kazushinjo/Serrasoid_TRX_29M/docs/回路図論理チェック.md

# 回路図 論理チェック（第 1 回）

> **注意（2026-10-29）**: この記録の部品番号は、2026-10-29 に部品番号を回路図の位置順に振り直す前の旧番号です。現在の番号との対応は [`kicad/refdes_map_2026-10-29.csv`](../kicad/refdes_map_2026-10-29.csv) を見てください。

> **注意（2026-10-16）**: この記録の部品番号は、2026-10-16 に部品番号を回路図の位置順に振り直す前の旧番号です。現在の番号との対応は [`kicad/refdes_map_2026-10-16.csv`](../kicad/refdes_map_2026-10-16.csv) を見てください。

- 対象: `kicad/Serrasoid_TRX.kicad_sch`（回路一覧 `tools/circuit.py`）
- 実施日: 2026-10-15
- 方法: ブロックごとに、定数・ピン配置・電圧・電流・極性を計算とデータシートで確認
- 結果: 誤り・不備 9 件を修正。ERC 違反なし、回路図と回路一覧の接続照合 655 ピン一致。実機は未製作

## 修正した項目

| # | ブロック | 内容 | 修正 |
|---|---|---|---|
| 1 | 制御 | リレー駆動 2SC1815 のベース電流が約 0.5mA。G5V-2（12V、約 42mA）を飽和させるには hFE 最小値で足りない | ベース抵抗 4.7kΩ → **1kΩ**（約 2.6mA） |
| 2 | セラゾイド変調 | MAX913 の出力は TTL（High 2.4〜3.4V）。74HC123 の High 入力（5V 時 3.5V 以上）を満たさない | ワンショットを **74HCT123** に |
| 3 | セラゾイド変調 | MAX913 の LE（5 番）は「High または開放でラッチ、Low で比較動作」（データシート） | ジャンパ J7 を廃止し **LE を GND に固定** |
| 4 | 逓倍 | XOR 逓倍の遅延を「出力周期の 1/4」で計算していた。正しくは**入力周期の 1/4**（出力のデューティ 50%）。旧定数では約 25% | 遅延を 273 / 137 / 68 / 34 / 17ns に（3.9k / 1.8k / 910 / 510 / 330Ω と 100 / 100 / 100 / 82 / 47pF、74AC14 の遅れ約 6ns 込み） |
| 5 | 逓倍 | RC で遅らせたなまった波形を 74AC86 に直接入れていた。AC 品は入力の立ち上がりが遅いと発振・誤動作する | RC の後にシュミットの **74AC14** を入れて整形（反転しても XOR の出力は 2 倍のまま） |
| 6 | 送信RF | 2N3866 のベース分圧（4.7k / 1k）の電流 約 1.4mA が、ベース電流（約 2mA、hFE 25）より小さく、バイアスが下がる | **560Ω / 120Ω**（分圧電流 約 12mA、Ic 約 40mA） |
| 7 | 送信RF | 出力トランス 1:4（ドレイン負荷 12.5Ω）では 13.8V で最大 約 6W しか出ない | **2T:5T（1:6.25、約 8Ω）**で約 10W |
| 8 | 受信 | 2N3819 の Idss のばらつき（2〜20mA）で、ドレイン抵抗 1k の電圧降下が大きいとドレインとソースの電位差がなくなる | ドレインを **10µH チョーク給電**にし、1k は並列の負荷（利得を約 8dB に抑える）に |
| 9 | 受信 | MC3361 の水晶・220pF・6／7 番のコンデンサを GND に落としていた（交流的には同じ） | データシートの試験回路どおり **VCC（+5VA）** へ。ディスクリミネータのダンピングは 20kΩ（データシート値） |

## 確認して問題がなかった項目

### 電源
- L7808 の損失: 送信時 約 110mA × 5.8V ≒ 0.64W（小型放熱器で可）。L7805 は約 50mA × 3V ≒ 0.15W
- L7805 の入力 8V（ドロップアウト 2V に対して 3V の余裕）。78L05 の入力 8V（1.7V に対して 3V）
- LP2950-3.3 の出力コンデンサ 10µF（1µF 以上が必要）
- 電解コンデンサの向き（＋側）と耐圧（13.8V 系は 25V 以上、8V 系は 16V 以上）
- TO-92 / TO-220 のレギュレータのピン順（L78L05・LP2950: 1=出力 2=GND 3=入力、L78xx: 1=入力 2=GND 3=出力）

### 制御
- ESP32-C3 の起動設定ピン: D0（GPIO2）・D8（GPIO8）・D9（GPIO9）はすべて 10k で High に引いてあり、起動時に High
- D10（リレー）・D7（ミュート）は 10k で Low に引いてあり、起動中にリレーが入らない・音が出る
- ADC は D1（GPIO3）・D2（GPIO4）とも ADC1。入力は 3.1V 以下（ノイズ検出は 10k / 22k で分圧、出力検出は最大 約 1.2V）
- 秋月 AE-Si5351A のピン配置（1 VDDO、2 SCL、3 SDA、4 GND、5 CLK0、6 CLK1、7 CLK2、8 VDD）と電源（VDD 2.5〜3.3V）は秋月の資料どおり
- リレーの接点: 1 極目 COM 4・NC 6（受信）・NO 8（送信）、2 極目 COM 13・NC 11（RX8V）・NO 9（TX8V）

### セラゾイド変調
- 74HCT4017 は Si5351 の 3.3V 出力を受けられる（High 入力 2.0V 以上）。9.16MHz は最高動作周波数の範囲内
- 定電流源: ベース 3.7V、エミッタ 4.35V、電流 260〜430µA。のこぎり波の振幅 約 2.45V（100pF ＋ 浮遊容量 約 20pF）で、2SA1015 が飽和しない（コレクタ上限 約 4.0V）
- MAX913: 単電源 5V（V- = GND）、入力範囲 -0.2〜+3.5V にのこぎり波（0〜2.45V）としきい値（約 1.2V）が入る。DIP-8 のピン配置は 1 V+、2 IN+、3 IN-、4 V-、5 LE、6 GND、7 Q、8 Q̄
- 74HCT123: B 入力（2 番）の立ち上がりでトリガ（A = GND、Clr = High）。時定数 4.7k ＋ 10k 半固定 × 100pF で約 300〜760ns（目標 546ns）。2 回路目は入力を固定

### 送信音声
- MCP6004 のピン（A: 1/2/3、B: 7/6/5、C: 8/9/10、D: 14/13/12、電源 4/11）と、＋入力の直流がすべて VREF（2.5V）
- 3kHz LPF（サレンキー）: fc 約 3.3kHz、Q 約 0.73
- 偏移: しきい値 ±27mV でエッジが ±10.8ns 動き、変調部で ±0.062rad、×32 で ±2rad。3kHz で約 ±6kHz（VR で ±5kHz に合わせる。最大は ±55mV）

### 送信RF
- BPF: T-30-6（AL 3.6nH/T²）17 回で約 1.04µH、29.3MHz の同調に約 28pF（22pF ＋ トリマ）
- RD06HHF1・RD16HHF1 のピン（1 ゲート、2 ソース、3 ドレイン、フィン = ソース）。ゲートバイアスは 0〜4.8V で調整可
- ドレインチョーク: FT37-43 10 回 約 35µH、FT50-43 8 回 約 33µH（29MHz で数 kΩ）
- 入力スワンプ 100Ω 1W × 2 の損失は 1 本 約 0.5W
- LPF: 7 次チェビシェフ（0.1dB リプル、fc 32MHz）の計算値 120p / 0.354µH / 208p / 0.391µH（使う値 120p・220p・T50-6 9 回／10 回）
- 出力検出: 10W（31.6Vp）で容量分割後 約 1.4Vp、検波後 約 1.2V

### 受信
- SA612: 電源 5V（4.5〜8V）、局発入力 約 0.3Vp-p（1k / 100Ω の分圧）。局発 18.6MHz（下側）、イメージ 7.9MHz は BPF で落ちる
- MC3361 のピン配置と周辺はデータシート（Motorola MC3361B、Figure 1 試験回路）と照合。第 2 局発 10.245MHz で 455kHz
- LM386: 2 番 GND、3 番入力、電源 RX8V（4〜12V）、出力 220µF、ゾーベル 10Ω ＋ 0.047µF
- スケルチ: ノイズを 7kHz 以上の HPF・利得 47 で増幅し、倍電圧検波（最大 約 4.4V → 分圧で 3.0V）

## 実物で確認が必要な項目

| 部品 | 内容 |
|---|---|
| 10M15A（FL1） | 足の数と順番（基板は HC-49/U 3 本足、1 入力・2 GND・3 出力） |
| CFWLA455KFFA（FL2） | 足の順番（基板は 2.54mm ピッチ 3 本、1 入力・2 GND・3 出力） |
| CDBM455C24（X2） | 2 端子品であること、足のピッチ（基板は 5mm） |
| 2N3819（Q7） | メーカーで足の順番が違う（Fairchild: 1 D 2 G 3 S、onsemi: 1 S 2 G 3 D）。JFET はドレインとソースが対称なので、どちらでも動作はする |
| G5V-2 | コイル定格（標準品 12V 約 42mA）。高感度品でも 1k のベース抵抗で動く |

## ファームウェア側で守ること
- 送信開始: TX_EN（リレー）→ 約 10ms 待つ → CLK1 停止・CLK0 出力。送信終了: CLK0 停止 → 約 10ms 待つ → リレー戻し → CLK1 出力（リレー接点に RF を流したまま切り替えない）
- PTT（D8）・エンコーダ SW（D9）を押したまま電源を入れない（起動設定ピン）

---

# 回路図 論理チェック（第 2 回）

- 実施日: 2026-10-16
- 対象: KiCad で手修正した回路図（4cc1232）。ブロックごとに見直し、データシート（ESP32-C3 の起動設定ピン、SA612 の局発入力、LM386、MAX913）と照合
- 結果: 2 件を修正。ERC 違反なし、接続照合 655 ピン一致、基板（配置・配線を作り直し）DRC エラー 0・未接続 0・回路図との食い違い 0

## 修正した項目

| # | ブロック | 内容 | 修正 |
|---|---|---|---|
| 1 | 制御 | XIAO の D0（GPIO2）は起動設定ピンで、電源投入時に High が必要（GPIO2・GPIO9 が High でフラッシュ起動）。D0 にエンコーダ B 相をつないでいたので、つまみの止まった位置で B 相が GND に落ちていると起動しない | ピンの割り当てを入れ替え: **D0 = PTT 入力**（ふだん開放で High）、**D8 = エンコーダ B 相**（GPIO8 はフラッシュ起動に関係しない） |
| 2 | 受信 | SA612 の局発入力（6 番）はデータシートで 200〜300mVp-p。R54 1kΩ・R55 100Ω の分圧で約 0.30Vp-p と上限ちょうど | **R54 を 1.2kΩ** に（約 0.25Vp-p） |

## 注意点として記録した項目（回路は変更なし）

- C58（RD16HHF1 の出力の DC カット）には約 1.6Arms 流れる。円板ではなく積層セラミック（X7R、100V）を使う（部品表の備考に記載）
- MAX913 にはヒステリシスがない。のこぎり波は速くしきい値を通り過ぎるので通常は問題ないが、出力がばたつく場合は小さな正帰還を足す
- PTT・エンコーダ SW を押したまま電源を入れると起動しない
- 起動時に D6（UART TX）から ESP32 の起動ログが出る（TJC 表示器は無視する）
- 逓倍の遅延は 74AC14 のしきい値（電源の約 0.6 倍 / 約 0.4 倍）と 0.69RC ＝ 入力周期の 1/4 の組み合わせで、安定したあとちょうど 1/4 になる。しきい値の個体差でデューティは少しずれることがある（BPF で落ちる成分）
  - **訂正（2026-10-29）**: 「BPF で落ちる」は誤り。デューティのずれは基準周波数おきの側帯波になり、29.3MHz の隣（±0.92・±1.83MHz）にも出る。2 段の BPF（2pF 結合で過結合）ではほとんど落ちない。下の追補（スプリアス対策）を参照

---

# 回路図 論理チェック（追補: 第 1 混合を NJM2594V に変更）

- 実施日: 2026-10-16
- 内容: SA612AN が製造中止で入手が難しいため、第 1 混合を秋月で買える **NJM2594V**（日清紡マイクロデバイス、ダブルバランスドミキサ、SSOP8）に替え、変換利得の差（SA612 約 +14dB → NJM2594 0dB）を **10.7MHz 増幅 1 段**（2SC1815）で補った。NJM2594V はこの機械で唯一の表面実装部品（ユーザーが了承）
- 照合したデータシート: NJM2594（秋月 njm2594_j.pdf、応用回路「エミッタ・フォロア出力タイプ」）
- 結果: 回路図と circuit.py の照合 678 ピン一致、ERC 0。部品番号は回路図の位置順に振り直し（対応は `kicad/refdes_map_2026-10-16.csv`。追加 11 点、U13 は SA612AN → NJM2594V）

## 接続（データシートとの照合）

| ピン | 名前 | つなぎ先 | データシート |
|---|---|---|---|
| 1 | V+ | +5VA（C53 0.1µF） | 4.5〜9V、11mA |
| 2 | OUTPUT1 | 開放 | エミッタフォロワ出力型では開放 |
| 3 | OUTPUT2 | R48 1kΩ（GND）、C68 → 10.7MHz 増幅 | 負荷抵抗を外付け。RL ≒（V+ − 1.7）÷ Ii → Ii 約 3.3mA（最大 10mA） |
| 4 | GND | GND | |
| 5 | SIGNAL | C63 0.01µF ← 2N3819 のドレイン | 入力 600Ω。0.01µF は 29.3MHz で 0.5Ω |
| 6 | BYPASS | C67 0.1µF（GND） | 信号・キャリアの両方で十分低いインピーダンスに |
| 7 | CARRIER | C64 0.01µF ← R41 1.2kΩ / R45 100Ω ← CLK1 | 入力 1200Ω。規格は 100mVrms（−7dBm）、約 100mV 以上で出力一定 |
| 8 | NC | GND | 接地または開放 |

## 計算

- 局発: CLK1 は 3.3Vp-p の方形波で基本波 約 1.49Vrms。R45 100Ω と入力 1200Ω の並列 92Ω に対し R41 1.2kΩ で約 1/14 → **約 106mVrms**（規格 100mVrms とほぼ同じ）。3 倍の高調波 55.8MHz との混合（45.1MHz・66.5MHz）は受信 BPF の外
- RF 増幅: 2N3819 のドレイン負荷は R42 1kΩ と NJM2594 の入力 600Ω の並列で約 375Ω（SA612 のとき約 600Ω）。利得は約 4dB 下がる
- 10.7MHz 増幅（Q6 2SC1815、エミッタ接地）: ベース R51 22k / R52 4.7k で約 1.41V、エミッタ R54 82Ω ＋ R55 180Ω（C70 でバイパス）で Ie 約 2.9mA、コレクタ R53 1.5kΩ で Vc 約 3.65V（Vce 約 2.9V）。利得 ≒ 1.5k ÷（82 ＋ 9）≒ 16（24dB）、水晶フィルタの入力を負荷にして約 18〜21dB
  - 10.7MHz での 2SC1815 の hfe は fT 80MHz ÷ 10.7 ≒ 7.5 なので入力は約 0.6kΩ。NJM2594 のエミッタフォロワで十分に駆動できる
- 利得の合計（RF 増幅 ＋ 混合 ＋ 10.7MHz 増幅）: 変更前 約 8 ＋ 14 ＝ 22dB、変更後 約 4 ＋ 0 ＋ 20 ＝ 24dB でほぼ同じ
- 電源: +5VA（78L05、100mA）は NJM2594 11mA を足しても余裕。RX8V は 10.7MHz 増幅の約 3mA が増える

## 注意点（実機で確認）

- NJM2594 の雑音指数はデータシートに記載がない。感度が足りなければ R42（RF 増幅の負荷）を外して RF 増幅の利得を上げる
- 10.7MHz 増幅の負荷 R53 1.5kΩ は水晶フィルタ 10M15A の入力側の終端を兼ねる。実物の規格（終端インピーダンス）に合わせて調整する
- 10.7MHz 増幅の発振: 水晶フィルタの入出力を近づけない（基板で確認）
- NJM2594V は SSOP8（0.65mm ピッチ）。部品面に、周りの部品より先に手はんだで付ける

# 回路図 論理チェック（追補: スプリアス対策、Ver 1.2）

- 実施日: 2026-10-29
- 対象: セラゾイド変調・逓倍・PLL（新設）・送信 BPF。部品番号は 2026-10-29 の振り直し後の番号（[`kicad/refdes_map_2026-10-29.csv`](../kicad/refdes_map_2026-10-29.csv)）
- 方法: 逓倍の各段（RC 遅延 → 74AC14 → XOR）を時間領域で計算し、部品のばらつき（R・C ±5%、配線容量 4〜8pF、74AC14 のしきい値、ゲートの遅延 ±1ns）を乱数で 200 通り与えてスペクトルを求めた。BPF・LPF・PLL は伝達関数で掛けた
- 結果: ERC 違反なし、接続照合 835 ピン一致。実機は未製作

## Ver 1.1 の見積り（対策前）

| 周波数 | アンテナ端（設計値） | 備考 |
|---|---|---|
| 27.47MHz（−1.83MHz） | −13.5dBc | 10W なら約 0.45W |
| 31.13MHz（+1.83MHz） | −22.7dBc | |
| 高調波（58.6MHz 以上） | −80dBc 以下 | 7 次 LPF（PA の非線形は含まない） |

- ばらつき込みでは側帯波が搬送波と同じくらいになる。逓倍の途中でエッジが欠け、×32 の出力の周波数そのものが狂う組み合わせも多い
- 規格（30MHz 以下: 50mW 以下かつ −50dBc）を満たすには、最終段のエッジのずれを約 34ps 以下にする必要があり、部品のばらつきでは無理

## 対策（3 つとも入れた）

| 対策 | 内容 | 主な部品 |
|---|---|---|
| 逓倍数を減らす | CLK0 を 18.3125MHz にして ÷10 で 1.83125MHz、×16（4 段）。側帯波の間隔が 1.83MHz に広がる | C71 100p → 68p、R67 4.7k → 2.2k、VR5 10k → 5k（ワンショット 273ns）、段 1（3.9k・100p）と 2 個目の 74AC86 を外した |
| 段間同調 | 段 1〜3 の XOR 出力を LC 並列共振（Q 約 5、調整なし）で正弦波にし、自己バイアスの 74HCU04 で平均値を境に矩形へ戻す（後ろに 74AC14） | 10µH・180p / 4.7µH・100p / 1µH・120p、駆動 1k・1k・470Ω、U22 74HCU04、U23 74AC14 |
| PLL 追従フィルタ | ×16 の出力に 29.3MHz の VCO を位相同期させ、VCO を送信する。ループ帯域 約 37kHz | U1 74AC74・U3 74AC00（位相周波数比較）、U7 MCP6002（差動積分）、U11 74HCU04（VCO 専用）、L5 T50-6 15T、D4 1N4007（可変容量）、TC3 |

あわせて送信 BPF の段間結合を 2pF → 1pF（C80）。29.0〜29.7MHz の偏差 0.6dB 以内、±1.83MHz で −14〜−17dB。

## 計算

- ×16 の出力（PLL の前）: 同調なしでは 200 通り中 160 通りでエッジが欠ける。同調ありでは 0 通り、側帯波は中央 −11.5dBc
- PLL: Kd ＝ 5V/2π ≒ 0.8V/rad、Kv ≒ 0.2MHz/V（1N4007、0.5〜4.5V で約 20〜9pF、47p で結合）、τ1 ＝ 11.2k × 0.01µ、τ2 ＝ 1.5k × 0.01µ、極 258kHz（入力 RC）・339kHz（出力 RC）・MCP6002 の GBW。閉ループ −3dB 約 37kHz（Kv が半分〜2 倍で 21〜75kHz）、3kHz での利得 ＋0.3dB
- PLL の減衰: ±0.5MHz −40dB、±1.83MHz −77dB、±3.66MHz −100dB
- アンテナ端（PLL・BPF・LPF 後、±1〜8 × 1.83MHz の側帯波）: 中央 −110dBc、悪い 5% −103dBc、最悪 −99dBc
- 偏移: ×16 なので変調部の位相は ±0.104rad（3kHz で ±5kHz）。のこぎり波（68p ＋ 浮遊 約 20p、約 300µA）は約 3.4V/µs、エッジ ±9ns はしきい値 ±31mV。音声の最大 ±55mV に収まる
- VCO: L5 約 0.9µH、C 側 27p ＋ TC3 ＋ 可変容量、出力側 56p ＋ 浮遊 で直列 約 31pF → 約 29.3MHz（TC3 で合わせる）。可変容量の範囲は約 0.8MHz（29.0〜29.7MHz をほぼ覆う）

## 注意点（実機で確認）

- 74HCT4017 を 18.3MHz で動かす（最高クロックは 5V・最悪条件で約 20MHz）。分周がおかしいときは CLK0 の波形（リンギング）と電源電圧を見る
- 1N4007 の接合容量は品物で違う。29.0MHz と 29.7MHz で VT（TP1）が 0.5〜4.5V に入るか確かめる。足りなければ C35（47p）を大きくするか、可変容量ダイオードに替える
- 受信中は Q3 で VCO を止める。受信で 29.3MHz 付近に自局の VCO が聞こえないことを確かめる
- 受信中、74HCU04（U22）の同調側の 3 回路はしきい値付近に止まり、少し電流が流れる（数 mA）。後ろはシュミットの 74AC14 なのでばたつかない
- PLL が外れると VCO が勝手な周波数で出る。送信前に VT が張り付いていないことを見る（ファームウェアで VT を読む線は今はない）
- 受信 BPF も 2pF 結合（過結合）のまま。受信は帯域が広くても実害が小さいので変えていない

# 回路図 論理チェック（追補: S メーターの追加、Ver 1.2）

- 実施日: 2026-10-29
- 理由: MC3361 には受信電界強度（RSSI）の出力がなく、スケルチ用ノイズの減り方からの S 表示は S5 前後で頭打ちになる。S9 より上まで振れる S メーターにするため、対数増幅 IC を足した（ユーザーが案 B を選択）
- 結果: ERC 違反なし、接続照合 888 ピン一致。実機は未製作

## 回路

| 部分 | 部品 | 内容 |
|---|---|---|
| 取り出し | R1 2.2k、C8 0.01µ | 10.7MHz 水晶フィルタの出力（IF1、MC3361 の 16 番）から取る。増幅の入力（約 2.5kΩ）と直列で、フィルタの終端に重い負荷をかけない（約 −5dB） |
| 同調増幅 | Q1 2SC1815、R4 22k・R5 4.7k（ベース 約 1.4V）、R6 27Ω（帰還）・R7 220Ω＋C18、L3 4.7µH・C23 47p | Ic 約 3mA。負荷は同調回路と AD8307 の入力 1.1kΩ で約 0.75kΩ、利得 約 21 倍（26dB）。同調（約 10.7MHz、Q 約 2）は AD8307 に広帯域の雑音を入れないため |
| 対数増幅 | U9 AD8307ANZ（DIP-8）、C26・C27 0.01µ（入力の結合）、C30 0.01µ（OFS）、R17 10Ω・C38 0.1µ（電源） | 25mV/dB、測れる範囲 −75〜＋17dBm（データシート）。+5VA（受信中だけ）。INT は開放、ENB は VPS へ |
| 出力 | C40 0.1µ、U13 ADS1115 モジュール（A0） | 出力抵抗 12.5kΩ と 0.1µ で約 1.3ms。ADS1115 は +3V3X、±4.096V レンジ（1LSB = 0.125mV = 0.005dB）。I2C アドレス 0x48（Si5351 は 0x60） |

## 計算

- 受信の利得（アンテナ → IF1）: 受信 BPF −2dB、2N3819 約 ＋4dB、NJM2594 0dB、10.7MHz 増幅 約 ＋19dB、水晶フィルタ −3dB → 約 ＋18〜19dB
- AD8307 の入力: S9（−73dBm）で約 −73 ＋ 19 − 5 ＋ 26 ＝ **約 −33dBm** → 出力 25mV ×（−33 ＋ 84）≒ **1.27V**（スケッチの `RSSI_MV_S9` の初期値 1275mV）
- 下限 −75dBm は S9 より 42dB 下 ≒ **S2**、上限 ＋17dBm は S9 ＋ 50dB。受信の前段（NJM2594・10.7MHz 増幅）が飽和する手前の **S9＋40 程度**までが目安
- ADS1115 の入力は 0.2〜2.5V で、+3V3X（3.3V）を超えない

## 注意点（実機で確認）

- S9 の電圧（`RSSI_MV_S9`）は、信号発生器で −73dBm を入れてシリアルモニタの `rssi` の値で合わせる
- R1 2.2kΩ を付けたことで、水晶フィルタ（10M15A）の終端が少し変わる。受信音のひずみ・帯域が変わらないか確かめる。気になるときは R1 を 4.7kΩ に（S メーターの下限が 6dB 上がる）
- Q1 の同調増幅が発振しないか（入出力の線を近づけない）
- ADS1115 モジュールは Adafruit 1085 と同じピン並び（VDD GND SCL SDA ADDR ALRT A0 A1 A2 A3）のものを使う。並びの違う品は差し替えない
- スケッチは ADS1115 が見つからないとき、ノイズの減り方からの S 表示に切り替わる

# 回路図 論理チェック（追補: 入手しにくい部品の置き換え、Ver 1.2）

- 実施日: 2026-10-29
- 理由: 74HCT4017（製造中止）、MAX913（製造中止扱いの販売店が多い）、2N3866（製造中止）が手に入りにくいため（ユーザーの依頼）
- 結果: ERC 違反なし、接続照合 875 ピン一致。実機は未製作

| 取り外した部品 | 代わり | 内容 |
|---|---|---|
| 74HCT4017（18.3125MHz を ÷10） | Si5351 の CLK0 を 1.83125MHz に、U19 74HCT123 の 2 回路目でリセットパルス | CLK0 の立ち上がり（2B）でトリガ、C84 22p・R75 1.5k で約 50〜100ns。HCT 品なので 3.3V 入力を受けられる。IC が 1 個減る |
| MAX913（高速コンパレータ） | Q9・Q10 2SA1015 の差動対、R74 1.5k（電流源）、R73 1k（負荷） | 電流 約 2.3mA。RAMP > THRESH で COMP_N が約 2.3V → 0V。U19 の 1A（立ち下がり）で PM_OUT を作る（1B・Clr は High） |
| 2N3866（TO-39） | Q11 2N2222A（TO-92） | エミッタ帰還 4.7Ω ＋ 18Ω（旧 10Ω）で約 33mA、コレクタ損失 約 0.24W。fT 250MHz 以上で 29MHz の利得は十分 |

## 計算

- 差動対: エミッタ 約 0.85 ＋ 0.65 ＝ 1.5V、電流 (5 − 1.5) ÷ 1.5k ≒ 2.3mA。切り替わりの幅は入力差 ±4Vt ≒ ±100mV、のこぎり波 3.4V/µs で約 30ns。遅れは一定（位相のずれにならない）
- COMP_N は 0〜2.3V。74HCT123 の入力（Low 0.8V 以下・High 2.0V 以上）に入る
- Q9 のベース電流（約 11µA）がのこぎり波に加わるのは交点の手前だけで、交点付近では毎回同じなので直線性には影響しない（定電流 約 300µA の 4% 程度）
- リセットパルス: 幅が 50〜100ns の間で変わっても、のこぎり波の山（約 1.5〜1.7V）が少し変わるだけ。VR2 で合わせる

## 注意点（実機で確認）

- Q9・Q10 は同じランク（GR）のものを使う。Vbe の差は VR4（しきい値の中心）で吸収
- TP5（COMP）の波形がばたつくときは、R73 に 10pF 程度を並列に
- リセットパルスの幅を TP（2N7000 のゲート）で確かめる。短すぎてのこぎり波が 0V まで戻らないときは C84 を 33p に
- スケッチの CLK0 は送信周波数 ÷ 16（2026-10-29 に変更済み）

# 回路図 論理チェック（追補: 終段を IRF510 プッシュプルに、Ver 1.2）

- 実施日: 2026-10-29
- 理由: RD06HHF1・RD16HHF1 が製造終了（RF Parts の表記で RD16HHF1-501 は 2022 年 12 月 EOL）で、在庫品は偽物の心配もあるため（ユーザーが IRF510 プッシュプルを選択）
- 結果: ERC 違反なし、接続照合 882 ピン一致。実機は未製作

## 回路

| 段 | 部品 | 内容 |
|---|---|---|
| ドライバ | Q12 IRF510（RD06HHF1 から変更）、VR6 | 回路はそのまま（ゲートストッパー 10Ω・スワンプ 47Ω・バイアス TX8V → 3.3k ＋ VR 5k → 1k、ドレインチョーク FT37-43）。アイドル 約 150mA。IRF510 はピンが G-D-S（RD06HHF1 は G-S-D）で、記号・接続を直した |
| 入力トランス | T1 BN43-202、1 次 2 回・2 次 2 回（センタータップ） | ドライバの出力を 2 個のゲートへ逆相に。センタータップに R92 1k でバイアス、C 0.1µ で交流的に GND |
| ゲート | R 10Ω × 2（ストッパー）、R 22Ω 1/2W × 2（各半分のスワンプ） | ドライバから見た負荷 約 44Ω（1:1）。IRF510 の入力容量（約 180pF）を抑えて安定にする |
| ファイナル | Q14・Q13 IRF510、VR7 | AB 級プッシュプル。アイドル 合計 約 100mA。ゲート約 3.5〜4V |
| 出力トランス | T2 BN43-202、1 次 2 回（センタータップから 13.8V）・2 次 3 回 | 1:2.25 でドレイン間 約 22Ω → 50Ω。ドレインの直流は 1 次の両半分を逆向きに流れるので、コアは飽和しない。旧ドレインチョーク（FT50-43）と結合コンデンサは不要になった |

## 計算

- 出力: 13.8V で各ドレインの振幅 約 12V（飽和電圧を引く）、ドレイン間 22Ω → 理論 約 13W。29MHz では IRF510 の利得と効率が下がる（製作例: 28MHz・14V で 2〜6W、QRP Labs のキットは 28MHz で利得が下がると説明）ので、**5W 前後の見込み**
- 駆動: ファイナルの入力に 0.3〜0.5W 程度。ドライバ IRF510（約 10dB）でバッファ 2N2222A の約 30mW から持ち上げる
- 発熱: 5W 出力・効率 40% として、ファイナル 2 個で約 7W、ドライバ 約 2W。3 個ともタブ = ドレイン（+13.8V）なので、絶縁シートと絶縁ブッシングで放熱器から絶縁する
- 高調波: プッシュプルなので偶数次が打ち消し合う（2 倍 −35dBc 程度を仮定）。スプリアスの図は 5W で描き直した

## 注意点（実機で確認）

- 放熱器と各ドレインが導通していないこと（テスター）
- アイドル電流は VR を絞った側（ゲート 0V）から少しずつ上げる。IRF510 はしきい値のばらつきが大きいので、2 個の電流の差が大きいときは選別する
- 出力が足りないときは、ファイナルのバイアスを少し上げる（QRP Labs の説明と同じ）か、出力トランスを 1 次 2 回・2 次 2 回（1:1、ドレイン間 50Ω → 出力は下がるが効率は上がる）と比べる
- 送受切替のリレー・LPF・出力検出は変わらない。出力計の `FWD_MV_10W` は実測で合わせる

# 回路図 論理チェック（追補: ファイナルを MRF101AN に、Ver 1.2）

- 実施日: 2026-10-29
- 理由: IRF510 プッシュプルでは 29MHz・13.8V で 5W 前後しか見込めないため、10W に戻す（ユーザーが MRF101AN を選択）
- 結果: ERC 違反なし、接続照合 875 ピン一致。実機は未製作

## 回路

| 段 | 部品 | 内容 |
|---|---|---|
| ドライバ | Q12 IRF510、VR6 | 前回のまま（アイドル 約 150mA、タブ = ドレインなので HS1 から絶縁） |
| ファイナル | Q13 MRF101AN、VR7 | 単段の AB 級に戻した（RD16HHF1 のときと同じ回路）。ゲートストッパー 10Ω、スワンプ 100Ω 1/2W × 2（50Ω）、バイアス TX8V → 3.3k ＋ VR 5k → 1k。ドレインチョーク FT50-43 8 回、結合 0.1µF（X7R 100V）、出力トランス BN43-202 2 回:5 回（8Ω → 50Ω） |
| 取り除いた部品 | 入力トランス（1:1 センタータップ）・ファイナル B・22Ω × 2・10Ω 1 本・センタータップ付きのフットプリント 2 種 | |

## データシート（NXP MRF101AN Rev. 1）で確かめたこと

- ピン: **1 = ゲート、2 = ソース、3 = ドレイン、タブ（裏面）= ソース**。RD16HHF1 と同じ並びなので、記号（RD_MOSFET_GSD）・フットプリント（TO-220 縦置き）はそのまま。MRF101BN はゲートとドレインが逆なので使えない
- VGS(th) 1.7〜2.7V（標準 2.2V）、VGS(Q) 2.5V（50V・100mA）。ゲートの最大定格は −6〜+10V。バイアス回路の可変範囲は 0〜約 4.8V で、最大定格を超えない
- Ciss 149pF（50V のとき。13.8V では少し大きい）→ 29MHz で約 37Ω。スワンプ 50Ω と並列で入力は 20Ω 前後
- V(BR)DSS 133V、定格 VDD 50V。13.8V では十分な余裕があり、負荷の不整合にも強い（50V で VSWR 65:1 に耐える）
- RθJC 1.1℃/W、PD 182W

## 計算

- 出力: 13.8V、ドレイン負荷 8Ω → 理論 (13.8 − 1)² ÷ (2 × 8) ≒ 10W
- 利得: データシートの 27MHz の例は 50V で 24.9dB。13.8V では下がるので **17dB 前後** と見込む → 10W に必要な入力は 0.2〜0.3W。ドライバ IRF510 で足りる
- 発熱: 10W・効率 55% として約 8W（ケースの放熱器 5〜8℃/W ＋ RθJC 1.1℃/W で、接合部は周囲 + 60℃程度）
- アイドル電流: 約 200mA（ゲート 2.5〜3V）
- スプリアスの図は 10W・単段の仮定に戻した（高調波 最大 −72.5dBc、2 倍）

## 注意点（実機で確認）

- 13.8V での利得・出力はデータシートにない（50V の特性のみ）。出力が 10W に届かないときはドライバのバイアスを少し上げるか、出力トランスを 2 回:4 回（1:4、12.5Ω → 約 7W）と比べて効率を見る
- 利得が大きいので発振に注意。ゲートストッパー 10Ω はゲートのピンの根元に付ける。ドライブなしで出力が出るときは、スワンプを 47Ω × 2 にする
- MRF101AN の静電気（HBM 1000V）に注意。取り付けまで導電スポンジに刺しておく
