kazushinjo/Serrasoid_TRX_29M/docs/基板チェック.md

# 基板チェック（第 1 回）

> **注意（2026-10-29）**: この記録の部品番号は、2026-10-29 に部品番号を回路図の位置順に振り直す前の旧番号です。現在の番号との対応は [`kicad/refdes_map_2026-10-29.csv`](../kicad/refdes_map_2026-10-29.csv) を見てください。

> **注意（2026-10-16）**: この記録の部品番号は、2026-10-16 に部品番号を回路図の位置順に振り直す前の旧番号です。現在の番号との対応は [`kicad/refdes_map_2026-10-16.csv`](../kicad/refdes_map_2026-10-16.csv) を見てください。

- 対象: `kicad/Serrasoid_TRX.kicad_pcb`（回路図から `tools/gen_pcb.py` → `tools/route.sh` で作成。2026-10-16 に論理チェック第 2 回の修正を反映して作り直し）
- 実施日: 2026-10-15
- 結果: **DRC エラー 0、未接続 0、回路図との食い違い 0**。警告はシルク（部品番号の文字の重なり 20・銅箔上 9・基板端 3）のみ。実機・製造データは未作成

## 基板の構成

| 項目 | 内容 |
|---|---|
| 外形 | 170 × 130mm、M3 取付穴 4 か所（四隅から 4mm） |
| 層 | 4 層。表・裏 = 信号（空きは GND ベタ）、内層 2 枚 = GND（GND1・GND2） |
| 部品 | 242 点、すべてリード部品（表面実装なし） |
| 配置 | 機能ブロックごとの区画の中で、配線長が短くなるように自動配置（`tools/place.py`）。固定は DC 入力・ANT・リレー・RD16HHF1 だけ |
| 配線 | Freerouting 1.9.0。線幅: 13.8V 系・PA 出力 1.2mm、電源 0.6mm、RF 0.5mm、ほか 0.3mm |

区画（上辺 = 後面、下辺 = 前面）:

| 区画 | 範囲（mm） |
|---|---|
| 電源 | 左上 0〜40 × 0〜46 |
| 送信RF | 上段 40〜170 × 0〜46（左から BPF → 2N3866 → RD06HHF1 → RD16HHF1 → LPF → リレー → ANT） |
| 逓倍 | 0〜52 × 46〜82 |
| セラゾイド変調 | 52〜112 × 46〜82 |
| 受信 | 右列 112〜170 × 46〜130 |
| 制御 | 左下 0〜56 × 82〜130 |
| 送信音声 | 56〜112 × 82〜130 |

## 確認した項目

- 回路図との一致（DRC の schematic parity）: 食い違いなし
- 13.8V（最大 約 2.5A）の線幅 1.2mm: 外層 1oz で約 3A（温度上昇 10℃）まで
- GND: 内層 2 枚のベタで全 GND パッドがつながる。表・裏のベタは熱的接続（サーマル）で 1 本以上（`kicad/Serrasoid_TRX.kicad_dru`）
- RD16HHF1（Q6）は上辺（後面）に、タブを外側に向けて配置
- RD06HHF1（Q5）と放熱器 HS1（20PB020）は PSN_TRX と同じ位置関係
- アンテナ系: J5（ANT）→ K1（リレー）は基板の右上角で短い（ANT 29mm、TX_OUT 48mm）

## 気になる点（製造前に確認・手直しを検討）

| 項目 | 内容 |
|---|---|
| 長い線 | DRV_D（RD06HHF1 のドレイン → RD16HHF1 入力の結合 C）82mm、CLK0 71mm、CLK1 73mm、PM_OUT 58mm、RAMP 53mm。29MHz の波長（約 10m）に比べれば短く電気的には問題ないが、PA 出力と入力系の結合を避けるため、KiCad で目視確認したい |
| RD16HHF1 の取付 | タブは基板端から約 1mm 内側。シャーシの放熱器に当てるには、基板端とタブの位置関係をケースと合わせて決める必要がある |
| L7808・L7805 の放熱 | 縦置き TO-220。小型放熱器（クリップ式など）を付ける空間があるか要確認 |
| シルク | 部品番号の文字の重なり 19 か所（実装には影響しない） |
| 受信部の並び | 自動配置のため、LM386（低周波）が RF 部の近くに来ている。発振・回り込みが出るようなら離す |

## 配置の試行

送信の主要部品（BPF・2N3866・RD06HHF1・トランス）と受信の主要部品も固定して一列に並べる案を試したが、配線長の合計が増え、未接続が 2〜3 本残ったので採用しなかった（`tools/gen_pcb.py` の `fixed_positions` のコメント参照）。

---

# 基板チェック（第 2 回: Ver 1.1、第 1 混合を NJM2594V に変更して作り直し）

- 実施日: 2026-10-16
- 対象: `kicad/Serrasoid_TRX.kicad_pcb`（`tools/gen_pcb.py` → `tools/route.sh`。部品番号は回路図の位置順）
- 結果: **DRC エラー 0、未接続 0、回路図との食い違い 0**。警告はシルク（文字の重なり 33・銅箔上 10・基板端 4）のみ

## 変更点

| 項目 | 内容 |
|---|---|
| 部品 | 253 点（＋取付穴 4・放熱器 HS1）。第 1 混合 U13 を SA612AN（DIP-8）から **NJM2594V（SSOP8、0.65mm ピッチ、表面実装）** に。10.7MHz 増幅（Q6 2SC1815 ほか 10 点）を追加 |
| 表面実装 | U13 だけ（部品面）。`gen_pcb.py` は NJM2594V 以外の表面実装パッドがあると止まる |
| U13 の GND | 4 番から外側へ 1.8mm の線とビアで内層の GND へ（`tools/pcb_smd_gnd.py`。0.65mm ピッチのパッドの間には外層の GND ベタが入らない）。8 番（内部で未接続）は開放 |
| +5VA の線幅 | 0.6 → **0.3mm**（約 25mA。0.6mm では U13 のパッドに隣のパッドとの間隔 0.25mm を取ってつなげない） |
| 配置 | ミキサー出力 → 10.7MHz 増幅 → 水晶フィルタのネットの重みを大きくし、1 か所にまとめた（U13〜Q6 16.6mm、Q6〜FL1 12.1mm） |
| 上辺の部品禁止 | ケースの RD16HHF1 用放熱器のベースが基板の上辺に 1.1mm かかるので、RD16HHF1 の左右（放熱器の幅）の上辺から 1.6mm には部品を置かない（HS1 は上辺から 3.25mm） |
| 配線 | Freerouting 1.9.0 のあと、残った未接続は `tools/fix_route.py`（表・裏 2 層の格子で探して引く。間隔 0.25mm）で引く。今回は CLK1 と C74 の短い線が重なっていたので消して引き直した |

## 製造前に確認すること

- U13（SSOP8）のパッド寸法は KiCad 標準の TSSOP-8_4.4x3mm_P0.65mm（JRC の SSOP8 は本体 3.5 × 4.4mm、足先 6.4mm で同じ寸法）
- 10.7MHz 増幅の入出力の線が近くを通っていないか（発振しないか）、KiCad で目視

---

# 基板チェック（第 3 回: Ver 1.2、スプリアス対策で逓倍の段間同調と PLL を追加）

- 実施日: 2026-10-29
- 対象: `kicad/Serrasoid_TRX.kicad_pcb`（`tools/gen_pcb.py` → `tools/route.sh`）。部品番号は 2026-10-29 の振り直し後（[`kicad/refdes_map_2026-10-29.csv`](../kicad/refdes_map_2026-10-29.csv)）
- 結果: **DRC エラー 0、未接続 0、回路図との食い違い 0**。警告はシルク（文字の重なり 35・銅箔上 22・基板端 14）のみ。配線 合計 約 7.65m、ビア 19

## 変更点

| 項目 | 内容 |
|---|---|
| 外形 | 170 × 130mm → **170 × 140mm**（奥行きを 10mm 伸ばした。部品 305 点、130mm では置き場所が足りなかった）。ケースは基板の前端と前面パネルの間が 32 → 22mm になる |
| 区画 | 電源 0〜40 × 0〜40、送信RF 40〜170 × 0〜46、セラゾイド変調 0〜30 × 40〜100、逓倍 30〜72 × 46〜100、**PLL 72〜122 × 46〜100**、受信 122〜170 × 46〜140、制御 0〜70 × 100〜140、送信音声 70〜122 × 100〜140 |
| 部品禁止 | 後面の DC ジャック（ケース X 27、本体 φ12・奥行き 15mm）の下、基板の左奥（5〜19 × 0〜13mm）。最初の配置で L7808 がここに来て、ケースの assert「DC の本体が基板の部品に当たる」になった |
| 配置の重み | VCO の LC（VCO_IN・VCO_OA・VCO_O・VCO_L・VAR_K）と段間同調（TK1〜3・SQ1〜3）をミキサーと同じ重みにしてまとめた（VCO_O 10mm、VCO_L 11mm、VAR_K 10mm。VCO_IN は Q3・TC3・R24 も含めて 77mm） |
| 線幅 | TXOSC（VCO → 送信 BPF）を 0.5mm（RF） |
| シルク | Ver 1.1 → Ver 1.2 |

## 製造前に確認すること

- 区画から少しはみ出した部品が 12 点ある（区画の境目、隣の区画側）。機能上の問題はないが、KiCad で目視
- VCO（U11・L5・TC3・D4 のまわり）の近くに、逓倍のロジックの線（X16・TK3 など）が並走していないか
- 74HCU04（U22・U11）と 74AC14（U20・U23）の取り違えに注意（ピン配置は同じ）

---

# 基板チェック（第 4 回: Ver 1.2、S メーター（AD8307・ADS1115 モジュール）を追加）

- 実施日: 2026-10-29
- 対象: `kicad/Serrasoid_TRX.kicad_pcb`（`tools/gen_pcb.py` → `tools/route.sh`）。部品番号は 2026-10-29 の 3 回目の振り直し後（[`kicad/refdes_map_2026-10-29.csv`](../kicad/refdes_map_2026-10-29.csv)）
- 結果: **DRC エラー 0、未接続 0、回路図との食い違い 0**。警告はシルク（文字の重なり 39・銅箔上 15・基板端 7）のみ。配線 合計 約 8.43m、ビア 32

## 変更点

| 項目 | 内容 |
|---|---|
| 外形 | 170 × 140mm → **170 × 150mm**（S メーターの部品 19 点と ADS1115 モジュールで置き場所が足りなくなった）。ケースは基板の前端と前面パネルの間が 12mm になる（干渉チェック通過） |
| 区画 | 電源 0〜40 × 0〜40、送信RF 40〜170 × 0〜44、セラゾイド変調 0〜30 × 40〜104、逓倍 30〜72 × 44〜104、PLL 72〜118 × 44〜104、**受信 118〜170 × 44〜150**、制御 0〜70 × 104〜150、送信音声 70〜118 × 104〜150 |
| ADS1115 モジュール | 独自フットプリント `ADS1115_Module_Socket`（ピンソケット 1×10 ＋ モジュールの基板 28 × 17.8mm の範囲を外形に含める）。モジュールの下にほかの部品が来ない |
| 配置の重み | S メーター増幅（RS_IN・RS_B・RS_C・RS_E・RS_INP・RS_INM）をミキサーと同じ重みにしてまとめた |

## 製造前に確認すること

- 区画から少しはみ出した部品が 25 点ある（区画の境目、隣の区画側）。KiCad で目視
- AD8307（U9）の入力の線が、10.7MHz 増幅（Q3 のまわり）や 455kHz の線と並走していないか
- ADS1115 モジュールの向き（ピンの列の +X 側にモジュールの基板が乗る）を、実物のピン並びと照合

---

# 基板チェック（第 5 回: Ver 1.2、入手しにくい部品の置き換え）

- 実施日: 2026-10-29
- 結果: **DRC エラー 0、未接続 0、回路図との食い違い 0**。配線 合計 約 8.15m、ビア 22
- 変更: 74HCT4017（DIP-16）・MAX913（DIP-8）と各パスコンを外し、2SA1015 × 2（差動対）・抵抗 3・TP・22p を追加。2N3866（TO-39）を 2N2222A（TO-92）に。配置・配線は作り直し
- Freerouting の後に、長さ 0.1mm 未満の極小の配線（13 本）が残り、うち 1 本が隣のネット（Net-(R100-Pad2) と Net-(C123-Pad2)）と重なってショートになった。極小の配線を消し、重なった付近の 2 ネットを消して `tools/fix_route.py` で引き直して解消

---

# 基板チェック（第 6 回: Ver 1.2、終段を IRF510 プッシュプルに）

- 実施日: 2026-10-29
- 結果: **DRC エラー 0、未接続 0、回路図との食い違い 0**。配線 合計 約 8.7m、ビア 30
- 変更: ドライバ・ファイナルを IRF510 に（ファイナルは 2 個、ケースの放熱器の中心 X 122.54 の左右 7.62mm に固定: Q14 112.38、Q13 127.62）。BN43-202 のセンタータップ付きフットプリント `Transformer_BN43-202_SP`・`_SS`（5 ピン）を追加。送信 RF の区画を 0〜44 → 0〜48mm に広げ、逓倍・PLL・受信の上端を 48mm に
- 配置の後に長さ 0.1mm 未満の極小の配線 19 本を消し、`tools/fix_route.py` で残りを引いた
- ドライバの放熱器 HS1 とケースの放熱器は、IRF510 のタブ（ドレイン）から絶縁して取り付ける

---

# 基板チェック（第 7 回: Ver 1.2、ファイナルを MRF101AN に）

- 実施日: 2026-10-29
- 結果: **DRC エラー 0、未接続 0、回路図との食い違い 0**。警告はシルク（文字の重なり 38・銅箔上 12・基板端 5）のみ。配線 合計 約 8.16m、ビア 18
- 変更: IRF510 プッシュプル（第 6 回）をやめ、ファイナルを MRF101AN 1 個に。回路は RD16HHF1 のときと同じなので、部品の位置は第 5 回と同じ（Q13 をケースの放熱器の中心 X 122.5 に固定、取付ねじ 1 本）。ドライバ Q12 は IRF510 のまま
- MRF101AN のタブはソース（GND）なので、ケースの放熱器にそのまま当ててよい（ドライバ IRF510 だけ HS1 から絶縁する）
- 部品の位置が変わらないので、ケース（`enclosure/`）は第 5 回の形に戻した（干渉チェック通過）
