kazushinjo/Serrasoid_TRX_29M/docs/images/layout_full.png

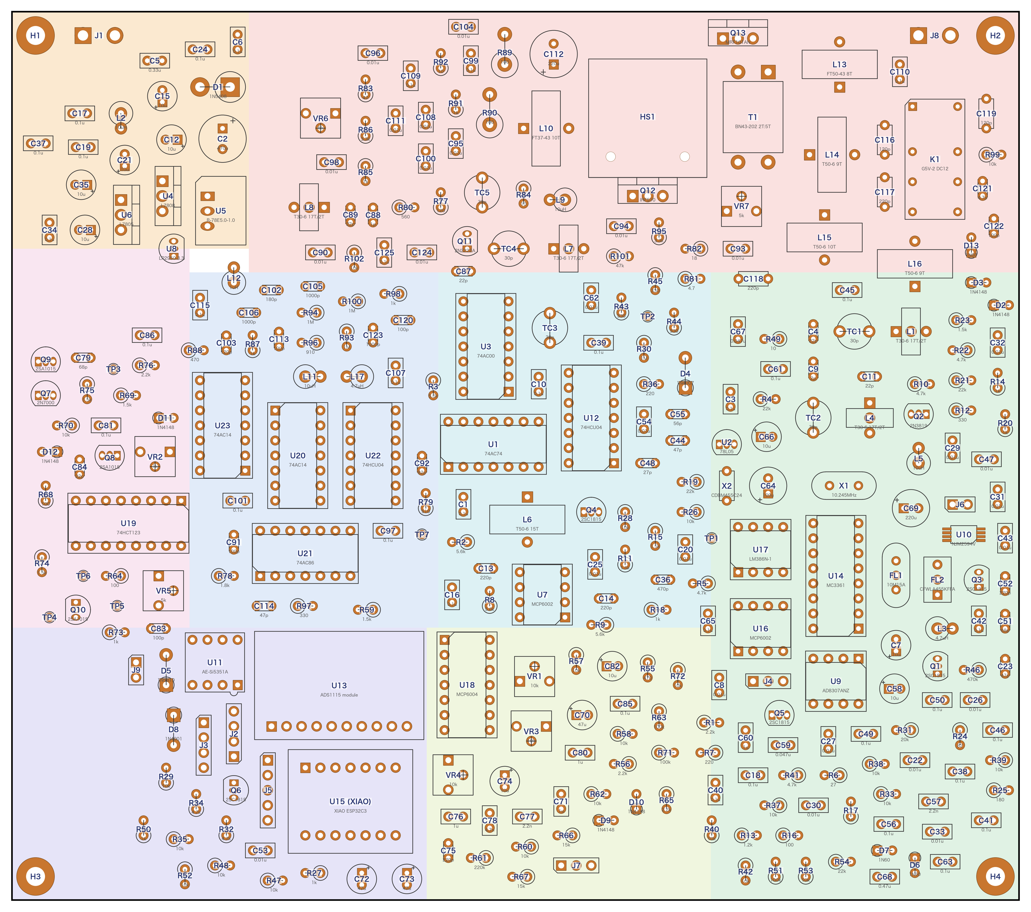
docs/images/layout_full.png
