kazushinjo/Serrasoid_TRX_29M/docs/images/spurious_calc_0-300MHz.png

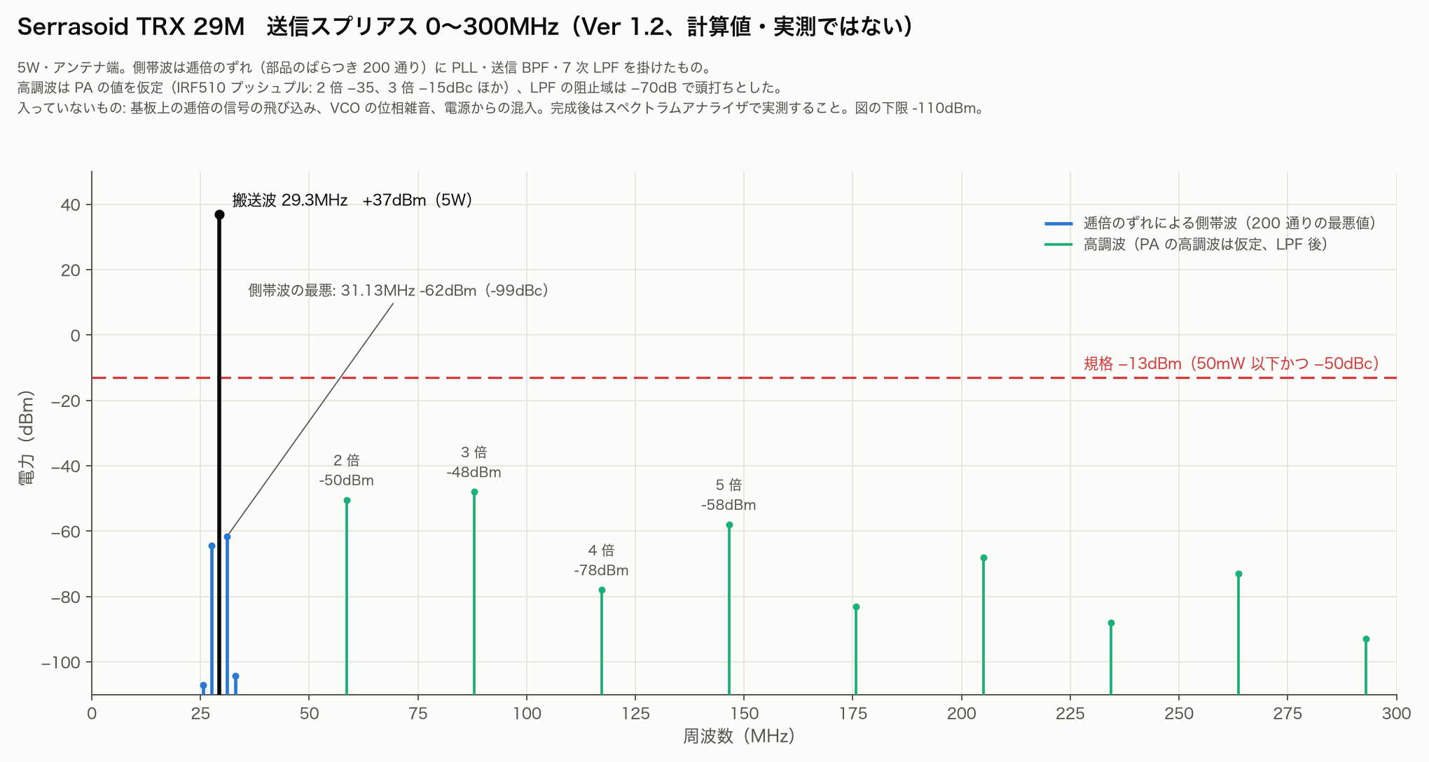
docs/images/spurious_calc_0-300MHz.png
