kazushinjo/Serrasoid_TRX_29M/enclosure/preview/front_panel_3d.png

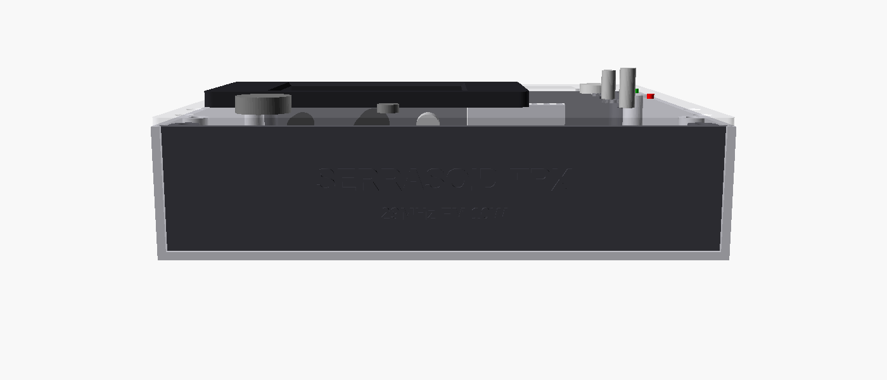
enclosure/preview/front_panel_3d.png
