kazushinjo/Serrasoid_TRX_29M/enclosure/preview/speaker_holder.png

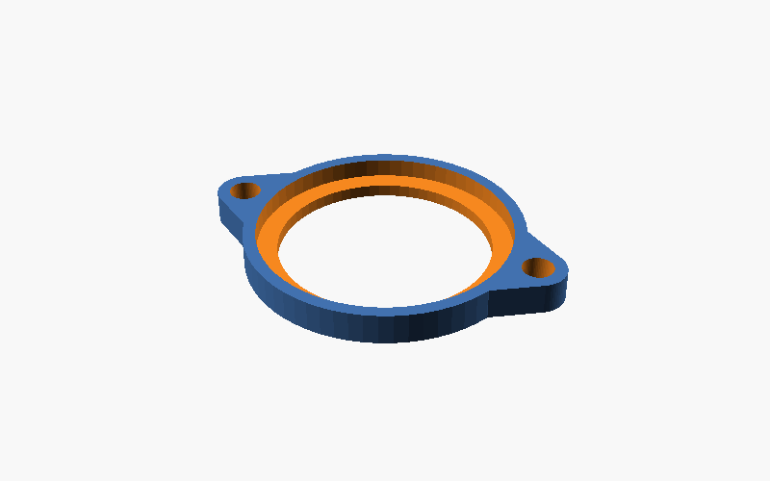
enclosure/preview/speaker_holder.png
