kazushinjo/Serrasoid_TRX_29M/firmware/Serrasoid_TRX/nextion/background.png

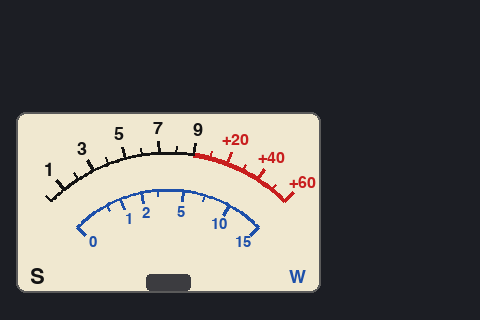
firmware/Serrasoid_TRX/nextion/background.png
