kazushinjo/Serrasoid_TRX_29M/kicad/BOM.md

# Serrasoid TRX 29M 部品表（BOM）

回路一覧 `tools/circuit.py` から `tools/gen_bom.py` で生成。回路図 `Serrasoid_TRX.kicad_sch` と同じ内容。

- 部品はリード部品。第 1 混合の NJM2594V（U13）だけ表面実装（SSOP8、0.65mm ピッチ。SA612 が製造中止のため）
- IC はすべて丸ピン IC ソケットを使う前提のフットプリント
- 基板専用部品（回路図にない）: RD06HHF1 の放熱器（秋月 20PB020）、取付穴

## 抵抗 R

| Reference | 値 / 型番 | フットプリント | 数量 | 購入先 | 購入先の型番（販売コード） | 備考 |
|---|---|---|---|---|---|---|
| R1, R56, R65, R76 | 2.2k | R Axial DIN0207 L6.3mm D2.5mm P2.54mm Vertical | 4 | 秋月電子 | CF25J2K2B（125222） | R1: 取り出し。水晶フィルタの終端（MC3361 の入力）に重い負荷をかけないため<br>R56: エレクトレットのバイアス<br>R65: IDC（クリップ） |
| R2, R3, R8, R9 | 5.6k | R Axial DIN0207 L6.3mm D2.5mm P2.54mm Vertical | 4 | 秋月電子 | RD25S 5K6（125562） |  |
| R4, R19, R21, R54 | 22k | R Axial DIN0207 L6.3mm D2.5mm P2.54mm Vertical | 4 | 秋月電子 | CF25J22KB（125223） | R4: S メーター増幅のベースバイアス（約 1.4V）<br>R21: 10.7MHz 増幅のベースバイアス（約 1.4V）<br>R54: ADC 入力を 3.1V 以下に |
| R5, R10, R22, R32, R34, R41 | 4.7k | R Axial DIN0207 L6.3mm D2.5mm P2.54mm Vertical | 6 | 秋月電子 | CF25J4K7B（125472） | R10: Q 調整<br>R32, R34: I2C プルアップ |
| R6 | 27 | R Axial DIN0207 L6.3mm D2.5mm P2.54mm Vertical | 1 | 秋月電子 | CF25J27RB（114273） | エミッタ帰還（バイパスしない） |
| R7, R36 | 220 | R Axial DIN0207 L6.3mm D2.5mm P2.54mm Vertical | 2 | 秋月電子 | CF25J220RB（125221） | R36: 出力の直列抵抗（発振振幅・高調波を抑える） |
| R11, R15, R23, R59, R69, R74, R75 | 1.5k | R Axial DIN0207 L6.3mm D2.5mm P2.54mm Vertical | 7 | 秋月電子 | CF25J1K5B（125152） | R15: ダンピング（ζ 約 0.7）<br>R23: コレクタ負荷（水晶フィルタの入力側の終端。10M15A の規格に合わせて調整）<br>R59: TX ランプ電流<br>R69: 定電流源エミッタ抵抗<br>R74: 差動対の電流（約 (5 − 0.85 − 0.65) ÷ 1.5k ≒ 2.3mA）<br>R75: リセットパルス 約 50〜100ns |
| R12, R43-R45, R98 | 330 | R Axial DIN0207 L6.3mm D2.5mm P2.54mm Vertical | 5 | 秋月電子 | CF25J330RB（125331） | R43: 送信 BPF への直列抵抗。VCO の出力バッファ 3 回路を 330Ω ずつで合わせる（並列で約 110Ω）<br>R44: VCO の出力バッファ 2 個目の直列抵抗<br>R45: VCO の出力バッファ 3 個目の直列抵抗<br>R98: ×2 段 4 の遅延 17ns（14.65MHz の 1/4 周期） |
| R13 | 1.2k | R Axial DIN0207 L6.3mm D2.5mm P2.54mm Vertical | 1 | 秋月電子 | CF25J1K2B（125122） | 局発を約 106mVrms に減衰（NJM2594 のキャリア入力 1200Ω。データシートの規格 100mVrms・−7dBm、約 100mV 以上で出力一定） |
| R14, R18, R20, R27, R50, R73, R85, R87, R89, R99 | 1k | R Axial DIN0207 L6.3mm D2.5mm P2.54mm Vertical | 10 | 秋月電子 | CF25J1KB（125102） | R14: 負荷（NJM2594 の入力 600Ω と並列で約 375Ω、利得 約 4dB。感度が足りなければ外す）<br>R20: NJM2594 のエミッタフォロワの負荷（アイドル電流 約 3.3mA ＝（5V − 1.7V）÷ 1k）<br>R27: PTT 保護抵抗<br>R50: リレー駆動のベース電流 約 2.6mA（コイル約 42mA を確実に飽和させる）<br>R73: 負荷。RAMP < THRESH で約 2.3V、超えると 0V<br>R85: ゲートバイアス<br>R87: 同調 1（3.66MHz）の駆動。Q 約 5 を決める<br>R89: ゲートバイアス（入力トランスのセンタータップへ）<br>R99: 同調 2（7.33MHz）の駆動。Q 約 5 を決める |
| R16, R64, R68 | 100 | R Axial DIN0207 L6.3mm D2.5mm P2.54mm Vertical | 3 | 秋月電子 | CF25J100RB（125101） | R64: Si5351 CLK0（1.83125MHz）の直列抵抗 |
| R17, R49, R84, R95, R96 | 10 | R Axial DIN0207 L6.3mm D2.5mm P2.54mm Vertical | 5 | 秋月電子 | CF25J10RB（125100） | R17: 電源のデカップリング（データシートの応用回路）<br>R84: ゲートストッパー<br>R95: ゲートストッパー（B）<br>R96: ゲートストッパー（A） |
| R24 | 82 | R Axial DIN0207 L6.3mm D2.5mm P2.54mm Vertical | 1 | 秋月電子 | CF25J82RB（114276） | エミッタ帰還（バイパスしない。利得 ≒ 1.5k ÷ 91Ω） |
| R25 | 180 | R Axial DIN0207 L6.3mm D2.5mm P2.54mm Vertical | 1 | 秋月電子 | CF25J180RB（125181） |  |
| R26, R28, R29, R33, R35, R37-R40, R42, R47, R48, R52, R53, R57, R58, R60, R62, R70, R72, R101, R103 | 10k | R Axial DIN0207 L6.3mm D2.5mm P2.54mm Vertical | 22 | 秋月電子 | RD25S 10K（125103） | R35: PTT プルアップ<br>R37: ディエンファシス 470µs<br>R57: VREF = 2.5V |
| R30, R90, R91, R100 | 1M | R Axial DIN0207 L6.3mm D2.5mm P2.54mm Vertical | 4 | 秋月電子 | CF25J1MB（125105） | R30: 自己バイアス<br>R90, R91, R100: 自己バイアス（しきい値 = 入力の平均） |
| R31 | 20k | R Axial DIN0207 L6.3mm D2.5mm P2.54mm Vertical | 1 | 秋月電子 | CF25J20KB（103940） | ダンピング（データシートは 20k）。音が歪むときは 6.8k〜47k で調整 |
| R46 | 470k | R Axial DIN0207 L6.3mm D2.5mm P2.54mm Vertical | 1 | 秋月電子 | RD25S 470K（125474） | ノイズアンプ利得 47 |
| R51, R63, R71 | 100k | R Axial DIN0207 L6.3mm D2.5mm P2.54mm Vertical | 3 | 秋月電子 | CF25J100KB（125104） | R63: 利得 11 |
| R55, R88 | 470 | R Axial DIN0207 L6.3mm D2.5mm P2.54mm Vertical | 2 | 秋月電子 | CF25J470RB（125471） | R55: マイク電源デカップリング<br>R88: 同調 3（14.65MHz）の駆動。Q 約 5 を決める |
| R61 | 220k | R Axial DIN0207 L6.3mm D2.5mm P2.54mm Vertical | 1 | 秋月電子 | CF25J220KB（125224） | マイクアンプ利得 22 |
| R66, R67 | 15k | R Axial DIN0207 L6.3mm D2.5mm P2.54mm Vertical | 2 | 秋月電子 | MFS25F15KB（108552） | R66: 3kHz LPF（サレンキー） |
| R77 | 120 | R Axial DIN0207 L6.3mm D2.5mm P2.54mm Vertical | 1 | 秋月電子 | CF25J120RB（125121） |  |
| R78 | 1.8k | R Axial DIN0207 L6.3mm D2.5mm P2.54mm Vertical | 1 | 秋月電子 | MFS25F1K8B（108538） | ×2 段 1 の遅延 137ns（1.83MHz の 1/4 周期） |
| R79 | 510 | R Axial DIN0207 L6.3mm D2.5mm P2.54mm Vertical | 1 | 秋月電子 | CF25J510RB（125511） | ×2 段 3 の遅延 34ns（7.33MHz の 1/4 周期） |
| R80 | 560 | R Axial DIN0207 L6.3mm D2.5mm P2.54mm Vertical | 1 | 秋月電子 | CF25J560RB（125561） | ベースバイアス（分圧電流 約 12mA、hFE が低くても約 40mA を保つ） |
| R81 | 4.7 | R Axial DIN0207 L6.3mm D2.5mm P2.54mm Vertical | 1 | 秋月電子 | CF25J4R7B（125047） | 帰還（バイパスしない） |
| R82 | 18 | R Axial DIN0207 L6.3mm D2.5mm P2.54mm Vertical | 1 | 秋月電子 | CF25J18RB（114272） | エミッタ電流 約 33mA（2N2222A の損失を 0.25W 程度に） |
| R83 | 47 | R Axial DIN0207 L6.3mm D2.5mm P2.54mm Vertical | 1 | 秋月電子 | CF25J47RB（125470） | 入力スワンプ |
| R86, R92 | 3.3k | R Axial DIN0207 L6.3mm D2.5mm P2.54mm Vertical | 2 | 秋月電子 | CF25J3K3B（125332） |  |
| R93, R94 | 22 | R Axial DIN0414 L11.9mm D4.5mm P5.08mm Vertical | 2 | 秋月電子 | CFS50J22RB（107797） | R93: 入力スワンプ（B）<br>R94: 入力スワンプ（A） |
| R97 | 910 | R Axial DIN0207 L6.3mm D2.5mm P2.54mm Vertical | 1 | 秋月電子 | CF25J910RB（114277） | ×2 段 2 の遅延 68ns（3.66MHz の 1/4 周期） |
| R102 | 47k | R Axial DIN0207 L6.3mm D2.5mm P2.54mm Vertical | 1 | 秋月電子 | CF25J47KB（118208） |  |

**抵抗 R 合計: 103**

## 半固定抵抗 VR

| Reference | 値 / 型番 | フットプリント | 数量 | 購入先 | 購入先の型番（販売コード） | 備考 |
|---|---|---|---|---|---|---|
| VR1, VR3, VR4 | 10k | Potentiometer TOCOS GF063P Vertical | 3 | 秋月電子 | GF063P B103K（114905） | VR1: マイク利得<br>VR3: 周波数偏移（±5kHz に調整）<br>VR4: しきい値の中心（エッジがのこぎり波の中央に来るように） |
| VR2 | 1k | Potentiometer TOCOS GF063P Vertical | 1 | 秋月電子 | GF063P B102K（114901） | のこぎり波の傾き調整（約 260〜430µA） |
| VR5-VR7 | 5k | Potentiometer TOCOS GF063P Vertical | 3 | 秋月電子 | GF063P B502K（114904） | VR5: パルス幅（デューティ 50%）調整<br>VR6: ドライバ IRF510 のアイドル電流（約 150mA。ゲート約 3.5〜4V）<br>VR7: ファイナル IRF510 × 2 のアイドル電流（合計 約 100mA） |

**半固定抵抗 VR 合計: 7**

## コンデンサ C

| Reference | 値 / 型番 | フットプリント | 数量 | 購入先 | 購入先の型番（販売コード） | 備考 |
|---|---|---|---|---|---|---|
| C1, C3, C6, C10, C16-C19, C24, C34, C37-C42, C45, C46, C49, C50, C56, C61, C63, C65, C81, C85, C86, C97, C99, C101, C106, C107, C109, C113, C124 | 0.1u | C Disc D5.0mm W2.5mm P2.50mm | 35 | 秋月電子 | RDER71H104K0P1H03B（113582） | C40: 出力の平滑（出力抵抗 12.5kΩ と約 1.3ms）<br>C42: 差動入力の中点（6 番）の AC 接地<br>C49, C50: データシートどおり VCC へ<br>C106: バイアス点を交流で GND に |
| C2 | 470u | CP Radial D8.0mm P3.50mm | 1 | 秋月電子 | 25PX470MEFC8X11.5（117883） | 25V 以上 |
| C4, C11, C84, C87, C89 | 22p | C Disc D3.0mm W1.6mm P2.50mm | 5 | 秋月電子 | RD15N220J1HL2L（104060） | C4, C11, C87, C89: NP0<br>C84: リセットパルスの時定数（NP0） |
| C5 | 0.33u | C Disc D5.0mm W2.5mm P2.50mm | 1 | 秋月電子 | RD15W334K1HL2L-10（115937） |  |
| C7, C12, C15, C21, C28, C35, C58, C66, C74, C82 | 10u | CP Radial D5.0mm P2.00mm | 10 | 秋月電子 | 50PX10MEFC5X11（117897） | C12: 25V 以上 |
| C8, C20, C22, C25-C27, C29-C33, C43, C47, C53, C54, C62, C90, C93-C96, C98, C100, C108, C110, C123 | 0.01u | C Disc D5.0mm W2.5mm P2.50mm | 26 | 秋月電子 | C8, C22, C26, C27, C29-C33, C43, C47, C53, C54, C62, C90, C93-C96, C98, C100, C108, C110, C123: RD15W103K1HL2L-10（104063）<br>C20, C25: RDE5C1H103J1K1H03B（108043） | C20: フィルム（または C0G）<br>C25: フィルム（または C0G）。積分<br>C27: 負入力を交流で GND へ<br>C30: オフセット補償ループの時定数（データシートの応用回路）<br>C54: DC カット（受信中に入力を GND に落としても出力から電流が流れない） |
| C9 | 2p | C Disc D3.0mm W1.6mm P2.50mm | 1 | 秋月電子 | RDE5C1H2R0C0K1H03B（108044） | NP0、段間結合 |
| C13, C14, C52, C75 | 220p | C Disc D3.0mm W1.6mm P2.50mm | 4 | 秋月電子 | RDE5C1H221J0K1H03B（108106） | C13, C14: PFD のパルスをならす<br>C52: NP0（データシートどおり VCC へ）<br>C75: 高域カット |
| C23, C44, C112 | 47p | C Disc D3.0mm W1.6mm P2.50mm | 3 | 秋月電子 | RDE5C1H470J0K1H03B（108045） | C23: NP0。コレクタ同調<br>C44: NP0。可変容量の結合（範囲 約 0.8MHz）<br>C112: NP0 |
| C36 | 470p | C Disc D3.0mm W1.6mm P2.50mm | 1 | 秋月電子 | RDE5C1H471J0K1H03B（108110） | 339kHz の極（PFD の残りを落とす） |
| C48 | 27p | C Disc D3.0mm W1.6mm P2.50mm | 1 | 秋月電子 | RDE5C1H270J0K1H03B（108095） | NP0 |
| C51, C79 | 68p | C Disc D3.0mm W1.6mm P2.50mm | 2 | 秋月電子 | RDE5C1H680J0P1H03B（114323） | C51: NP0<br>C79: C0G（NP0）必須。のこぎり波の直線性に直結。山 約 1.5〜1.7V |
| C55 | 56p | C Disc D3.0mm W1.6mm P2.50mm | 1 | 秋月電子 | RDE5C1H560J0K1H03B（108099） | NP0 |
| C57, C77 | 2.2n | C Disc D5.0mm W2.5mm P2.50mm | 2 | 秋月電子 | RDER71H222K0P1H03B（112060） | C57: ノイズ HPF（約 7kHz 以上） |
| C59, C67 | 0.047u | C Disc D5.0mm W2.5mm P2.50mm | 2 | 秋月電子 | RDER71H473K0P1H03B（112059） |  |
| C60, C71, C76, C80 | 1u | C Disc D5.0mm W2.5mm P2.50mm | 4 | 秋月電子 | RD15W105K1HL2L-503（115940） |  |
| C64 | 100u | CP Radial D6.3mm P2.50mm | 1 | 秋月電子 | 25PX100MEFC5X11（117877） |  |
| C68 | 0.47u | C Disc D5.0mm W2.5mm P2.50mm | 1 | 秋月電子 | RD15W474K1HL2L-10（115938） |  |
| C69 | 220u | CP Radial D6.3mm P2.50mm | 1 | 秋月電子 | 25PX220MEFC6.3X11（117879） | 16V 以上 |
| C70, C72, C73 | 47u | CP Radial D5.0mm P2.00mm | 3 | 秋月電子 | 35PX47MEFC5X11（117887） |  |
| C78 | 4.7n | C Disc D5.0mm W2.5mm P2.50mm | 1 | 秋月電子 | 50F2D472J（110336） |  |
| C83, C91, C111, C117, C122 | 100p | C Disc D3.0mm W1.6mm P2.50mm | 5 | 秋月電子 | C83, C122: RD15N101J1HL2L-10（104061）<br>C91, C111, C117: RDE5C1H101J0K1H03B（108063） | C83: ワンショット時定数<br>C91, C111: NP0<br>C117: NP0。同調 2（7.33MHz、配線と 74HCU04 の入力を含めて） |
| C88 | 1p | C Disc D3.0mm W1.6mm P2.50mm | 1 | 秋月電子 | RDE5C1H1R0C0K1H03B（108082） | NP0、段間結合（2p では過結合で ±1.8MHz が落ちない。1p で 29.0〜29.7MHz の偏差 0.6dB 以内） |
| C92 | 82p | C Disc D3.0mm W1.6mm P2.50mm | 1 | 秋月電子 | RDE5C1H820J0K1H03B（108101） | NP0 |
| C102 | 180p | C Disc D3.0mm W1.6mm P2.50mm | 1 | 秋月電子 | RDE5C1H181J0K1H03B（108105） | NP0。同調 1（3.66MHz、配線と 74HCU04 の入力を含めて） |
| C103 | 120p | C Disc D3.0mm W1.6mm P2.50mm | 1 | 秋月電子 | RDE5C1H121J0K1H03B（108103） | NP0。同調 3（14.65MHz、配線と 74HCU04 の入力を含めて） |
| C104, C105, C119 | 1000p | C Disc D3.0mm W1.6mm P2.50mm | 3 | 秋月電子 | RDE5C1H102J0K1H03B（108114） |  |
| C114 | 220u | CP Radial D8.0mm P3.50mm | 1 | 秋月電子 | 25PX220MEFC6.3X11（117879） | 25V 以上 |
| C115, C120 | 120p | C Disc D5.0mm W2.5mm P5.00mm | 2 | DigiKey／Mouser（要確認） | C0G 500V〜1kV ディスク 120pF | NP0 500V |
| C116, C118 | 220p | C Disc D5.0mm W2.5mm P5.00mm | 2 | DigiKey／Mouser（要確認） | C0G 500V〜1kV ディスク 220pF | NP0 500V |
| C121 | 4.7p | C Disc D3.0mm W1.6mm P2.50mm | 1 | DigiKey／Mouser（要確認） | C0G 500V〜1kV ディスク 4.7pF | NP0 500V。容量分割 |

**コンデンサ C 合計: 124**

## トリマコンデンサ TC

| Reference | 値 / 型番 | フットプリント | 数量 | 購入先 | 購入先の型番（販売コード） | 備考 |
|---|---|---|---|---|---|---|
| TC1-TC5 | 30p | C Trimmer TMCV01 | 5 | 秋月電子 | TMCV01-30P100VBG（115472） | TC1, TC2, TC4, TC5: 29.3MHz に同調<br>TC3: VCO の中心。VT が約 2.5V で 29.3MHz に |

**トリマコンデンサ TC 合計: 5**

## コイル L

| Reference | 値 / 型番 | フットプリント | 数量 | 購入先 | 購入先の型番（販売コード） | 備考 |
|---|---|---|---|---|---|---|
| L1, L4, L7, L8 | T30-6 17T/2T | L T30 3pin Vertical | 4 | 秋月電子 | T-30-6（116458） | L1: 受信 BPF 1 段目<br>L4: 受信 BPF 2 段目（タップは使わない）<br>L7: 送信 BPF 1 段目。T-30-6 に 0.4mm 線 17 回、コールド側から 2 回目でタップ<br>L8: 送信 BPF 2 段目 |
| L2, L5, L9, L11 | 10uH | L Axial L9.5mm D4.0mm P2.54mm Vertical Fastron SMCC | 4 | 秋月電子 | AL0510-100K（104922） | L2: DC-DC 入力フィルタ<br>L5: ドレインチョーク（2N3819 の Idss のばらつきでドレイン電圧が下がらないように）<br>L9: コレクタチョーク<br>L11: 同調 1（3.66MHz）。マイクロインダクタ（Q 40 程度）、±10% 品で可 |
| L3, L14 | 4.7uH | L Axial L9.5mm D4.0mm P2.54mm Vertical Fastron SMCC | 2 | 秋月電子 | AL0410-4R7K（104931） | L3: コレクタ同調（4.7µH ＋ 47p で約 10.7MHz、AD8307 の入力 1.1kΩ で Q 約 2。AD8307 に広帯域の雑音を入れない）<br>L14: 同調 2（7.33MHz）。マイクロインダクタ（Q 40 程度）、±10% 品で可 |
| L6 | T50-6 15T | L T50 2pin Vertical | 1 | 秋月電子 | T-50-6（111947） | 約 0.9µH（0.5mm 線） |
| L10 | FT37-43 10T | L T50 2pin Vertical | 1 | 秋月電子 | FT-37-43（131660） | ドレインチョーク（約 35µH） |
| L12 | 1uH | L Axial L9.5mm D4.0mm P2.54mm Vertical Fastron SMCC | 1 | 秋月電子 | AL0410-1R0K（104930） | 同調 3（14.65MHz）。マイクロインダクタ（Q 40 程度）、±10% 品で可 |
| L13, L16 | T50-6 9T | L T50 2pin Vertical | 2 | 秋月電子 | T-50-6（111947） | 約 0.35µH |
| L15 | T50-6 10T | L T50 2pin Vertical | 1 | 秋月電子 | T-50-6（111947） | 約 0.39µH |

**コイル L 合計: 16**

## トランス T

| Reference | 値 / 型番 | フットプリント | 数量 | 購入先 | 購入先の型番（販売コード） | 備考 |
|---|---|---|---|---|---|---|
| T1 | BN43-202 2T:2T(CT) | Transformer BN43-202 SS | 1 | DigiKey | Fair-Rite 2843002402（BN-43-202） | 入力トランス 1:1。1 次 2 回（ドライバから）・2 次 2 回（センタータップにバイアス）。0.4mm 線 |
| T2 | BN43-202 2T(CT):3T | Transformer BN43-202 SP | 1 | DigiKey | Fair-Rite 2843002402（BN-43-202） | 出力トランス。1 次 2 回（センタータップから 13.8V）・2 次 3 回（1:2.25、ドレイン間 約 22Ω → 50Ω）。1 次は 0.8mm 線（約 0.7A ずつ） |

**トランス T 合計: 2**

## ダイオード D

| Reference | 値 / 型番 | フットプリント | 数量 | 購入先 | 購入先の型番（販売コード） | 備考 |
|---|---|---|---|---|---|---|
| D1 | 1N5408 | D DO-201AD P5.08mm Vertical AnodeUp | 1 | 秋月電子 | 1N5822（102229） | 逆接続保護（逆接続でヒューズを切る） |
| D2, D3, D9-D12 | 1N4148 | D DO-35 SOD27 P2.54mm Vertical AnodeUp | 6 | 秋月電子 | 1N4148（100941） | D2, D3: 入力保護<br>D9: クリップ ±0.6V<br>D11: 基準電圧（ダイオード 2 本） |
| D4 | 1N4007 | D DO-41 SOD81 P5.08mm Vertical AnodeUp | 1 | 秋月電子 | 1N4007-3485（100934） | 可変容量として使う（逆バイアス 0.5〜4.5V で約 20〜9pF）。可変容量ダイオード（1SV101 など）でも可 |
| D5 | 1N5819 | D DO-41 SOD81 P5.08mm Vertical AnodeUp | 1 | 秋月電子 | 1N5819（117244） | USB 接続時の逆流防止 |
| D6, D7, D13 | 1N60 | D DO-35 SOD27 P2.54mm Vertical AnodeUp | 3 | サトー電気 など（要確認） | 1N60 | D6: 倍電圧検波<br>D13: 出力検波（ゲルマニウム） |
| D8 | 1N4001 | D DO-41 SOD81 P5.08mm Vertical AnodeUp | 1 | 秋月電子 | 1N4007-3485（100934） | リレーコイルの逆起電力吸収 |

**ダイオード D 合計: 13**

## トランジスタ・FET Q

| Reference | 値 / 型番 | フットプリント | 数量 | 購入先 | 購入先の型番（販売コード） | 備考 |
|---|---|---|---|---|---|---|
| Q1, Q3-Q6 | 2SC1815 | TO-92 Inline | 5 | 秋月電子 | 2SC1815L-GR-T92（106477） | Q1: S メーター用 10.7MHz 増幅（Ic 約 3mA、約 26dB）<br>Q3: 10.7MHz 増幅（エミッタ接地、約 18dB。Ic 約 2.9mA）<br>Q4: 受信中（RX8V）に VCO の入力を GND に落として発振を止める<br>Q5: スケルチのミュート（MUTE = High で消音）<br>Q6: リレー駆動 |
| Q2 | 2N3819 | TO-92 Inline | 1 | DigiKey（取り寄せ） | 2N3819 APM PBFREE（Central） | RF アンプ（ソース接地） |
| Q7 | 2N7000 | TO-92 Inline | 1 | 秋月電子 | 2N7000（109723） | 放電スイッチ |
| Q8-Q10 | 2SA1015 | TO-92 Inline | 3 | 秋月電子 | 2SA1015L-GR-T92（106734） | Q8: 定電流源<br>Q9: 比較（ベース = のこぎり波）。GR ランクの 2 個をそろえる<br>Q10: 比較（ベース = しきい値） |
| Q11 | 2N2222A | TO-92 Inline | 1 | DigiKey など | 2N2222A（TO-92、E-B-C の並び） | バッファ（TO-92、E-B-C の並び。fT 250MHz 以上、コレクタ損失 約 0.3W） |
| Q12-Q14 | IRF510 | TO-220-3 Vertical | 3 | DigiKey | IRF510PBF（Vishay、IRF510PBF-ND） | Q12: ドライバ（約 0.5W）。放熱器 HS1 に固定。タブ = ドレイン（+13.8V）なので絶縁シートと絶縁ブッシングで絶縁する<br>Q13: ファイナル B。A と並べてケースの放熱器にねじ止め（絶縁シートと絶縁ブッシング）<br>Q14: ファイナル A。基板の後ろの端に立て、ケースの放熱器にねじ止め。タブ = ドレインなので絶縁シートと絶縁ブッシングで絶縁する |

**トランジスタ・FET Q 合計: 14**

## IC・モジュール U

| Reference | 値 / 型番 | フットプリント | 数量 | 購入先 | 購入先の型番（販売コード） | 備考 |
|---|---|---|---|---|---|---|
| U1 | 74AC74 | DIP-14 W7.62mm Socket | 1 | DigiKey | SN74AC74N（296-4342-5-ND） | 位相周波数比較。1 個目のクロック = ×16（基準）、2 個目 = VCO。必ず AC 品（29.3MHz） |
| U2 | 78L05 | TO-92 Inline | 1 | 秋月電子 | L78L05ACZ（101250） | 受信用 5V（NJM2594・MC3361・スケルチ） |
| U3 | 74AC00 | DIP-14 W7.62mm Socket | 1 | DigiKey | SN74AC00N（296-4287-5-ND） | 位相比較のリセット（UP・DN が両方 High で両方の D-FF をクリア）。2〜4 回路目は未使用 |
| U4 | L7808 | TO-220-3 Vertical | 1 | DigiKey | L7808CV（4491-L7808CV-ND、Lumimax） | 受信・送信バイアス・アナログ系。小型放熱器を付ける |
| U5 | R-78E5.0-1.0 | Converter DCDC RECOM R-78E-0.5 THT | 1 | DigiKey／Mouser | R-78E5.0-1.0 | デジタル系 5V（XIAO・表示） |
| U6 | L7805 | TO-220-3 Vertical | 1 | 秋月電子 | L7805CV-DG（107903） | 変調部専用 5V（リニア。DC-DC のリプルを変調に入れないため） |
| U7, U16 | MCP6002 | DIP-8 W7.62mm Socket | 2 | 秋月電子 | MCP6002-E/P（130011） | U7: A: ループフィルタ（レール・ツー・レール出力 0〜5V）、B: 未使用（ボルテージフォロワで固定）<br>U16: A: スケルチ用ノイズアンプ、B: 未使用（ボルテージフォロワで固定） |
| U8 | LP2950-3.3 | TO-92 Inline | 1 | 秋月電子 | LP2950L-33-T92（108749） | Si5351 モジュール用 3.3V |
| U9 | AD8307ANZ | DIP-8 W7.62mm Socket | 1 | DigiKey／Mouser（要確認） | AD8307ANZ | 対数増幅（25mV/dB、−75〜＋17dBm）。DIP-8。+5VA（受信中だけ）。INT（5 番）は開放、ENB は VPS へ |
| U10 | NJM2594V | TSSOP-8 4.4x3mm P0.65mm | 1 | 秋月電子 | NJM2594V（111195） | 第 1 混合（DBM、変換利得 0dB）。表面実装 SSOP8（0.65mm ピッチ）、部品面に手はんだ（この部品だけ表面実装）。3 番エミッタフォロワ出力、2 番は開放、8 番（内部で未接続）は開放（基板で両側を信号線に挟まれ GND に落とせないため） |
| U11 | AE-Si5351A | DIP-8 W7.62mm | 1 | 秋月電子 | AE-Si5351A-B（110679） | 秋月 AE-Si5351A。CLK0 = 変調基準 1.83125MHz（送信時のみ。29.3MHz ÷ 16）、CLK1 = 受信局発 18.6MHz（受信時のみ） |
| U12, U22 | 74HCU04 | DIP-14 W7.62mm Socket | 2 | DigiKey | SN74HCU04N（296-9820-5-ND） | U12: VCO 専用（必ず U 付き）。1: 発振、2: 位相比較行きのバッファ、3〜5: 送信 RF 行きのバッファ（出力を 330Ω ずつで合わせ、駆動を強くする）、6: 未使用。受信中は 1 の入力が GND に落ち、バッファの出力は Low のまま止まる<br>U22: アンバッファ品（必ず U 付き）。1〜3: 同調 1〜3 の後の自己バイアス増幅。4〜6 回路目は未使用 |
| U13 | ADS1115 module | ADS1115 Module Socket | 1 | DigiKey（Adafruit 1085）／Amazon など（要確認） | Adafruit 1085 または同じピン並び（VDD GND SCL SDA ADDR ALRT A0〜A3）のモジュール | I2C 16 ビット ADC（ADS1115 モジュール、Adafruit 1085 と同じピン並び）。アドレス 0x48（ADDR = GND）。A0 = S メーター。ピンソケットに差す（XIAO のピンが足りないので I2C で読む） |
| U14 | MC3361 | DIP-16 W7.62mm Socket | 1 | LCSC／海外通販（要注意） | MC3361BPL-D16-T（UTC、DIP-16）または MC3361BP | 第 2 混合（455kHz）・リミッタ・検波。スケルチは XIAO 側で行うので 10〜14 番は未使用 |
| U15 | XIAO ESP32C3 | Seeeduino XIAO Socket | 1 | 秋月電子 | 113991054（117454） | ソケット実装。起動設定ピン D0（GPIO2）・D9（GPIO9）は起動時に High が必要なので、ふだん開放の PTT とエンコーダ SW をつなぐ（PTT・つまみを押したまま電源を入れない）。D8（GPIO8）はフラッシュ起動に関係しないのでエンコーダ B 相 |
| U17 | LM386N-1 | DIP-8 W7.62mm Socket | 1 | 秋月電子 | LM386G-D08（114548） | 低周波増幅（利得 20） |
| U18 | MCP6004 | DIP-14 W7.62mm Socket | 1 | DigiKey | MCP6004-I/P（MCP6004-I/P-ND） | A: マイクアンプ、B: 利得段、C: 3kHz LPF、D: しきい値バッファ |
| U19 | 74HCT123 | DIP-16 W7.62mm Socket | 1 | DigiKey | CD74HCT123E | 1 回路目: コンパレータの出力の立ち下がり（1A）で約 273ns（デューティ 50%）の PM_OUT。2 回路目: CLK0 の立ち上がり（2B）で約 50〜100ns のリセットパルス（2N7000 で放電）。HCT 品（Si5351 の 3.3V 出力を受けるため） |
| U20, U23 | 74AC14 | DIP-14 W7.62mm Socket | 2 | DigiKey | SN74AC14N（296-4301-5-ND） | U20: RC 遅延の後の波形整形（シュミット）と、段 1・2 の同調の後の整形。74AC86 に遅い波形を入れないため。必ず AC 品<br>U23: 同調 3 の後の整形（シュミット）。2〜6 回路目は未使用。必ず AC 品 |
| U21 | 74AC86 | DIP-14 W7.62mm Socket | 1 | DigiKey | SN74AC86N（296-4345-5-ND） | ×2 段 1〜4（1.83 → 3.66 → 7.33 → 14.65 → 29.3MHz）。必ず AC 品 |

**IC・モジュール U 合計: 23**

## 水晶・ディスクリミネータ X

| Reference | 値 / 型番 | フットプリント | 数量 | 購入先 | 購入先の型番（販売コード） | 備考 |
|---|---|---|---|---|---|---|
| X1 | 10.245MHz | Crystal HC49-U Vertical | 1 | Tayda／LCSC | 10.245MHz HC-49/S（例: YXC X49SD10245MSD2SC） | 第 2 局発。データシートの試験回路どおり 1 番と VCC の間 |
| X2 | CDBM455C24 | C Disc D5.0mm W2.5mm P5.00mm | 1 | 要確認（製造中止の恐れ） | CDBM455C24（村田） | 455kHz セラミックディスクリミネータ（2 端子、5mm ピッチ） |

**水晶・ディスクリミネータ X 合計: 2**

## フィルタ FL

| Reference | 値 / 型番 | フットプリント | 数量 | 購入先 | 購入先の型番（販売コード） | 備考 |
|---|---|---|---|---|---|---|
| FL1 | 10M15A | Crystal HC49-U-3Pin Vertical | 1 | DigiKey | ECS-10.7-15A（X703-ND） | 10.7MHz 水晶フィルタ（帯域 ±7.5kHz）。ピン配置は実物で確認 |
| FL2 | CFWLA455KFFA | Filter Ceramic 3pin P2.54mm | 1 | 秋月電子 | LT455EU（116046） | 455kHz セラミックフィルタ（±7.5kHz 程度）。ピン配置は実物で確認 |

**フィルタ FL 合計: 2**

## リレー K

| Reference | 値 / 型番 | フットプリント | 数量 | 購入先 | 購入先の型番（販売コード） | 備考 |
|---|---|---|---|---|---|---|
| K1 | G5V-2 DC12 | Relay DPDT Omron G5V-2 | 1 | LCSC／DigiKey（要確認） | G5V-2-DC12 | 送受切替。1 極目: アンテナ（NC=受信、NO=送信）、2 極目: 8V を RX8V / TX8V へ |

**リレー K 合計: 1**

## コネクタ J

| Reference | 値 / 型番 | フットプリント | 数量 | 購入先 | 購入先の型番（販売コード） | 備考 |
|---|---|---|---|---|---|---|
| J1 | DC 13.8V | SolderWire-1sqmm 1x02 P5.4mm D1.4mm OD2.7mm | 1 | 手持ち／ホームセンター |  | 後面の DC ジャックから（ヒューズ 5A は後面パネル側） |
| J2 | I2C | PinHeader 1x04 P2.54mm Vertical | 1 | 秋月電子 | PH-1x40SG（100167） | OLED 表示を使う場合の予備 |
| J3 | LCD | PinHeader 1x04 P2.54mm Vertical | 1 | 秋月電子 | PH-1x40SG（100167） | Nextion NX4832T035（または TJC4832T135）表示器。2 番（XIAO の TX）→ 表示器の RX（黄）。表示器の TX（青）はつながない（表示器からの受信は使わない） |
| J4 | VOL | PinHeader 1x03 P2.54mm Vertical | 1 | 秋月電子 | PH-1x40SG（100167） | 上面 VOL（10kΩ A カーブ） |
| J5 | ENC | PinHeader 1x05 P2.54mm Vertical | 1 | 秋月電子 | PH-1x40SG（100167） | ロータリーエンコーダ（上面 TUNE） |
| J6 | SP | PinHeader 1x02 P2.54mm Vertical | 1 | 秋月電子 | PH-1x40SG（100167） | スピーカー 8Ω |
| J7 | MIC | PinHeader 1x03 P2.54mm Vertical | 1 | 秋月電子 | PH-1x40SG（100167） | エレクトレットマイク・PTT（上面 MIC） |
| J8 | ANT | SolderWire-1sqmm 1x02 P5.4mm D1.4mm OD2.7mm | 1 | 手持ち／ホームセンター |  | 後面 BNC へ（RG-174 で配線） |
| J9 | TX LED | PinHeader 1x02 P2.54mm Vertical | 1 | 秋月電子 | PH-1x40SG（100167） | 上面の TX ランプ |

**コネクタ J 合計: 9**

## テストポイント TP

| Reference | 値 / 型番 | フットプリント | 数量 | 購入先 | 購入先の型番（販売コード） | 備考 |
|---|---|---|---|---|---|---|
| TP1 | VT | TestPoint THTPad D1.5mm Drill0.7mm | 1 | 手持ち |  | VCO 制御電圧。29.3MHz 送信で約 2.5V になるよう TC（VCO）を調整 |
| TP2 | TXOSC | TestPoint THTPad D1.5mm Drill0.7mm | 1 | 手持ち |  | 29.3MHz（PLL の VCO）の観測点 |
| TP3 | RAMP | TestPoint THTPad D1.5mm Drill0.7mm | 1 | 手持ち |  | のこぎり波の観測点 |
| TP4 | THRESH | TestPoint THTPad D1.5mm Drill0.7mm | 1 | 手持ち |  | しきい値（約 0.85V ± 音声）の観測点 |
| TP5 | COMP | TestPoint THTPad D1.5mm Drill0.7mm | 1 | 手持ち |  | コンパレータの出力の観測点（交点で立ち下がる） |
| TP6 | PM | TestPoint THTPad D1.5mm Drill0.7mm | 1 | 手持ち |  | 位相変調された 1.83125MHz の観測点（立ち上がりが音声で揺れる） |
| TP7 | X16 | TestPoint THTPad D1.5mm Drill0.7mm | 1 | 手持ち |  | ×16 の出力（29.3MHz、PLL の基準）の観測点 |

**テストポイント TP 合計: 7**

## 回路図に載っていない部品

| 品名 | 数量 | 購入先 | 購入先の型番（販売コード） | 備考 |
|---|---|---|---|---|
| IC ソケット 8P | 4 | 秋月電子 | 2227-08-03（100017） | U7・U9・U16・U17 |
| IC ソケット 14P | 8 | 秋月電子 | 2227-14-03（100006） | U1・U3・U12・U18・U20・U21・U22・U23 |
| IC ソケット 16P | 2 | 秋月電子 | 2227-16-03（100007） | U14・U19 |
| ピンソケット 1×7（XIAO 用） | 2 | 秋月電子 | FH-1x7SG/RH（104285） | U15 |
| ピンソケット 1×10（ADS1115 モジュール用） | 1 | 秋月／千石 など（要確認） | ピンソケット 1×10 2.54mm（40P を切ってもよい） | U13 |
| TO-220 用 絶縁シート＋絶縁ブッシング | 3 | 秋月／マルツ など（要確認） | TO-220 用 シリコン（またはマイカ）絶縁シートと絶縁ブッシング | IRF510 × 3（タブ = ドレインなので放熱器から絶縁する） |
| 放熱器 20PB020（ドライバ IRF510 用） | 1 | 秋月電子 | 20PB020-01025（105054） | HS1（基板に付ける） |
| 放熱器 16PB017（L7808 用） | 1 | 秋月電子 | 16PB017-01025（105053） | U4。取り付けられる向き・隙間を要確認 |
| 放熱器（ファイナル IRF510 × 2 用、ケース内に立てる） | 1 | 秋月／マルツ など（要確認） | 熱抵抗 5〜8℃/W、幅 50 × 高さ 30 mm 程度 | ケースの後面の窓からフィンを出す（enclosure/README.md） |
| ロータリーエンコーダ | 1 | 秋月電子 | EC12E2420801（106357） | TUNE（J5） |
| AF ボリューム 10kΩA | 1 | 秋月電子 | SH16K4A103L20KCCI（129553） | VOL（J4） |
| 電源スイッチ | 1 | 要確認 | φ13 穴に合う 2A 以上のもの | POWER |
| 電源 LED（3mm 緑） | 1 | 秋月電子 | OSG5TA3Z74A（111635） | ON |
| TX ランプ（3mm 赤） | 1 | 秋月電子 | OSR5JA3Z74A（111577） | TX（J9） |
| マイクコネクタ 4P 丸型（パネル取付 φ16） | 1 | 千石電商／マルツ など（要確認） | 4P 丸型マイクコネクタ（メス） | MIC（J7） |
| 外部スピーカージャック（スイッチ付き） | 1 | 秋月電子 | MJ-352W-C（117359） | EXT SP（J6） |
| スピーカー 5cm 8Ω 0.5W | 1 | 秋月電子 | DXYD50N-22Z-8A-F（116024） | ふた裏に M3 皿ねじ＋ナット 4 本 |
| LCD Nextion NX4832T035（3.5 インチ 480×320） | 1 | Nextion 公式ストア／Amazon など（要確認） | NX4832T035 | J3 |
| DC ジャック 2.1mm（パネル取付） | 1 | 秋月電子 | MJ-14（106342） | 後面 |
| ヒューズホルダ（パネル取付） | 1 | 秋月電子 | MF-524M（107079） | 後面 |
| ヒューズ 5A（5×20mm） | 1 | 秋月電子 | MF51NR 250V 5（107131） |  |
| BNC コネクタ（パネル取付） | 1 | 秋月電子 | B-014IF（100093） | 後面、J8 へ RG-174 |
| M3 インサートナット | 24 | Amazon／モノタロウ |  | ケース（enclosure/README.md） |
| M3 ねじ・皿ねじ・ナット | 1 | ホームセンター／モノタロウ |  | 本数は enclosure/README.md |

購入先・販売コード・価格は `kicad/bom_purchase.csv`（`tools/make_bom_purchase.py`、秋月電子の通販サイトで 2026-10-16 に確認）。「要確認」は秋月で扱いがなく、型番・在庫を確かめていない部品。

---

**部品総数: 328**
