kazushinjo/Serrasoid_TRX_29M/kicad/bom_summary.csv

区分 | 品名 | 値/型番 | 合計個数 | Reference | 購入先 | 購入先の型番 | 販売コード | 入数 | 買う数 | 単価（税込、2026-10-16） | 金額 | 購入メモ
抵抗 | カーボン抵抗 1/4W | 2.2k | 4 | R1, R56, R65, R76 | 秋月電子 | CF25J2K2B | 125222 | 100本 | 1 | 220 | 220 | 電源 LED の抵抗にも使う
抵抗 | カーボン抵抗 1/4W | 5.6k | 4 | R2, R3, R8, R9 | 秋月電子 | RD25S 5K6 | 125562 | 100本 | 1 | 100 | 100 | 2026-10-29 確認
抵抗 | カーボン抵抗 1/4W | 22k | 4 | R4, R19, R21, R54 | 秋月電子 | CF25J22KB | 125223 | 100本 | 1 | 180 | 180
抵抗 | カーボン抵抗 1/4W | 4.7k | 6 | R5, R10, R22, R32, R34, R41 | 秋月電子 | CF25J4K7B | 125472 | 100本 | 1 | 170 | 170
抵抗 | カーボン抵抗 1/4W | 27 | 1 | R6 | 秋月電子 | CF25J27RB | 114273 | 100本 | 1 | 100 | 100 | 2026-10-29 確認
抵抗 | カーボン抵抗 1/4W | 220 | 2 | R7, R36 | 秋月電子 | CF25J220RB | 125221 | 100本 | 1 | 200 | 200 | 2026-10-29 確認
抵抗 | カーボン抵抗 1/4W | 1.5k | 7 | R11, R15, R23, R59, R69, R74, R75 | 秋月電子 | CF25J1K5B | 125152 | 100本 | 1 | 170 | 170
抵抗 | カーボン抵抗 1/4W | 330 | 5 | R12, R43, R44, R45, R98 | 秋月電子 | CF25J330RB | 125331 | 100本 | 1 | 200 | 200
抵抗 | カーボン抵抗 1/4W | 1.2k | 1 | R13 | 秋月電子 | CF25J1K2B | 125122 | 100本 | 1 | 170 | 170
抵抗 | カーボン抵抗 1/4W | 1k | 10 | R14, R18, R20, R27, R50, R73, R85, R87, R89, R99 | 秋月電子 | CF25J1KB | 125102 | 100本 | 1 | 100 | 100
抵抗 | カーボン抵抗 1/4W | 100 | 3 | R16, R64, R68 | 秋月電子 | CF25J100RB | 125101 | 100本 | 1 | 200 | 200
抵抗 | カーボン抵抗 1/4W | 10 | 5 | R17, R49, R84, R95, R96 | 秋月電子 | CF25J10RB | 125100 | 100本 | 1 | 220 | 220
抵抗 | カーボン抵抗 1/4W | 82 | 1 | R24 | 秋月電子 | CF25J82RB | 114276 | 100本 | 1 | 100 | 100
抵抗 | カーボン抵抗 1/4W | 180 | 1 | R25 | 秋月電子 | CF25J180RB | 125181 | 100本 | 1 | 100 | 100
抵抗 | カーボン抵抗 1/4W | 10k | 22 | R26, R28, R29, R33, R35, R37, R38, R39, R40, R42, R47, R48, R52, R53, R57, R58, R60, R62, R70, R72, R101, R103 | 秋月電子 | RD25S 10K | 125103 | 100本 | 1 | 100 | 100
抵抗 | カーボン抵抗 1/4W | 1M | 4 | R30, R90, R91, R100 | 秋月電子 | CF25J1MB | 125105 | 100本 | 1 | 200 | 200 | 2026-10-29 確認
抵抗 | カーボン抵抗 1/4W | 20k | 1 | R31 | 秋月電子 | CF25J20KB | 103940 | 100本 | 1 | 180 | 180
抵抗 | カーボン抵抗 1/4W | 470k | 1 | R46 | 秋月電子 | RD25S 470K | 125474 | 100本 | 1 | 100 | 100
抵抗 | カーボン抵抗 1/4W | 100k | 3 | R51, R63, R71 | 秋月電子 | CF25J100KB | 125104 | 100本 | 1 | 200 | 200
抵抗 | カーボン抵抗 1/4W | 470 | 2 | R55, R88 | 秋月電子 | CF25J470RB | 125471 | 100本 | 1 | 200 | 200
抵抗 | カーボン抵抗 1/4W | 220k | 1 | R61 | 秋月電子 | CF25J220KB | 125224 | 100本 | 1 | 180 | 180
抵抗 | 金属皮膜抵抗 1/4W | 15k | 2 | R66, R67 | 秋月電子 | MFS25F15KB | 108552 | 100本 | 1 | 300 | 300 | 秋月にカーボンの 15kΩ はない
抵抗 | カーボン抵抗 1/4W | 120 | 1 | R77 | 秋月電子 | CF25J120RB | 125121 | 100本 | 1 | 220 | 220
抵抗 | 金属皮膜抵抗 1/4W | 1.8k | 1 | R78 | 秋月電子 | MFS25F1K8B | 108538 | 100本 | 1 | 200 | 200 | 秋月にカーボンの 1.8kΩ はない
抵抗 | カーボン抵抗 1/4W | 510 | 1 | R79 | 秋月電子 | CF25J510RB | 125511 | 100本 | 1 | 200 | 200
抵抗 | カーボン抵抗 1/4W | 560 | 1 | R80 | 秋月電子 | CF25J560RB | 125561 | 100本 | 1 | 200 | 200
抵抗 | カーボン抵抗 1/4W | 4.7 | 1 | R81 | 秋月電子 | CF25J4R7B | 125047 | 100本 | 1 | 50 | 50
抵抗 | カーボン抵抗 1/4W | 18 | 1 | R82 | 秋月電子 | CF25J18RB | 114272 | 100本 | 1 | 100 | 100 | 2026-10-29 確認
抵抗 | カーボン抵抗 1/4W | 47 | 1 | R83 | 秋月電子 | CF25J47RB | 125470 | 100本 | 1 | 200 | 200
抵抗 | カーボン抵抗 1/4W | 3.3k | 2 | R86, R92 | 秋月電子 | CF25J3K3B | 125332 | 100本 | 1 | 180 | 180
抵抗 | カーボン抵抗 1/2W | 22 | 2 | R93, R94 | 秋月電子 | CFS50J22RB | 107797 | 100本 | 1 | 160 | 160 | ファイナルの入力スワンプ（2026-10-29 確認）
抵抗 | カーボン抵抗 1/4W | 910 | 1 | R97 | 秋月電子 | CF25J910RB | 114277 | 100本 | 1 | 100 | 100
抵抗 | カーボン抵抗 1/4W | 47k | 1 | R102 | 秋月電子 | CF25J47KB | 118208 | 100本 | 1 | 150 | 150
半固定抵抗 | 半固定抵抗 TOCOS GF063P | 10k | 3 | VR1, VR3, VR4 | 秋月電子 | GF063P B103K | 114905 | 1個 | 3 | 30 | 90 | 確認時は入荷予定
半固定抵抗 | 半固定抵抗 TOCOS GF063P | 1k | 1 | VR2 | 秋月電子 | GF063P B102K | 114901 | 1個 | 1 | 30 | 30 | 確認時は入荷予定
半固定抵抗 | 半固定抵抗 TOCOS GF063P | 5k | 3 | VR5, VR6, VR7 | 秋月電子 | GF063P B502K | 114904 | 1個 | 3 | 30 | 90 | 確認時は在庫僅少
コンデンサ（セラミック） | 積層セラミックコンデンサ 0.1µF 50V X7R 2.54mm | 0.1u | 35 | C1, C3, C6, C10, C16, C17, C18, C19, C24, C34, C37, C38, C39, C40, C41, C42, C45, C46, C49, C50, C56, C61, C63, C65, C81, C85, C86, C97, C99, C101, C106, C107, C109, C113, C124 | 秋月電子 | RDER71H104K0P1H03B | 113582 | 10個 | 4 | 100 | 400
コンデンサ（セラミック） | 積層セラミックコンデンサ 22pF 50V（CH）2.54mm | 22p | 5 | C4, C11, C84, C87, C89 | 秋月電子 | RD15N220J1HL2L | 104060 | 10個 | 1 | 100 | 100
コンデンサ（セラミック） | 積層セラミックコンデンサ 0.33µF 50V X7R 2.54mm | 0.33u | 1 | C5 | 秋月電子 | RD15W334K1HL2L-10 | 115937 | 10個 | 1 | 170 | 170
コンデンサ（セラミック） | 積層セラミックコンデンサ 0.01µF 50V X7R 2.54mm | 0.01u | 24 | C8, C22, C26, C27, C29, C30, C31, C32, C33, C43, C47, C53, C54, C62, C90, C93, C94, C95, C96, C98, C100, C108, C110, C123 | 秋月電子 | RD15W103K1HL2L-10 | 104063 | 10個 | 3 | 100 | 300
コンデンサ（セラミック） | 積層セラミックコンデンサ 2pF 50V C0G | 2p | 1 | C9 | 秋月電子 | RDE5C1H2R0C0K1H03B | 108044 | 10個 | 1 | 100 | 100 | 足のピッチが 5mm なので寄せて 2.5mm の穴に入れる
コンデンサ（セラミック） | 積層セラミックコンデンサ 220pF 50V C0G | 220p | 4 | C13, C14, C52, C75 | 秋月電子 | RDE5C1H221J0K1H03B | 108106 | 10個 | 1 | 130 | 130 | 足のピッチが 5mm なので寄せて 2.5mm の穴に入れる
コンデンサ（セラミック） | 積層セラミックコンデンサ 0.01µF 50V C0G | 0.01u | 2 | C20, C25 | 秋月電子 | RDE5C1H103J1K1H03B | 108043 | 10個 | 1 | 200 | 200 | PLL のループフィルタ（容量が電圧で変わらない C0G）。足のピッチが 5mm なので寄せて 2.5mm の穴に入れる
コンデンサ（セラミック） | 積層セラミックコンデンサ 47pF 50V C0G | 47p | 3 | C23, C44, C112 | 秋月電子 | RDE5C1H470J0K1H03B | 108045 | 10個 | 1 | 130 | 130 | 足のピッチが 5mm なので寄せて 2.5mm の穴に入れる
コンデンサ（セラミック） | 積層セラミックコンデンサ 470pF 50V C0G | 470p | 1 | C36 | 秋月電子 | RDE5C1H471J0K1H03B | 108110 | 10個 | 1 | 130 | 130 | 足のピッチが 5mm なので寄せて 2.5mm の穴に入れる
コンデンサ（セラミック） | 積層セラミックコンデンサ 27pF 50V C0G | 27p | 1 | C48 | 秋月電子 | RDE5C1H270J0K1H03B | 108095 | 10個 | 1 | 100 | 100 | 足のピッチが 5mm なので寄せて 2.5mm の穴に入れる
コンデンサ（セラミック） | 積層セラミックコンデンサ 68pF 50V C0G 2.54mm | 68p | 2 | C51, C79 | 秋月電子 | RDE5C1H680J0P1H03B | 114323 | 5個 | 1 | 100 | 100
コンデンサ（セラミック） | 積層セラミックコンデンサ 56pF 50V C0G | 56p | 1 | C55 | 秋月電子 | RDE5C1H560J0K1H03B | 108099 | 10個 | 1 | 100 | 100 | 足のピッチが 5mm なので寄せて 2.5mm の穴に入れる
コンデンサ（セラミック） | 積層セラミックコンデンサ 2200pF 50V X7R 2.54mm | 2.2n | 2 | C57, C77 | 秋月電子 | RDER71H222K0P1H03B | 112060 | 1個 | 2 | 15 | 30
コンデンサ（セラミック） | 積層セラミックコンデンサ 0.047µF 50V X7R 2.54mm | 0.047u | 2 | C59, C67 | 秋月電子 | RDER71H473K0P1H03B | 112059 | 1個 | 2 | 15 | 30 | 確認時は在庫僅少
コンデンサ（セラミック） | 積層セラミックコンデンサ 1µF 50V X7R 2.54mm | 1u | 4 | C60, C71, C76, C80 | 秋月電子 | RD15W105K1HL2L-503 | 115940 | 10個 | 1 | 170 | 170
コンデンサ（セラミック） | 積層セラミックコンデンサ 0.47µF 50V X7R 2.54mm | 0.47u | 1 | C68 | 秋月電子 | RD15W474K1HL2L-10 | 115938 | 10個 | 1 | 170 | 170
コンデンサ（セラミック） | フィルムコンデンサ 4700pF 50V | 4.7n | 1 | C78 | 秋月電子 | 50F2D472J | 110336 | 1個 | 1 | 10 | 10 | 音声 LPF。足のピッチが 5mm なので寄せて 2.5mm の穴に入れる
コンデンサ（セラミック） | 積層セラミックコンデンサ 100pF 50V 2.54mm | 100p | 2 | C83, C122 | 秋月電子 | RD15N101J1HL2L-10 | 104061 | 10個 | 1 | 100 | 100
コンデンサ（セラミック） | 積層セラミックコンデンサ 1pF 50V C0G | 1p | 1 | C88 | 秋月電子 | RDE5C1H1R0C0K1H03B | 108082 | 10個 | 1 | 100 | 100 | 送信 BPF の段間結合。足のピッチが 5mm なので寄せて 2.5mm の穴に入れる
コンデンサ（セラミック） | 積層セラミックコンデンサ 100pF 50V C0G | 100p | 3 | C91, C111, C117 | 秋月電子 | RDE5C1H101J0K1H03B | 108063 | 10個 | 1 | 120 | 120 | 遅延・のこぎり波用は C0G を指定。足のピッチが 5mm なので寄せて 2.5mm の穴に入れる
コンデンサ（セラミック） | 積層セラミックコンデンサ 82pF 50V C0G | 82p | 1 | C92 | 秋月電子 | RDE5C1H820J0K1H03B | 108101 | 10個 | 1 | 150 | 150 | 足のピッチが 5mm なので寄せて 2.5mm の穴に入れる
コンデンサ（セラミック） | 積層セラミックコンデンサ 180pF 50V C0G | 180p | 1 | C102 | 秋月電子 | RDE5C1H181J0K1H03B | 108105 | 10個 | 1 | 100 | 100 | 足のピッチが 5mm なので寄せて 2.5mm の穴に入れる
コンデンサ（セラミック） | 積層セラミックコンデンサ 120pF 50V C0G | 120p | 1 | C103 | 秋月電子 | RDE5C1H121J0K1H03B | 108103 | 10個 | 1 | 100 | 100 | 足のピッチが 5mm なので寄せて 2.5mm の穴に入れる
コンデンサ（セラミック） | 積層セラミックコンデンサ 1000pF 50V C0G | 1000p | 3 | C104, C105, C119 | 秋月電子 | RDE5C1H102J0K1H03B | 108114 | 10個 | 1 | 130 | 130 | 足のピッチが 5mm なので寄せて 2.5mm の穴に入れる
コンデンサ（セラミック） | セラミックコンデンサ 120pF 500V 以上 C0G（NP0）5mm | 120p | 2 | C115, C120 | DigiKey／Mouser（要確認） | C0G 500V〜1kV ディスク 120pF |  |  |  |  |  | 送信 LPF。50V 品・B 特性は使わない
コンデンサ（セラミック） | セラミックコンデンサ 220pF 500V 以上 C0G（NP0）5mm | 220p | 2 | C116, C118 | DigiKey／Mouser（要確認） | C0G 500V〜1kV ディスク 220pF |  |  |  |  |  | 送信 LPF。50V 品・B 特性は使わない
コンデンサ（セラミック） | セラミックコンデンサ 4.7pF 500V 以上 C0G（NP0） | 4.7p | 1 | C121 | DigiKey／Mouser（要確認） | C0G 500V〜1kV ディスク 4.7pF |  |  |  |  |  | 秋月の高耐圧品は 22pF 2kV（111548）と 470pF 1kV（B 特性）だけ
コンデンサ（電解） | 電解コンデンサ 470µF 25V | 470u | 1 | C2 | 秋月電子 | 25PX470MEFC8X11.5 | 117883 | 1個 | 1 | 20 | 20
コンデンサ（電解） | 電解コンデンサ 10µF 50V | 10u | 10 | C7, C12, C15, C21, C28, C35, C58, C66, C74, C82 | 秋月電子 | 50PX10MEFC5X11 | 117897 | 1個 | 10 | 10 | 100
コンデンサ（電解） | 電解コンデンサ 100µF 25V | 100u | 1 | C64 | 秋月電子 | 25PX100MEFC5X11 | 117877 | 1個 | 1 | 10 | 10 | φ5（穴は φ6.3 用、2.5mm ピッチ）
コンデンサ（電解） | 電解コンデンサ 220µF 25V | 220u | 2 | C69, C114 | 秋月電子 | 25PX220MEFC6.3X11 | 117879 | 1個 | 2 | 20 | 40
コンデンサ（電解） | 電解コンデンサ 47µF 35V | 47u | 3 | C70, C72, C73 | 秋月電子 | 35PX47MEFC5X11 | 117887 | 1個 | 3 | 10 | 30
トリマコンデンサ | セラミックトリマコンデンサ 30pF（緑） | 30p | 5 | TC1, TC2, TC3, TC4, TC5 | 秋月電子 | TMCV01-30P100VBG | 115472 | 1個 | 5 | 25 | 125
コイル | トロイダルコア T-30-6（0.4mm ポリウレタン線を巻く） | T30-6 17T/2T | 4 | L1, L4, L7, L8 | 秋月電子 | T-30-6 | 116458 | 1個 | 4 | 210 | 840 | 17 回、コールド側から 2 回目でタップ
コイル | マイクロインダクタ 10µH | 10uH | 4 | L2, L5, L9, L11 | 秋月電子 | AL0510-100K | 104922 | 10本 | 1 | 110 | 110
コイル | マイクロインダクタ 4.7µH | 4.7uH | 2 | L3, L14 | 秋月電子 | AL0410-4R7K | 104931 | 10本 | 1 | 80 | 80 | 段間同調 2
コイル | トロイダルコア T-50-6（0.8mm ポリウレタン線を巻く） | T50-6 15T・T50-6 9T・T50-6 10T | 4 | L6, L13, L15, L16 | 秋月電子 | T-50-6 | 111947 | 1個 | 4 | 410 | 1640 | 巻数は値のとおり（9T・10T）
コイル | フェライトトロイダルコア FT-37-43 | FT37-43 10T | 1 | L10 | 秋月電子 | FT-37-43 | 131660 | 1個 | 1 | 310 | 310 | 10 回
コイル | マイクロインダクタ 1µH | 1uH | 1 | L12 | 秋月電子 | AL0410-1R0K | 104930 | 10本 | 1 | 80 | 80 | 段間同調 3
トランス | めがねコア BN-43-202 | BN43-202 2T:2T(CT)・BN43-202 2T(CT):3T | 2 | T1, T2 | DigiKey | Fair-Rite 2843002402（BN-43-202） |  |  |  |  |  | 在庫あり 約 $0.19（集計サイトの値（2026-10-29 調べ））。巻き方は各トランスの備考と README のコイル表のとおり
ダイオード | 逆接続保護ダイオード 3A | 1N5408 | 1 | D1 | 秋月電子 | 1N5822 | 102229 | 10個 | 1 | 350 | 350 | 秋月に 1N5408 はない。代わりにショットキー 1N5822（40V 3A、DO-201AD）。逆接続で 5A ヒューズを切る
ダイオード | 小信号ダイオード | 1N4148 | 6 | D2, D3, D9, D10, D11, D12 | 秋月電子 | 1N4148 | 100941 | 50本 | 1 | 200 | 200
ダイオード | 整流ダイオード 1A（VCO の可変容量に使う） | 1N4007・1N4001 | 2 | D4, D8 | 秋月電子 | 1N4007-3485 | 100934 | 20本 | 1 | 100 | 100 | 1N4001 と同じ袋から ／ 1N4001 の代わりに 1N4007
ダイオード | ショットキーダイオード 40V 1A | 1N5819 | 1 | D5 | 秋月電子 | 1N5819 | 117244 | 10本 | 1 | 100 | 100
ダイオード | ゲルマニウムダイオード | 1N60 | 3 | D6, D7, D13 | サトー電気 など（要確認） | 1N60 |  |  |  |  |  | 秋月に扱いなし
トランジスタ・FET | NPN トランジスタ | 2SC1815 | 5 | Q1, Q3, Q4, Q5, Q6 | 秋月電子 | 2SC1815L-GR-T92 | 106477 | 20個 | 1 | 100 | 100
トランジスタ・FET | N-ch JFET | 2N3819 | 1 | Q2 | DigiKey（取り寄せ） | 2N3819 APM PBFREE（Central） |  |  |  |  |  | Central 品は量産中だが DigiKey の在庫なし・取り寄せ（納期 8〜18 週）（2026-10-29 調べ）
トランジスタ・FET | N-ch MOSFET | 2N7000 | 1 | Q7 | 秋月電子 | 2N7000 | 109723 | 1個 | 1 | 40 | 40
トランジスタ・FET | PNP トランジスタ | 2SA1015 | 3 | Q8, Q9, Q10 | 秋月電子 | 2SA1015L-GR-T92 | 106734 | 20個 | 1 | 100 | 100
トランジスタ・FET | NPN トランジスタ（TO-92、送信バッファ） | 2N2222A | 1 | Q11 | DigiKey など | 2N2222A（TO-92、E-B-C の並び） |  |  |  |  |  | DigiKey に複数メーカーの在庫あり（2026-10-29 調べ）。2N3866（製造中止）の代わり
トランジスタ・FET | N-ch パワー MOSFET（TO-220、ドライバ 1・ファイナル 2） | IRF510 | 3 | Q12, Q13, Q14 | DigiKey | IRF510PBF（Vishay、IRF510PBF-ND） |  |  |  |  |  | DigiKey に 1 万個以上（標準納期 15〜20 週、2026-10-29 調べ）。RD06HHF1・RD16HHF1（製造終了）の代わり。タブ = ドレイン
IC・レギュレータ・モジュール | D フリップフロップ（AC、DIP） | 74AC74 | 1 | U1 | DigiKey | SN74AC74N（296-4342-5-ND） |  |  |  |  |  | DigiKey 在庫あり 約 $0.77（2026-10-29 調べ）。PLL の位相比較。必ず AC 品
IC・レギュレータ・モジュール | 3 端子レギュレータ 5V 100mA | 78L05 | 1 | U2 | 秋月電子 | L78L05ACZ | 101250 | 5個 | 1 | 100 | 100 | ピン配置（OUT-GND-IN）を基板と照合する
IC・レギュレータ・モジュール | 2 入力 NAND（AC、DIP） | 74AC00 | 1 | U3 | DigiKey | SN74AC00N（296-4287-5-ND） |  |  |  |  |  | DigiKey 在庫あり（標準納期 12 週）（2026-10-29 調べ）。PLL の位相比較のリセット。必ず AC 品
IC・レギュレータ・モジュール | 3 端子レギュレータ 8V 1.5A（TO-220） | L7808 | 1 | U4 | DigiKey | L7808CV（4491-L7808CV-ND、Lumimax） |  |  |  |  |  | DigiKey マーケットプレイスに在庫あり 約 $0.50（2026-10-29 調べ）。ST 品（497-2949-5-ND）は在庫なし
IC・レギュレータ・モジュール | DC-DC コンバータ 5V 1A（78xx 互換） | R-78E5.0-1.0 | 1 | U5 | DigiKey／Mouser | R-78E5.0-1.0 |  |  |  |  |  | 秋月は 0.5A 品 R-78E5.0-0.5（106353）のみ
IC・レギュレータ・モジュール | 3 端子レギュレータ 5V 1.5A | L7805 | 1 | U6 | 秋月電子 | L7805CV-DG | 107903 | 1個 | 1 | 120 | 120
IC・レギュレータ・モジュール | 2 回路オペアンプ（DIP-8） | MCP6002 | 2 | U7, U16 | 秋月電子 | MCP6002-E/P | 130011 | 1個 | 2 | 80 | 160 | 確認時は入荷予定
IC・レギュレータ・モジュール | 3.3V LDO レギュレータ | LP2950-3.3 | 1 | U8 | 秋月電子 | LP2950L-33-T92 | 108749 | 1個 | 1 | 30 | 30
IC・レギュレータ・モジュール | 対数増幅 IC（DIP-8、S メーター） | AD8307ANZ | 1 | U9 | DigiKey／Mouser（要確認） | AD8307ANZ |  |  |  |  |  | Analog Devices。2026-10-29 時点で量産品、DigiKey の標準納期 10 週。秋月に扱いなし
IC・レギュレータ・モジュール | ダブルバランスドミキサ（SSOP8、表面実装） | NJM2594V | 1 | U10 | 秋月電子 | NJM2594V | 111195 | 1個 | 1 | 150 | 150 | SA612AN（製造中止）の代わり。0.65mm ピッチを部品面に手はんだ
IC・レギュレータ・モジュール | Si5351A クロックジェネレータモジュール | AE-Si5351A | 1 | U11 | 秋月電子 | AE-Si5351A-B | 110679 | 1セット | 1 | 650 | 650 | ピン配置を基板と照合してから取り付ける
IC・レギュレータ・モジュール | アンバッファインバータ（DIP） | 74HCU04 | 2 | U12, U22 | DigiKey | SN74HCU04N（296-9820-5-ND） |  |  |  |  |  | DigiKey JP 在庫あり 約 ¥115（2026-10-29 調べ）。代わりに CD74HCU04E（296-33167-5-ND）も可。必ず U 付き
IC・レギュレータ・モジュール | 16 ビット I2C ADC モジュール（ADS1115） | ADS1115 module | 1 | U13 | DigiKey（Adafruit 1085）／Amazon など（要確認） | Adafruit 1085 または同じピン並び（VDD GND SCL SDA ADDR ALRT A0〜A3）のモジュール |  |  |  |  |  | 付属のピンヘッダをはんだ付けし、基板のピンソケットに差す。秋月に扱いなし
IC・レギュレータ・モジュール | FM IF IC（DIP-16） | MC3361 | 1 | U14 | LCSC／海外通販（要注意） | MC3361BPL-D16-T（UTC、DIP-16）または MC3361BP |  |  |  |  |  | Motorola 品は製造中止（2026-10-29 調べ）。UTC の互換品が LCSC で約 $0.22。古い在庫品は eBay など
IC・レギュレータ・モジュール | Seeed Studio XIAO ESP32C3 | XIAO ESP32C3 | 1 | U15 | 秋月電子 | 113991054 | 117454 | 1個 | 1 | 1080 | 1080 | 確認時は在庫僅少
IC・レギュレータ・モジュール | オーディオアンプ（DIP-8） | LM386N-1 | 1 | U17 | 秋月電子 | LM386G-D08 | 114548 | 1個 | 1 | 40 | 40 | LM386N-1 の互換品（HTC）
IC・レギュレータ・モジュール | 4 回路オペアンプ（DIP-14） | MCP6004 | 1 | U18 | DigiKey | MCP6004-I/P（MCP6004-I/P-ND） |  |  |  |  |  | DigiKey 在庫あり 約 $0.59（2026-10-29 調べ）
IC・レギュレータ・モジュール | ワンショット（HCT、DIP） | 74HCT123 | 1 | U19 | DigiKey | CD74HCT123E |  |  |  |  |  | DigiKey に約 4,600 個（2026-10-29 調べ）。2 回路とも使う（PM のパルスとリセットパルス）
IC・レギュレータ・モジュール | シュミットインバータ（AC、DIP） | 74AC14 | 2 | U20, U23 | DigiKey | SN74AC14N（296-4301-5-ND） |  |  |  |  |  | DigiKey JP 在庫あり 約 ¥120/個（2026-10-29 調べ）。必ず AC 品
IC・レギュレータ・モジュール | 2 入力 XOR（AC、DIP） | 74AC86 | 1 | U21 | DigiKey | SN74AC86N（296-4345-5-ND） |  |  |  |  |  | DigiKey 在庫あり 約 $0.66（2026-10-29 調べ）。必ず AC 品
水晶・フィルタ | 10.7MHz 水晶フィルタ（15kHz 幅、3 ピン） | 10M15A | 1 | FL1 | DigiKey | ECS-10.7-15A（X703-ND） |  |  |  |  |  | 10.7MHz・帯域 15kHz・3 端子、終端 3kΩ。DigiKey は標準納期 18 週（2026-10-29 調べ）
水晶・フィルタ | 455kHz セラミックフィルタ | CFWLA455KFFA | 1 | FL2 | 秋月電子 | LT455EU | 116046 | 1個 | 1 | 65 | 65 | CFWLA455KFFA の代わり（±7.5kHz）。ピン配置・寸法を基板と照合する
水晶・フィルタ | 水晶振動子 10.245MHz（HC-49/U） | 10.245MHz | 1 | X1 | Tayda／LCSC | 10.245MHz HC-49/S（例: YXC X49SD10245MSD2SC） |  |  |  |  |  | HC-49/U の DigiKey 品は見つからない（2026-10-29 調べ）。HC-49/S（背の低い品）なら安く手に入り、足の間隔は同じ。負荷容量 18〜20pF
水晶・フィルタ | セラミックディスクリミネータ 455kHz | CDBM455C24 | 1 | X2 | 要確認（製造中止の恐れ） | CDBM455C24（村田） |  |  |  |  |  | 村田の 455kHz ディスクリミネータは DigiKey で製造中止の品が多い（2026-10-29 調べ）。在庫を確かめてから。入手できないときは 455kHz の LC 同調（コイル ＋ C）で置き換えを検討
リレー | リレー DPDT 12V（オムロン G5V-2） | G5V-2 DC12 | 1 | K1 | LCSC／DigiKey（要確認） | G5V-2-DC12 |  |  |  |  |  | LCSC に在庫あり（2026-10-29 調べ）。DigiKey は未確認
コネクタ | ビニール線（AWG18 など） | DC 13.8V | 1 | J1 | 手持ち／ホームセンター |  |  |  |  |  |  | DC 入力・ANT（ANT は RG-174 同軸）
コネクタ | ピンヘッダ | I2C・LCD・VOL・ENC・SP・MIC・TX LED | 7 | J2, J3, J4, J5, J6, J7, J9 | 秋月電子 | PH-1x40SG | 100167 | 1本(40P) | 1 | 35 | 35 | J2・J3・J7・J5・J4・J6・J9 で 1 本
コネクタ | ビニール線（AWG18 など） | ANT | 1 | J8 | 手持ち／ホームセンター |  |  |  |  |  |  | DC 入力・ANT（ANT は RG-174 同軸）
テストポイント | テストポイント | VT | 1 | TP1 | 手持ち |  |  |  |  |  |  | 抵抗の足の切れ端をループにして立てる
テストポイント | テストポイント | TXOSC | 1 | TP2 | 手持ち |  |  |  |  |  |  | 抵抗の足の切れ端をループにして立てる
テストポイント | テストポイント | RAMP | 1 | TP3 | 手持ち |  |  |  |  |  |  | 抵抗の足の切れ端をループにして立てる
テストポイント | テストポイント | THRESH | 1 | TP4 | 手持ち |  |  |  |  |  |  | 抵抗の足の切れ端をループにして立てる
テストポイント | テストポイント | COMP | 1 | TP5 | 手持ち |  |  |  |  |  |  | 抵抗の足の切れ端をループにして立てる
テストポイント | テストポイント | PM | 1 | TP6 | 手持ち |  |  |  |  |  |  | 抵抗の足の切れ端をループにして立てる
テストポイント | テストポイント | X16 | 1 | TP7 | 手持ち |  |  |  |  |  |  | 抵抗の足の切れ端をループにして立てる
回路図に載っていない部品 | IC ソケット 8P |  | 4 |  | 秋月電子 | 2227-08-03 | 100017 | 10個 | 1 | 110 | 110 | U7・U9・U16・U17
回路図に載っていない部品 | IC ソケット 14P |  | 8 |  | 秋月電子 | 2227-14-03 | 100006 | 10個 | 1 | 120 | 120 | U1・U3・U12・U18・U20・U21・U22・U23
回路図に載っていない部品 | IC ソケット 16P |  | 2 |  | 秋月電子 | 2227-16-03 | 100007 | 10個 | 1 | 180 | 180 | U14・U19
回路図に載っていない部品 | ピンソケット 1×7（XIAO 用） |  | 2 |  | 秋月電子 | FH-1x7SG/RH | 104285 | 1個 | 2 | 20 | 40 | U15
回路図に載っていない部品 | ピンソケット 1×10（ADS1115 モジュール用） |  | 1 |  | 秋月／千石 など（要確認） | ピンソケット 1×10 2.54mm（40P を切ってもよい） |  |  |  |  |  | U13
回路図に載っていない部品 | TO-220 用 絶縁シート＋絶縁ブッシング |  | 3 |  | 秋月／マルツ など（要確認） | TO-220 用 シリコン（またはマイカ）絶縁シートと絶縁ブッシング |  |  |  |  |  | IRF510 × 3（タブ = ドレインなので放熱器から絶縁する）
回路図に載っていない部品 | 放熱器 20PB020（ドライバ IRF510 用） |  | 1 |  | 秋月電子 | 20PB020-01025 | 105054 | 1個 | 1 | 80 | 80 | HS1（基板に付ける）
回路図に載っていない部品 | 放熱器 16PB017（L7808 用） |  | 1 |  | 秋月電子 | 16PB017-01025 | 105053 | 1個 | 1 | 60 | 60 | U4。取り付けられる向き・隙間を要確認
回路図に載っていない部品 | 放熱器（ファイナル IRF510 × 2 用、ケース内に立てる） |  | 1 |  | 秋月／マルツ など（要確認） | 熱抵抗 5〜8℃/W、幅 50 × 高さ 30 mm 程度 |  |  |  |  |  | ケースの後面の窓からフィンを出す（enclosure/README.md）
回路図に載っていない部品 | ロータリーエンコーダ |  | 1 |  | 秋月電子 | EC12E2420801 | 106357 | 1個 | 1 | 100 | 100 | 押しスイッチ付きか要確認。確認時は在庫僅少 TUNE（J5）
回路図に載っていない部品 | AF ボリューム 10kΩA |  | 1 |  | 秋月電子 | SH16K4A103L20KCCI | 129553 | 1個 | 1 | 60 | 60 | VOL（J4）
回路図に載っていない部品 | 電源スイッチ |  | 1 |  | 要確認 | φ13 穴に合う 2A 以上のもの |  |  |  |  |  | POWER
回路図に載っていない部品 | 電源 LED（3mm 緑） |  | 1 |  | 秋月電子 | OSG5TA3Z74A | 111635 | 1個 | 1 | 20 | 20 | 2.2kΩ を直列に ON
回路図に載っていない部品 | TX ランプ（3mm 赤） |  | 1 |  | 秋月電子 | OSR5JA3Z74A | 111577 | 1個 | 1 | 10 | 10 | TX（J9）
回路図に載っていない部品 | マイクコネクタ 4P 丸型（パネル取付 φ16） |  | 1 |  | 千石電商／マルツ など（要確認） | 4P 丸型マイクコネクタ（メス） |  |  |  |  |  | MIC（J7）
回路図に載っていない部品 | 外部スピーカージャック（スイッチ付き） |  | 1 |  | 秋月電子 | MJ-352W-C | 117359 | 1個 | 1 | 175 | 175 | M6 ナットでふたに固定 EXT SP（J6）
回路図に載っていない部品 | スピーカー 5cm 8Ω 0.5W |  | 1 |  | 秋月電子 | DXYD50N-22Z-8A-F | 116024 | 1個 | 1 | 250 | 250 | ふた裏に M3 皿ねじ＋ナット 4 本
回路図に載っていない部品 | LCD Nextion NX4832T035（3.5 インチ 480×320） |  | 1 |  | Nextion 公式ストア／Amazon など（要確認） | NX4832T035 |  |  |  |  |  | PSN_TRX と同じ。TJC4832T135（AliExpress の TJC 公式ストア）でも可（画面データは別に作る）。作り方は firmware/Serrasoid_TRX/nextion J3
回路図に載っていない部品 | DC ジャック 2.1mm（パネル取付） |  | 1 |  | 秋月電子 | MJ-14 | 106342 | 1個 | 1 | 70 | 70 | 後面
回路図に載っていない部品 | ヒューズホルダ（パネル取付） |  | 1 |  | 秋月電子 | MF-524M | 107079 | 1個 | 1 | 210 | 210 | 後面
回路図に載っていない部品 | ヒューズ 5A（5×20mm） |  | 1 |  | 秋月電子 | MF51NR 250V 5 | 107131 | 1個 | 1 | 40 | 40
回路図に載っていない部品 | BNC コネクタ（パネル取付） |  | 1 |  | 秋月電子 | B-014IF | 100093 | 1個 | 1 | 150 | 150 | 後面、J8 へ RG-174
回路図に載っていない部品 | M3 インサートナット |  | 24 |  | Amazon／モノタロウ |  |  |  |  |  |  | ケース（enclosure/README.md）
回路図に載っていない部品 | M3 ねじ・皿ねじ・ナット |  | 1 |  | ホームセンター／モノタロウ |  |  |  |  |  |  | 本数は enclosure/README.md
