kazushinjo/Serrasoid_TRX_29M/enclosure/drawings/8_rear_panel_2d.dxf

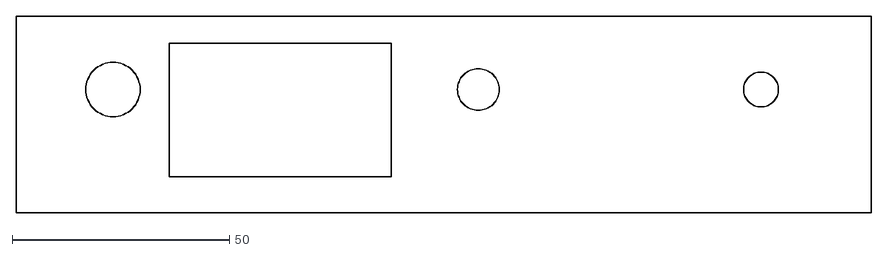
[picture p19: CAD file, 2026-10-15]
enclosure/drawings/8_rear_panel_2d.dxf
196.6 x 45.1
