kazushinjo/Serrasoid_TRX_29M/enclosure/stl/3_front_panel.stl

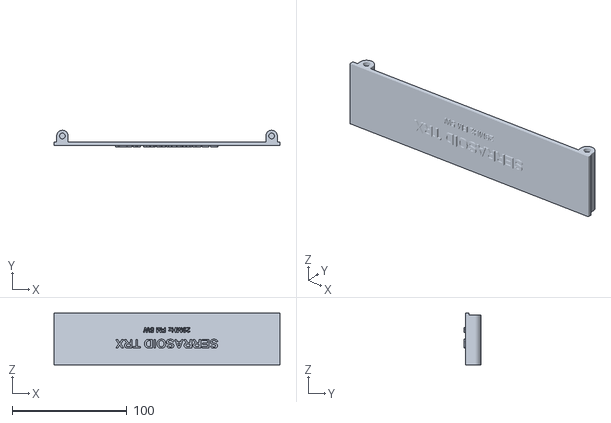
[picture p20: CAD file, 2026-10-28]
enclosure/stl/3_front_panel.stl
196.6 x 14.4 x 45.1
