kazushinjo/Serrasoid_TRX_29M/enclosure/drawings/7_front_panel_2d.dxf

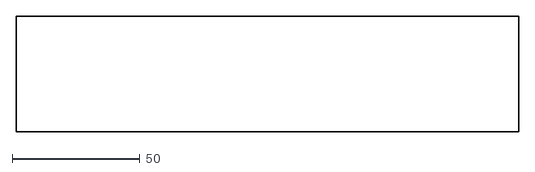
[picture p21: CAD file, 2026-10-15]
enclosure/drawings/7_front_panel_2d.dxf
196.6 x 45.1
