kazushinjo/Serrasoid_TRX_29M/enclosure/stl/1_base.stl

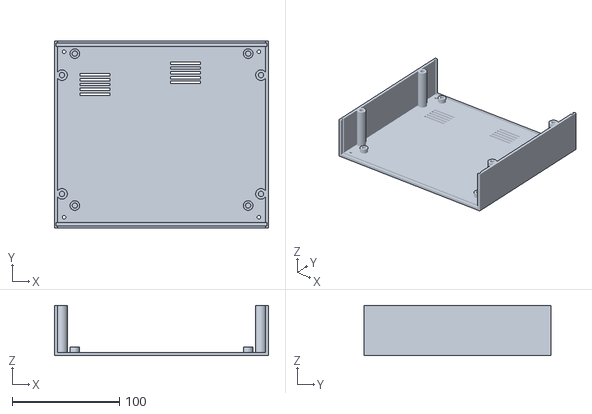
[picture p22: CAD file, 2026-10-28]
enclosure/stl/1_base.stl
200.0 x 175.0 x 47.0
