kazushinjo/Serrasoid_TRX_29M/enclosure/stl/2_lid.stl

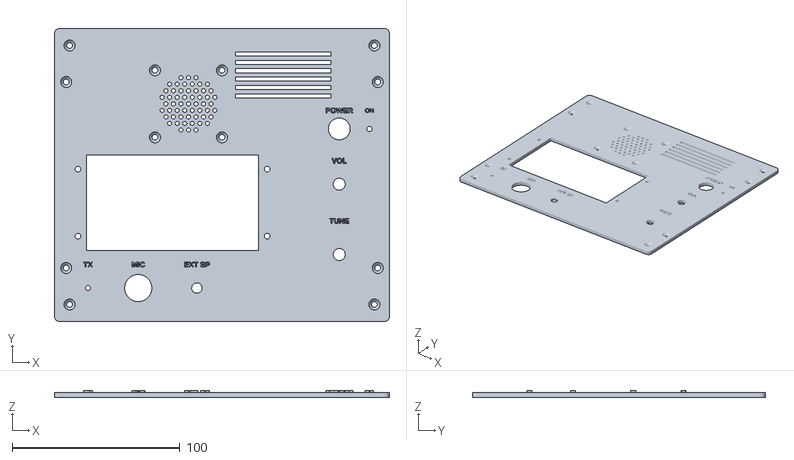
[picture p23: CAD file, 2026-10-15]
enclosure/stl/2_lid.stl
200.0 x 175.0 x 4.20
