kazushinjo/Serrasoid_TRX_29M/enclosure/stl/4_rear_panel.stl

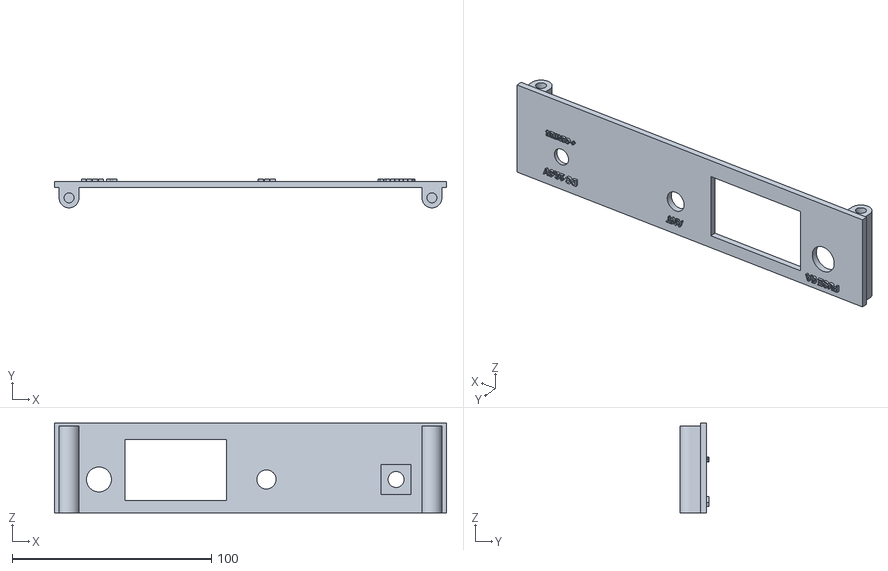
[picture p24: CAD file, 2026-10-15]
enclosure/stl/4_rear_panel.stl
196.6 x 14.4 x 45.1
