kazushinjo/Serrasoid_TRX_29M/enclosure/stl/10_speaker_holder.stl

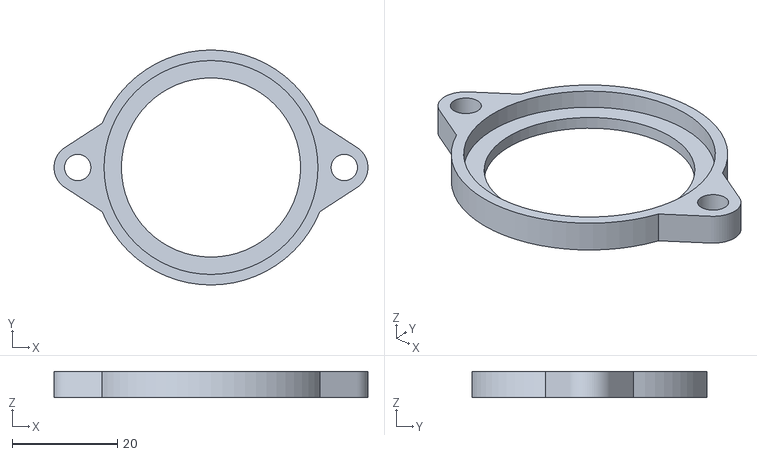
[picture p25: CAD file, 2026-10-15]
enclosure/stl/10_speaker_holder.stl
59.6 x 44.6 x 5.00
