kazushinjo/Serrasoid_TRX_29M/enclosure/stl/9_lcd_bezel.stl

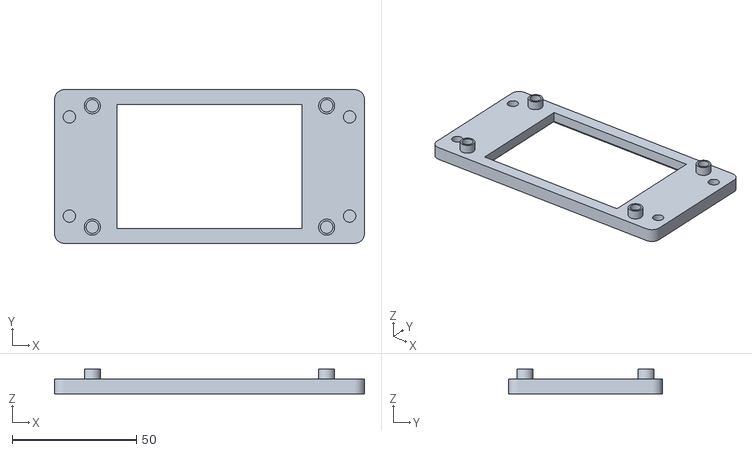
[picture p26: CAD file, 2026-10-15]
enclosure/stl/9_lcd_bezel.stl
125.0 x 62.0 x 10.0
