kazushinjo/Serrasoid_TRX_29M/docs/Serrasoid_TRX_部品実装図.pdf

### ↑ 後面（DC 入力・ファイナル IRF510・ANT）

# Serrasoid TRX 29M 部品実装図（部品面）

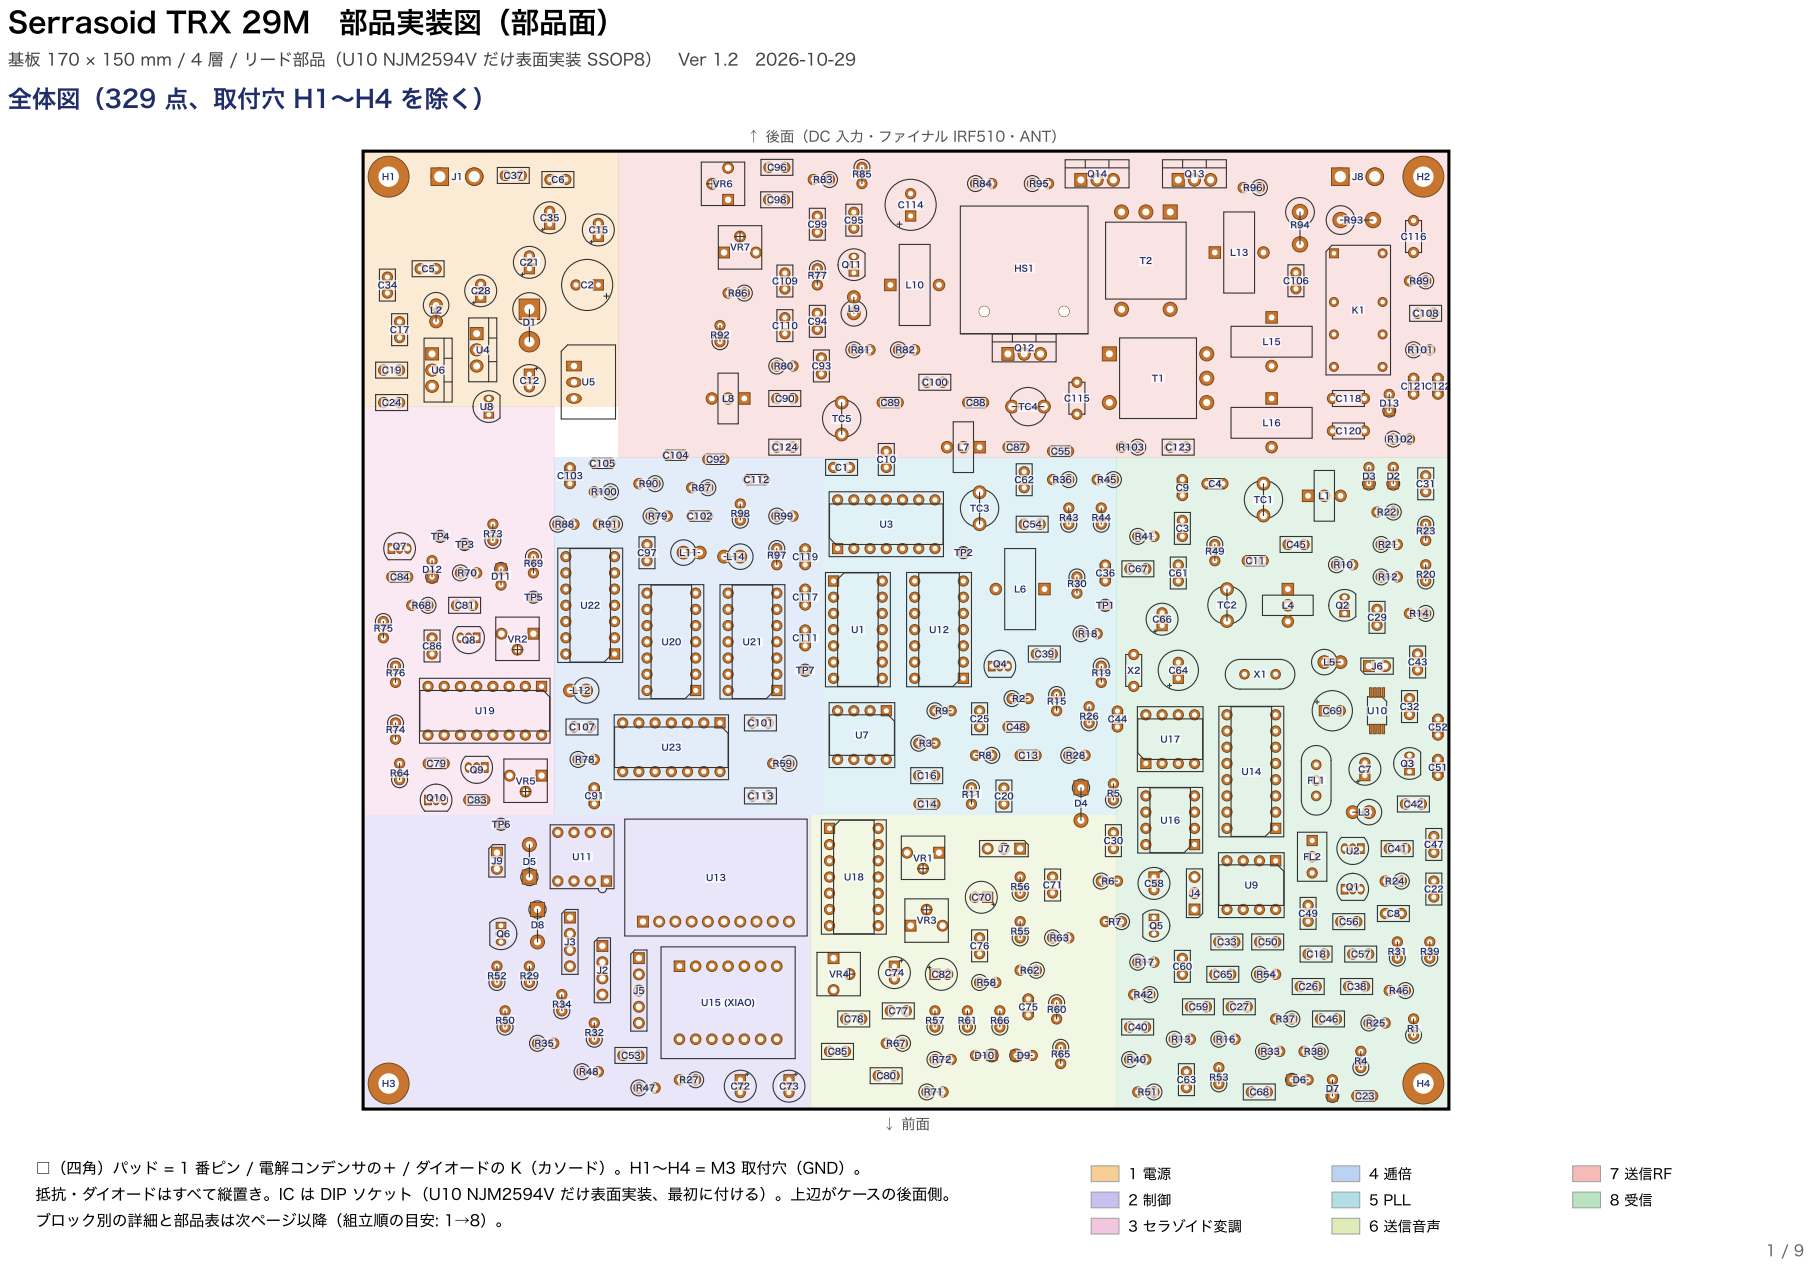
[picture p27: page 1]

基板 170 × 150 mm / 4 層 / リード部品（U10 NJM2594V だけ表面実装 SSOP8）　Ver 1.2 2026-10-29
全体図（329 点、取付穴 H1〜H4 を除く）

□（四角）パッド = 1 番ピン / 電解コンデンサの＋ / ダイオードの K（カソード）。H1〜H4 = M3 取付穴（GND）。

抵抗・ダイオードはすべて縦置き。IC は DIP ソケット（U10 NJM2594V だけ表面実装、最初に付ける）。上辺がケースの後面側。
ブロック別の詳細と部品表は次ページ以降（組立順の目安: 1→8）。

### ↑ 後面（DC 入力・ファイナル IRF510・ANT）

部品番号 | 値/型番 | 種類 | 注意

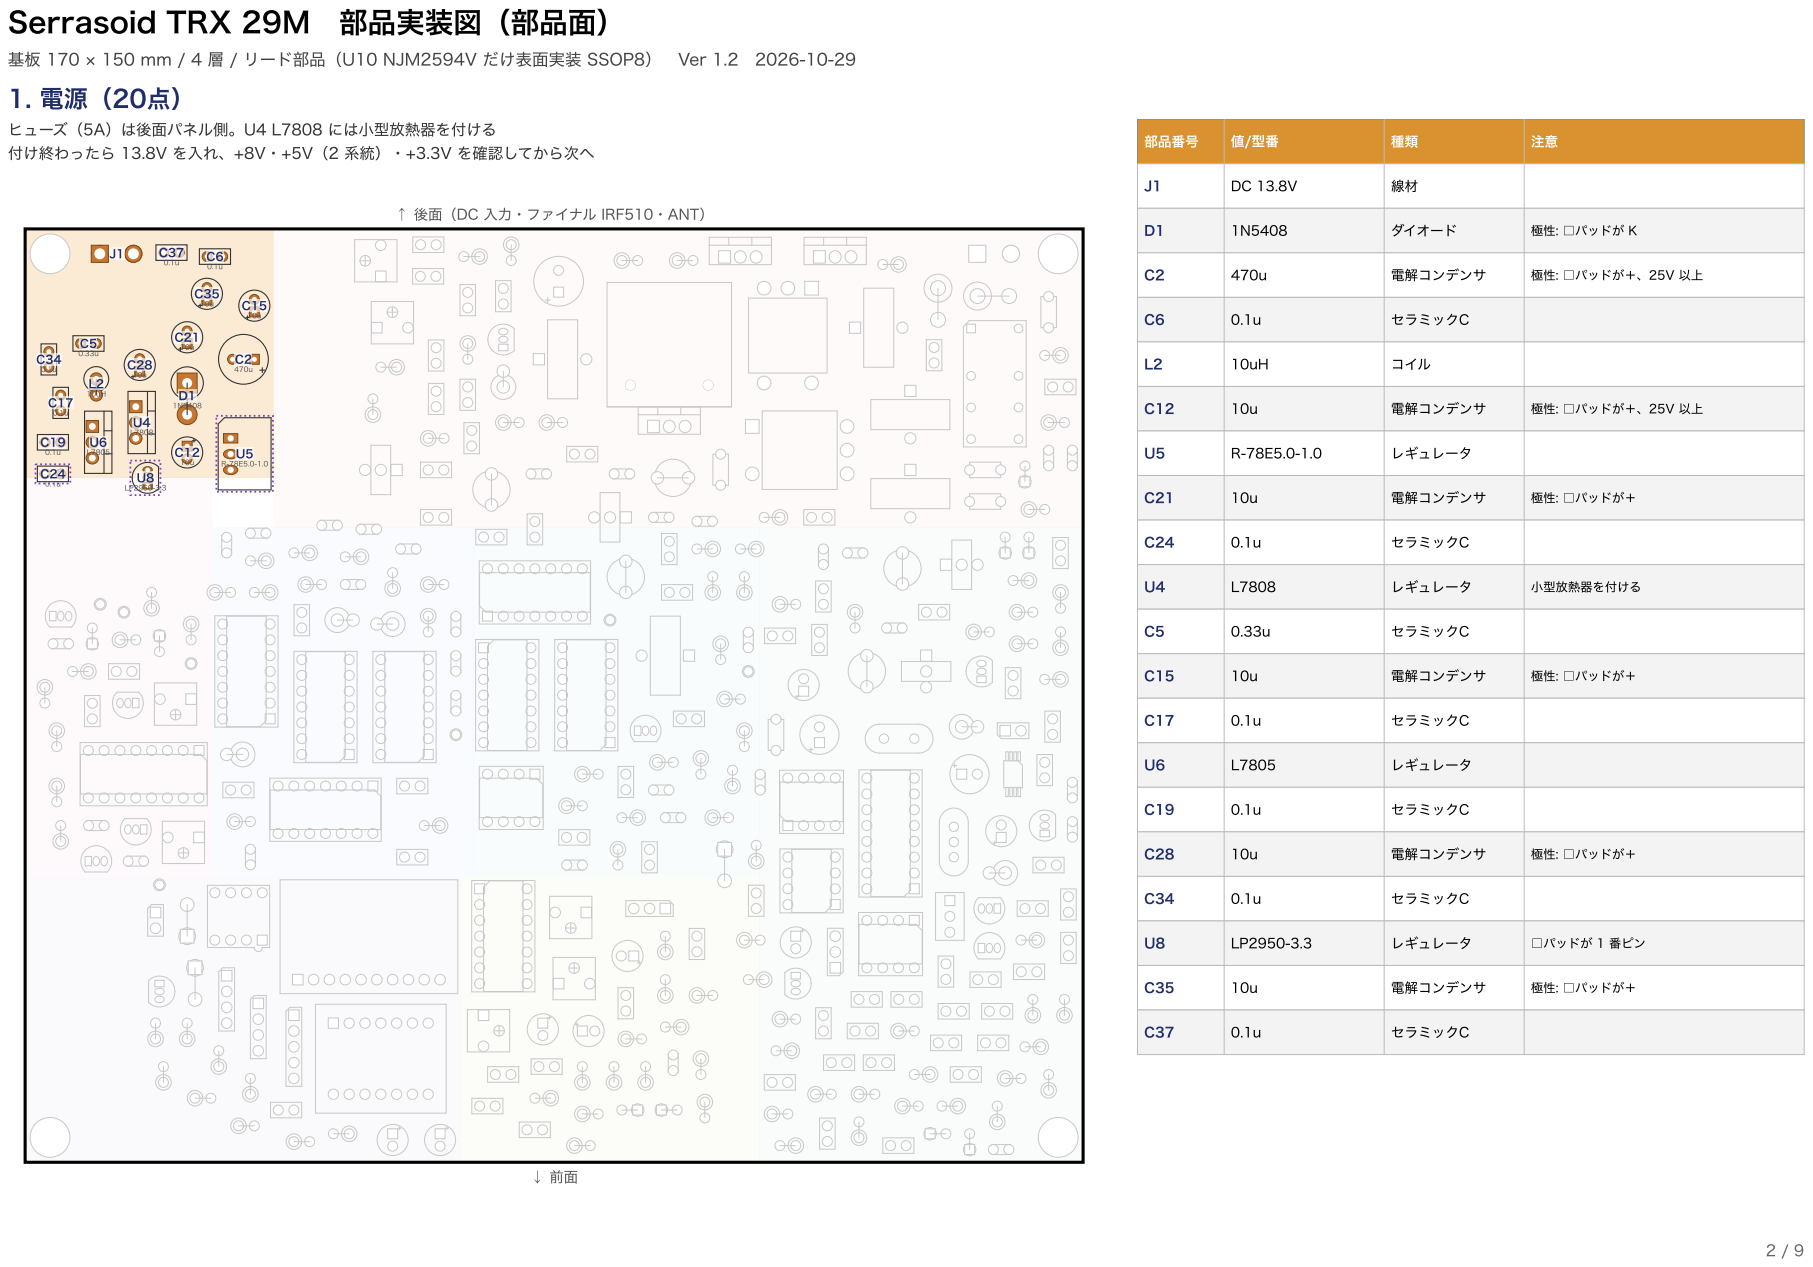
[picture p28: page 2]

ヒューズ（5A）は後面パネル側。U4 L7808 には小型放熱器を付ける
付け終わったら 13.8V を入れ、+8V・+5V（2 系統）・+3.3V を確認してから次へ

### ↑ 後面（DC 入力・ファイナル IRF510・ANT）

部品番号 | 値/型番 | 種類 | 注意

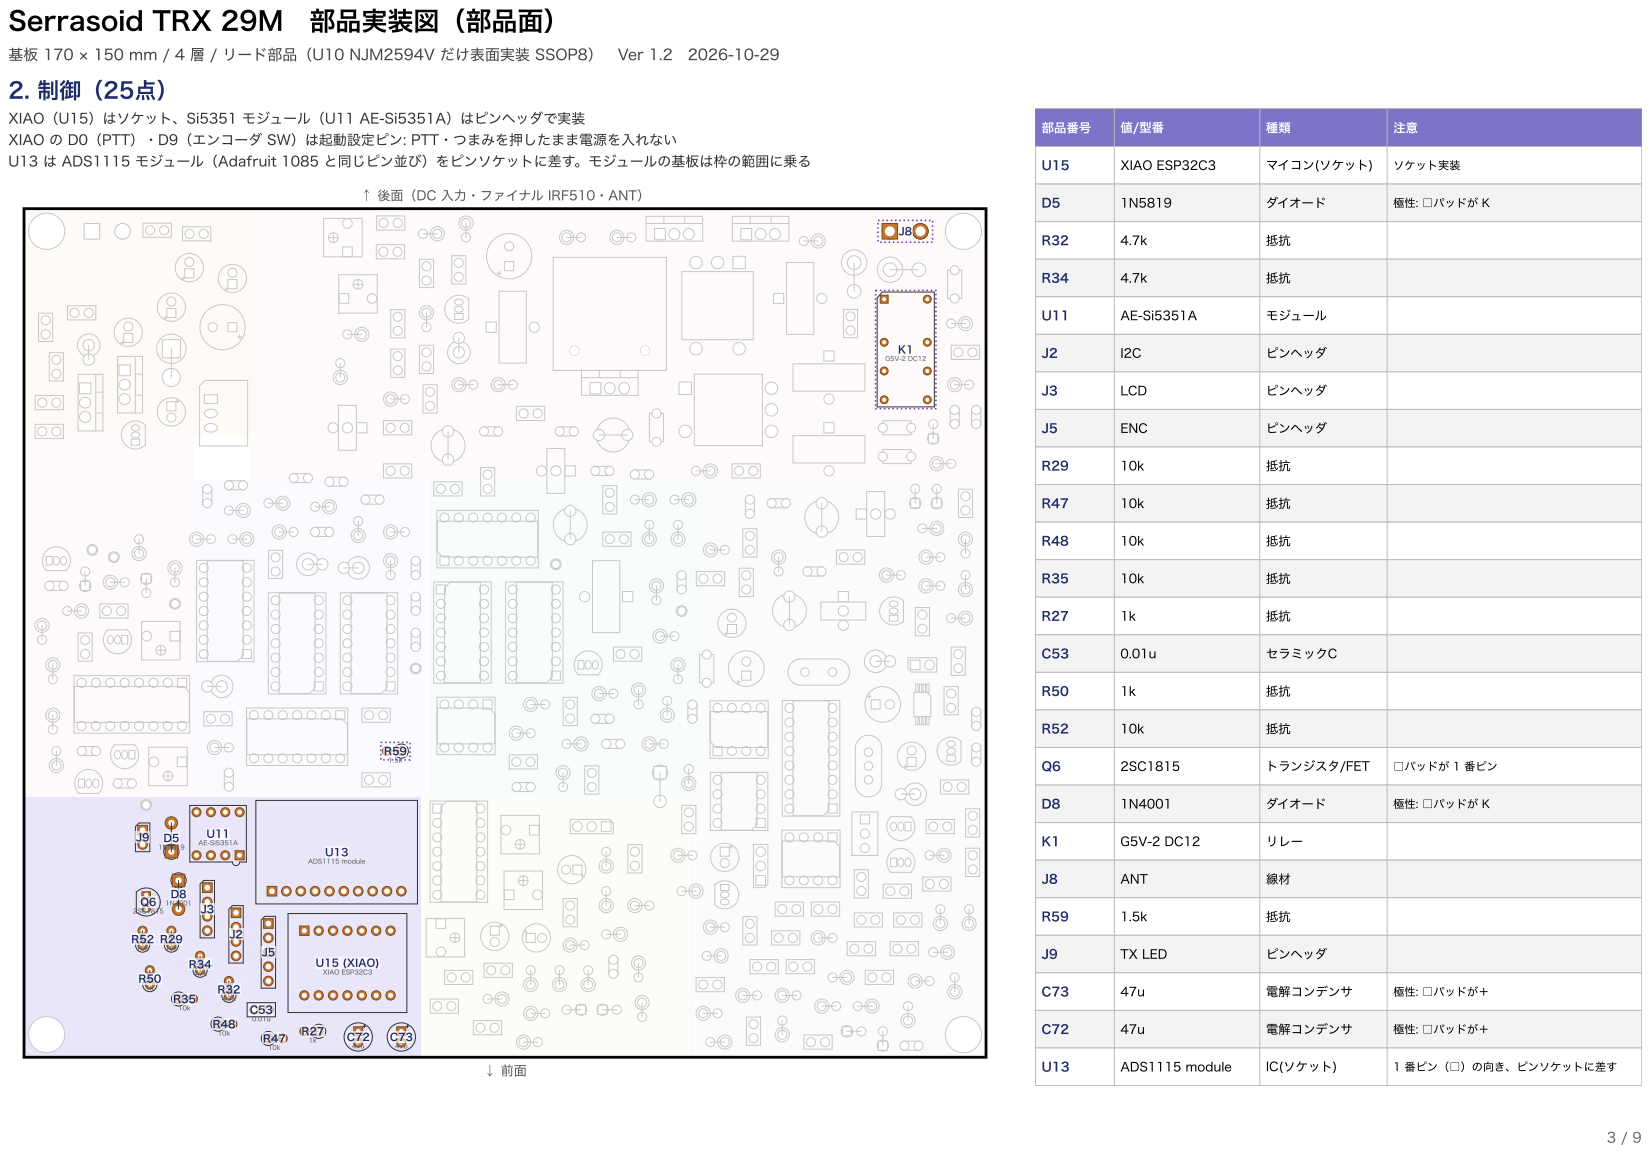
[picture p29: page 3]

XIAO（U15）はソケット、Si5351 モジュール（U11 AE-Si5351A）はピンヘッダで実装
XIAO の D0（PTT）・D9（エンコーダ SW）は起動設定ピン: PTT・つまみを押したまま電源を入れない
U13 は ADS1115 モジュール（Adafruit 1085 と同じピン並び）をピンソケットに差す。モジュールの基板は枠の範囲に乗る

### ↑ 後面（DC 入力・ファイナル IRF510・ANT）

部品番号 | 値/型番 | 種類 | 注意

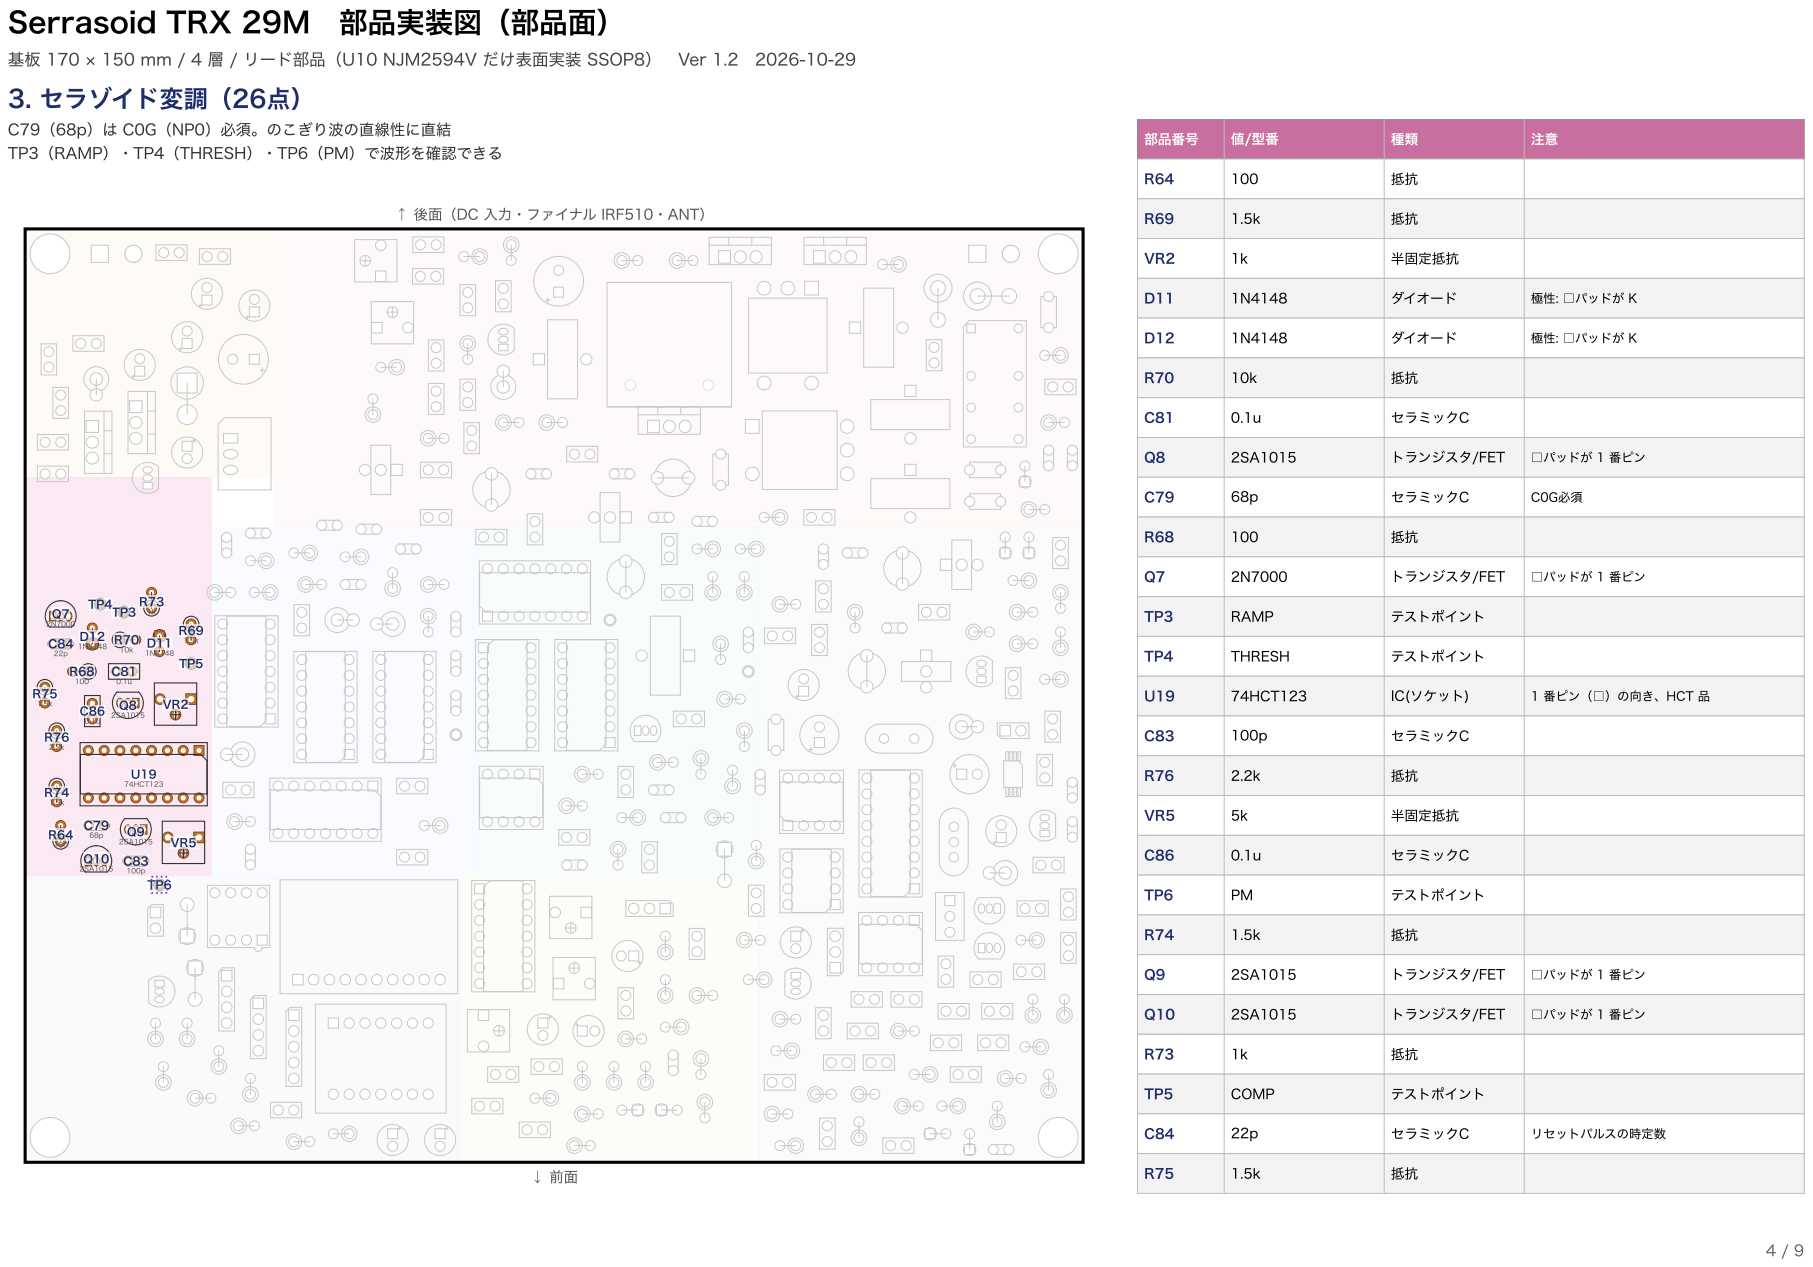
[picture p30: page 4]

C79（68p）は C0G（NP0）必須。のこぎり波の直線性に直結
TP3（RAMP）・TP4（THRESH）・TP6（PM）で波形を確認できる

### ↑ 後面（DC 入力・ファイナル IRF510・ANT）

部品番号 | 値/型番 | 種類 | 注意

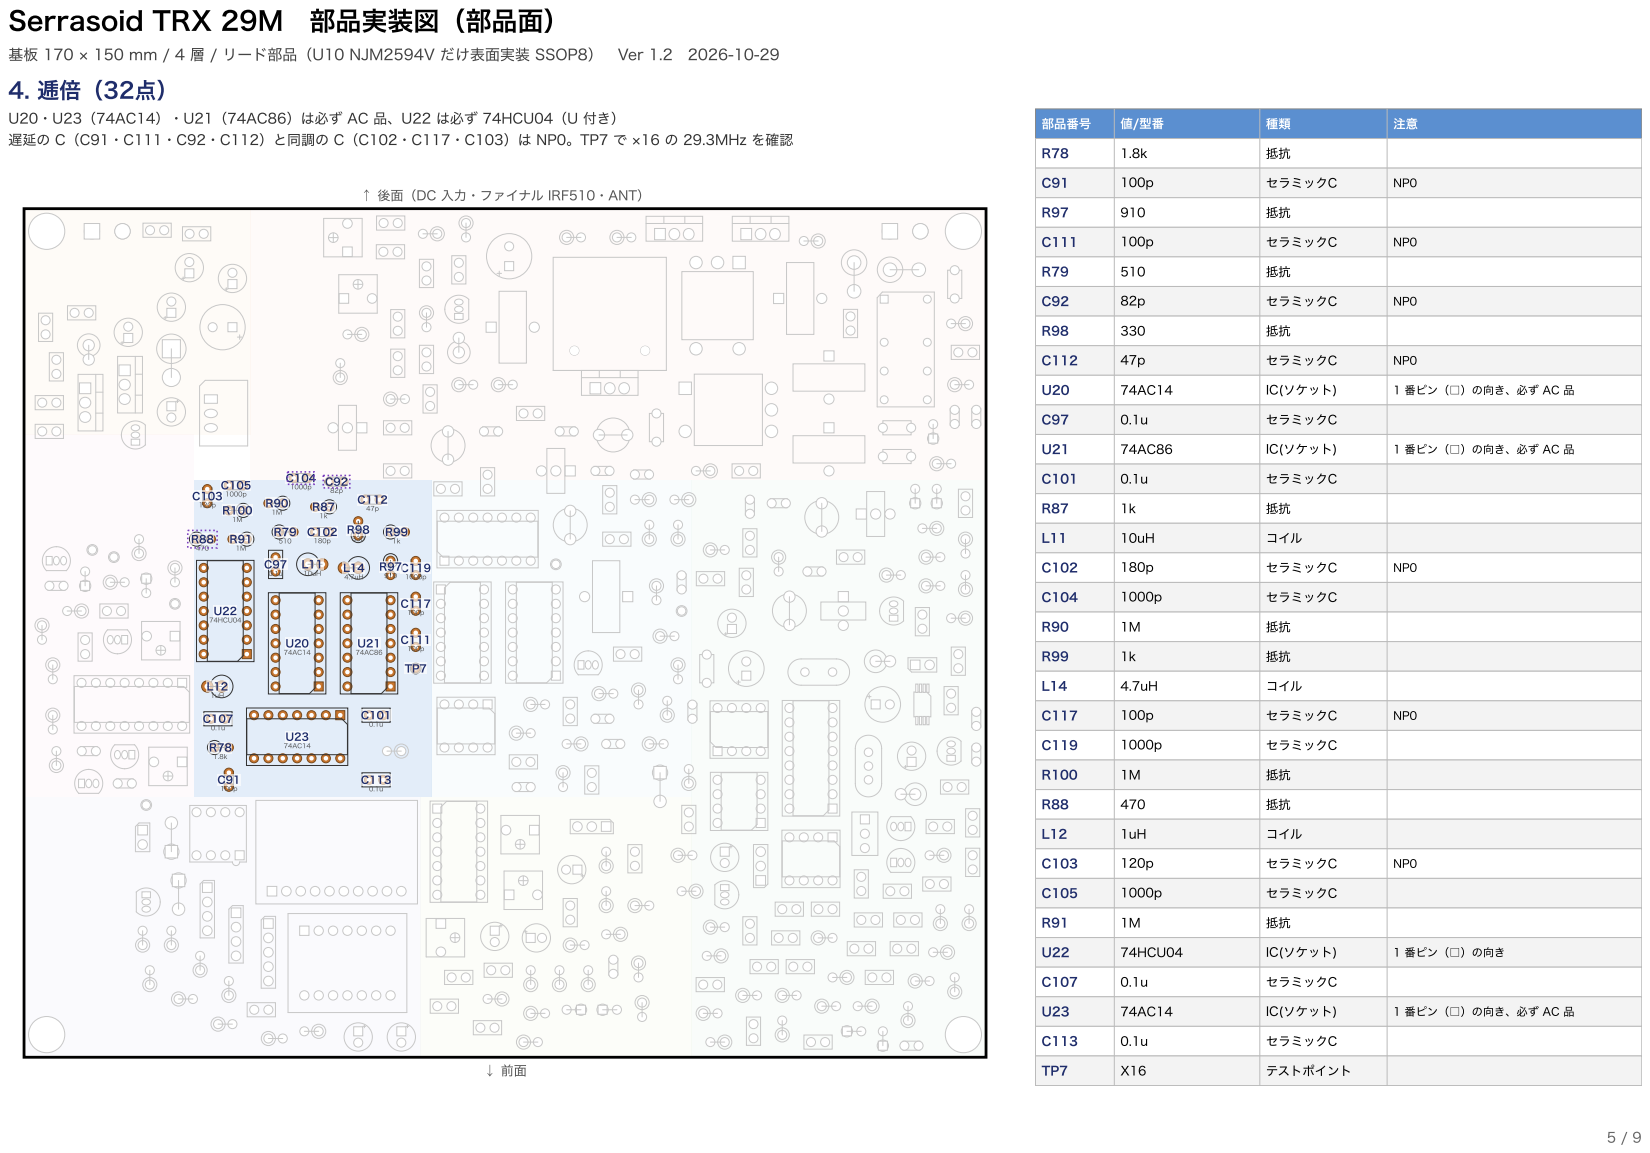
[picture p31: page 5]

U20・U23（74AC14）・U21（74AC86）は必ず AC 品、U22 は必ず 74HCU04（U 付き）
遅延の C（C91・C111・C92・C112）と同調の C（C102・C117・C103）は NP0。TP7 で ×16 の 29.3MHz を確認

### ↑ 後面（DC 入力・ファイナル IRF510・ANT）

部品番号 | 値/型番 | 種類 | 注意

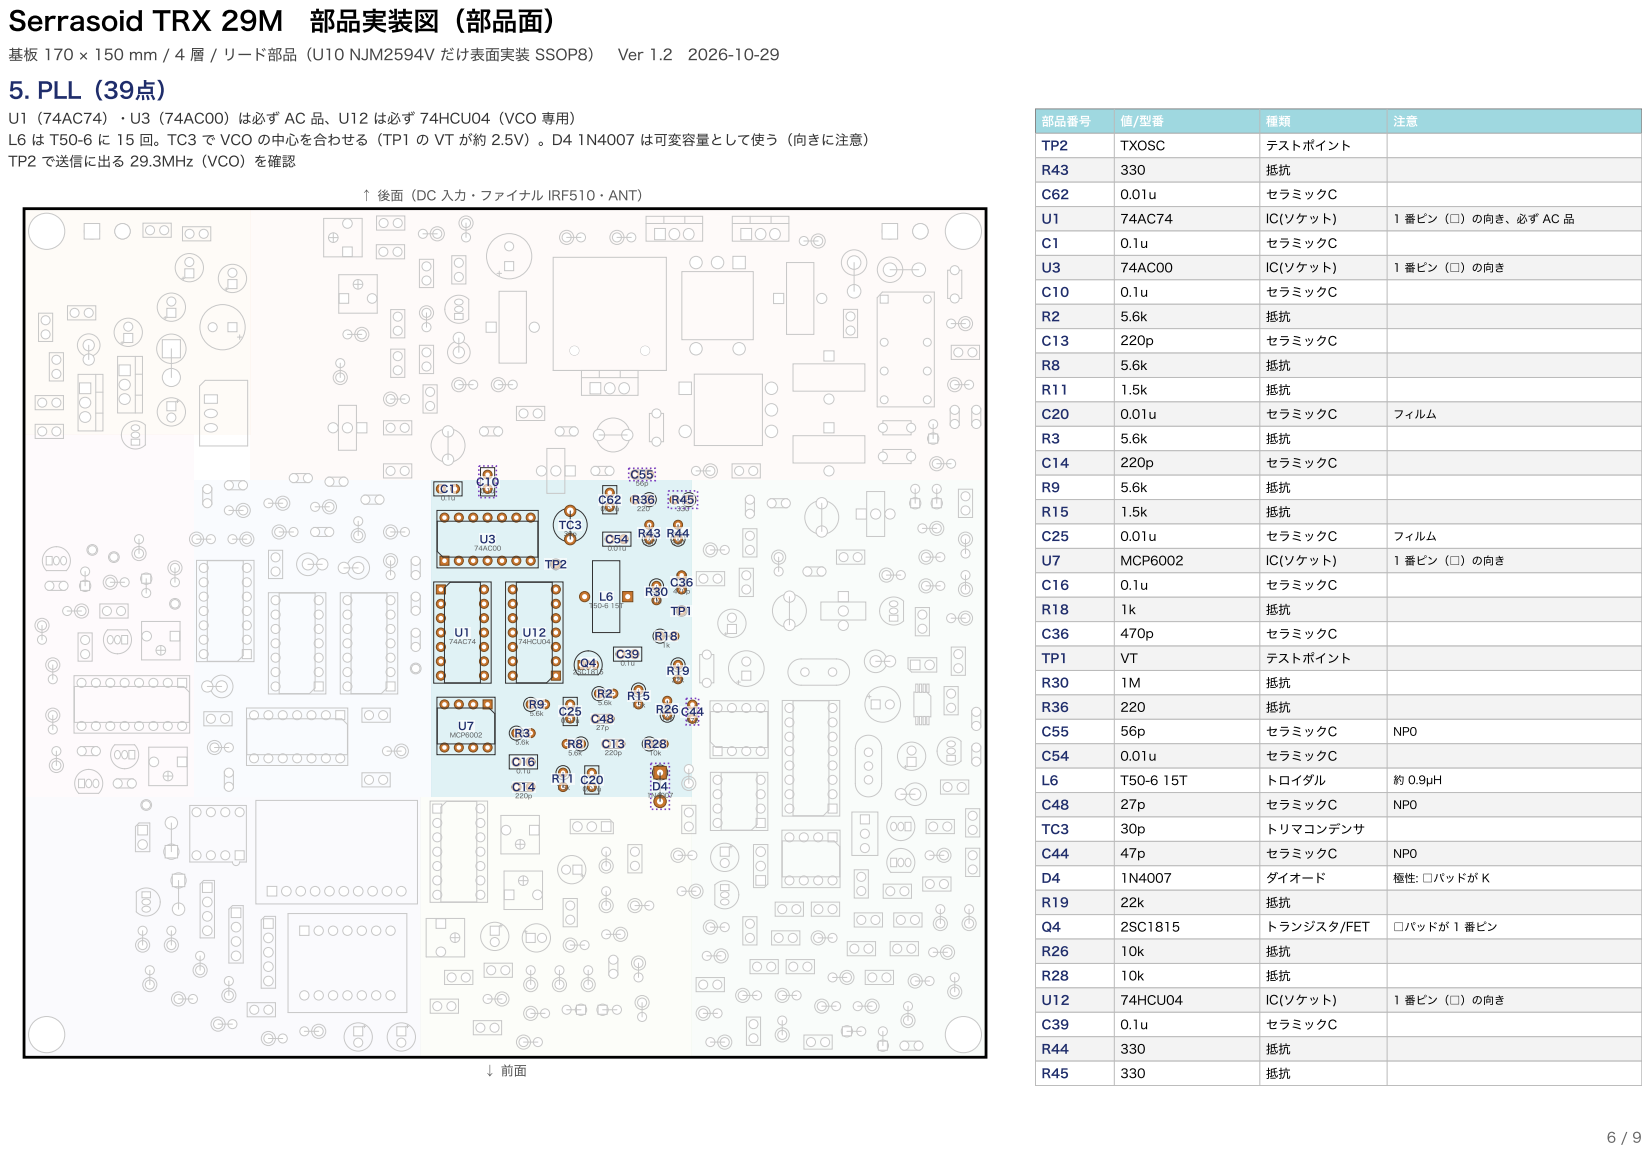
[picture p32: page 6]

U1（74AC74）・U3（74AC00）は必ず AC 品、U12 は必ず 74HCU04（VCO 専用）
L6 は T50-6 に 15 回。TC3 で VCO の中心を合わせる（TP1 の VT が約 2.5V）。D4 1N4007 は可変容量として使う（向きに注意）
TP2 で送信に出る 29.3MHz（VCO）を確認

### ↑ 後面（DC 入力・ファイナル IRF510・ANT）

部品番号 | 値/型番 | 種類 | 注意

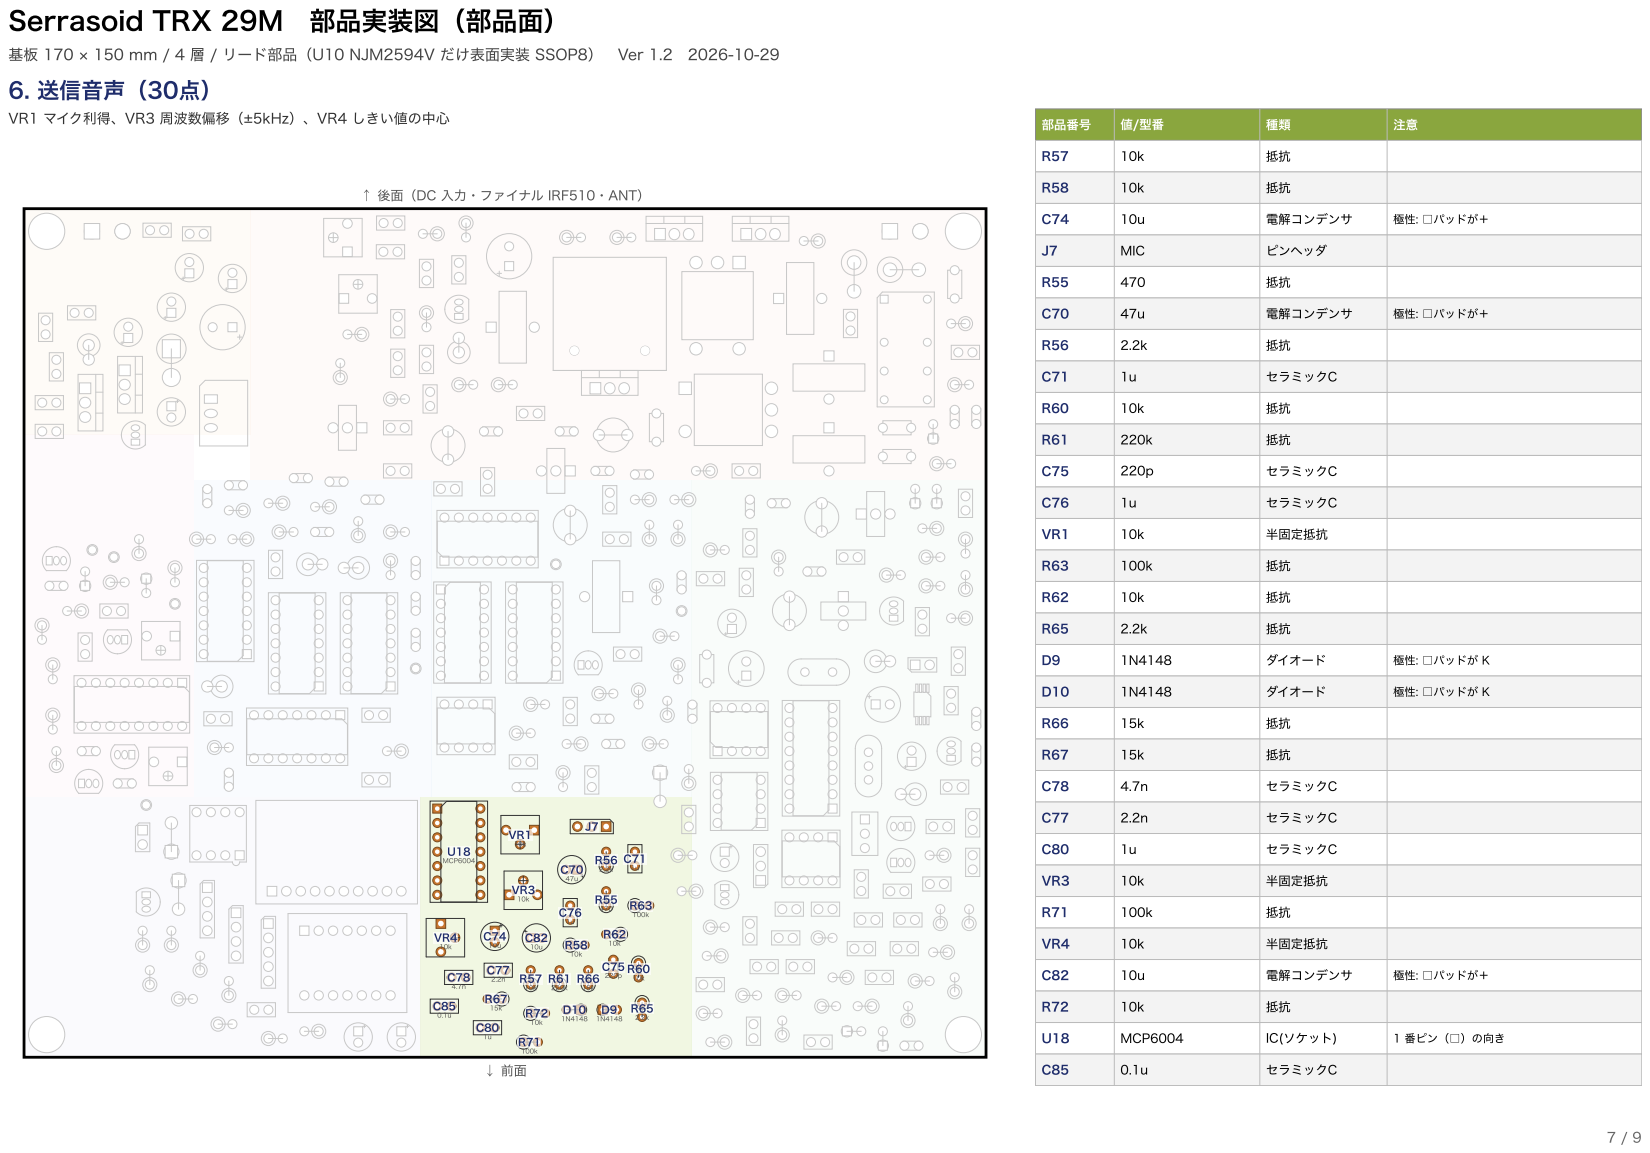
[picture p33: page 7]

### ↑ 後面（DC 入力・ファイナル IRF510・ANT）

部品番号値/型番 | 種類 | 注意

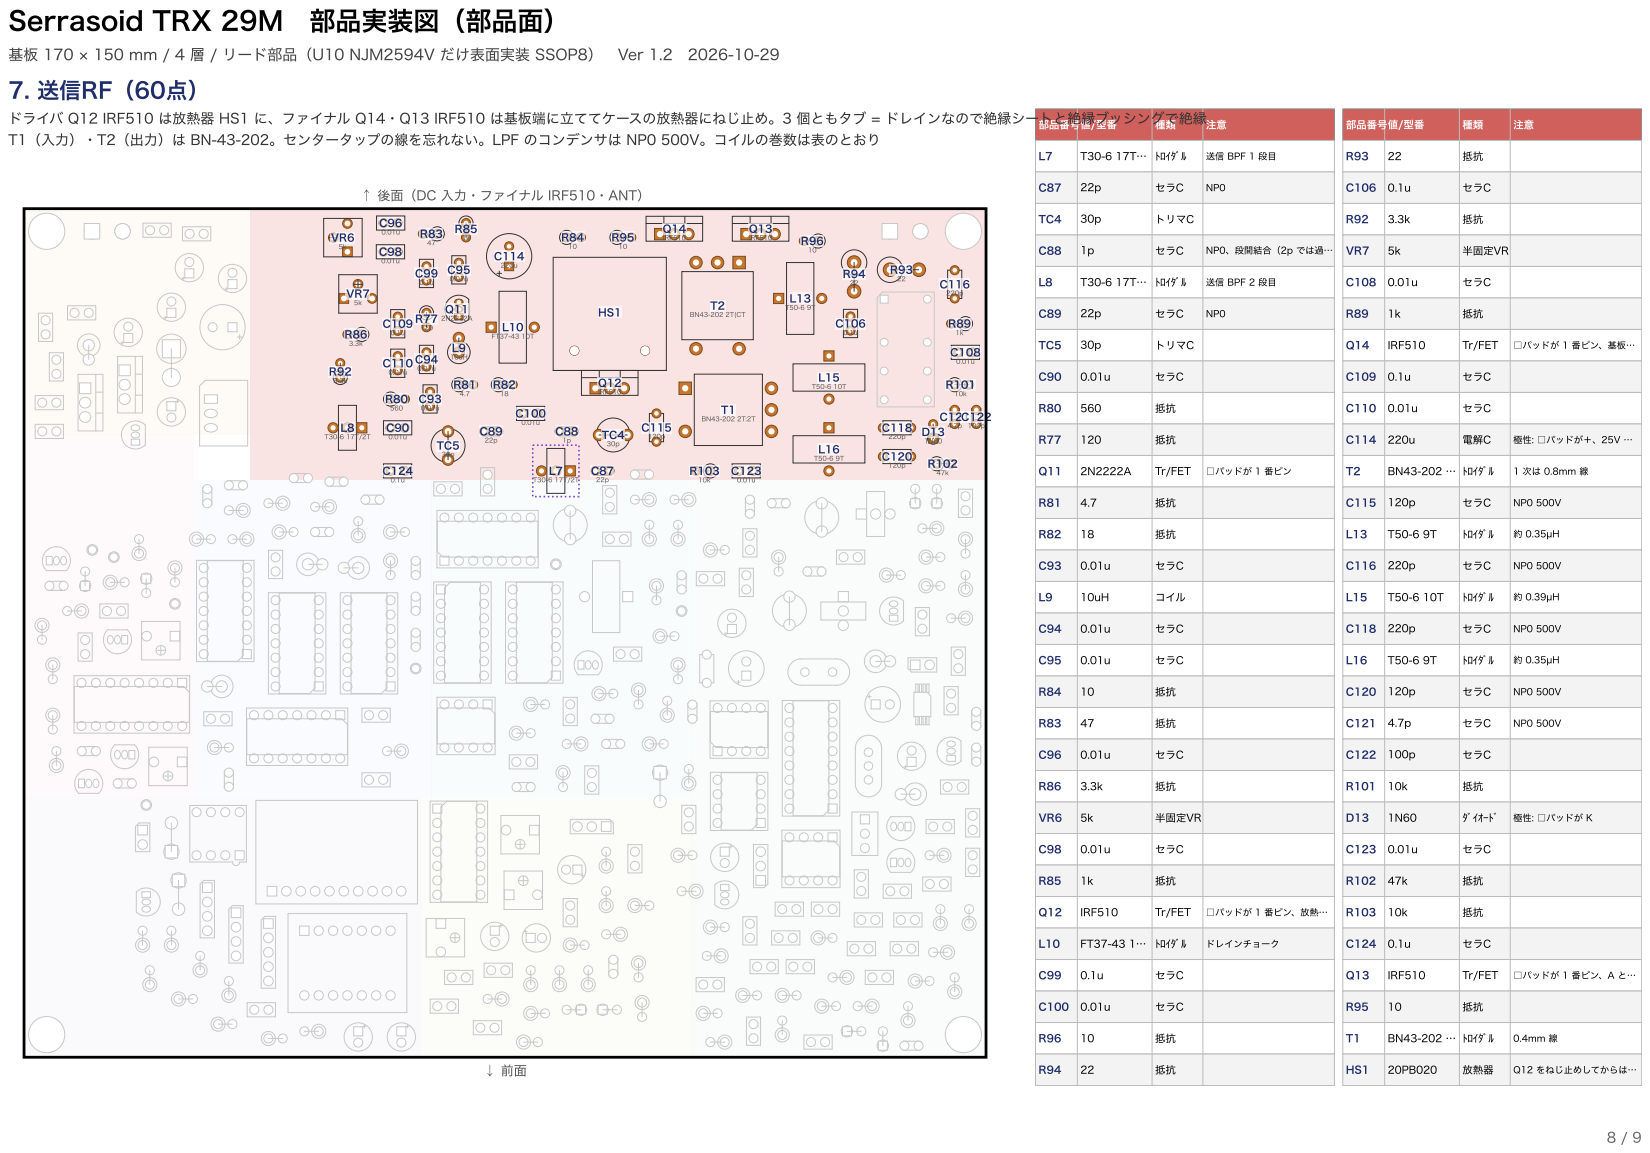
[picture p34: page 8]

ドライバ Q12 IRF510 は放熱器 HS1 に、ファイナル Q14・Q13 IRF510 は基板端に立ててケースの放熱器にねじ止め。3 個ともタブ = ドレインなので絶縁シートと絶縁ブッシングで絶縁
T1（入力）・T2（出力）は BN-43-202。センタータップの線を忘れない。LPF のコンデンサは NP0 500V。コイルの巻数は表のとおり

### ↑ 後面（DC 入力・ファイナル IRF510・ANT）

部品番号値/型番 | 種類 | 注意

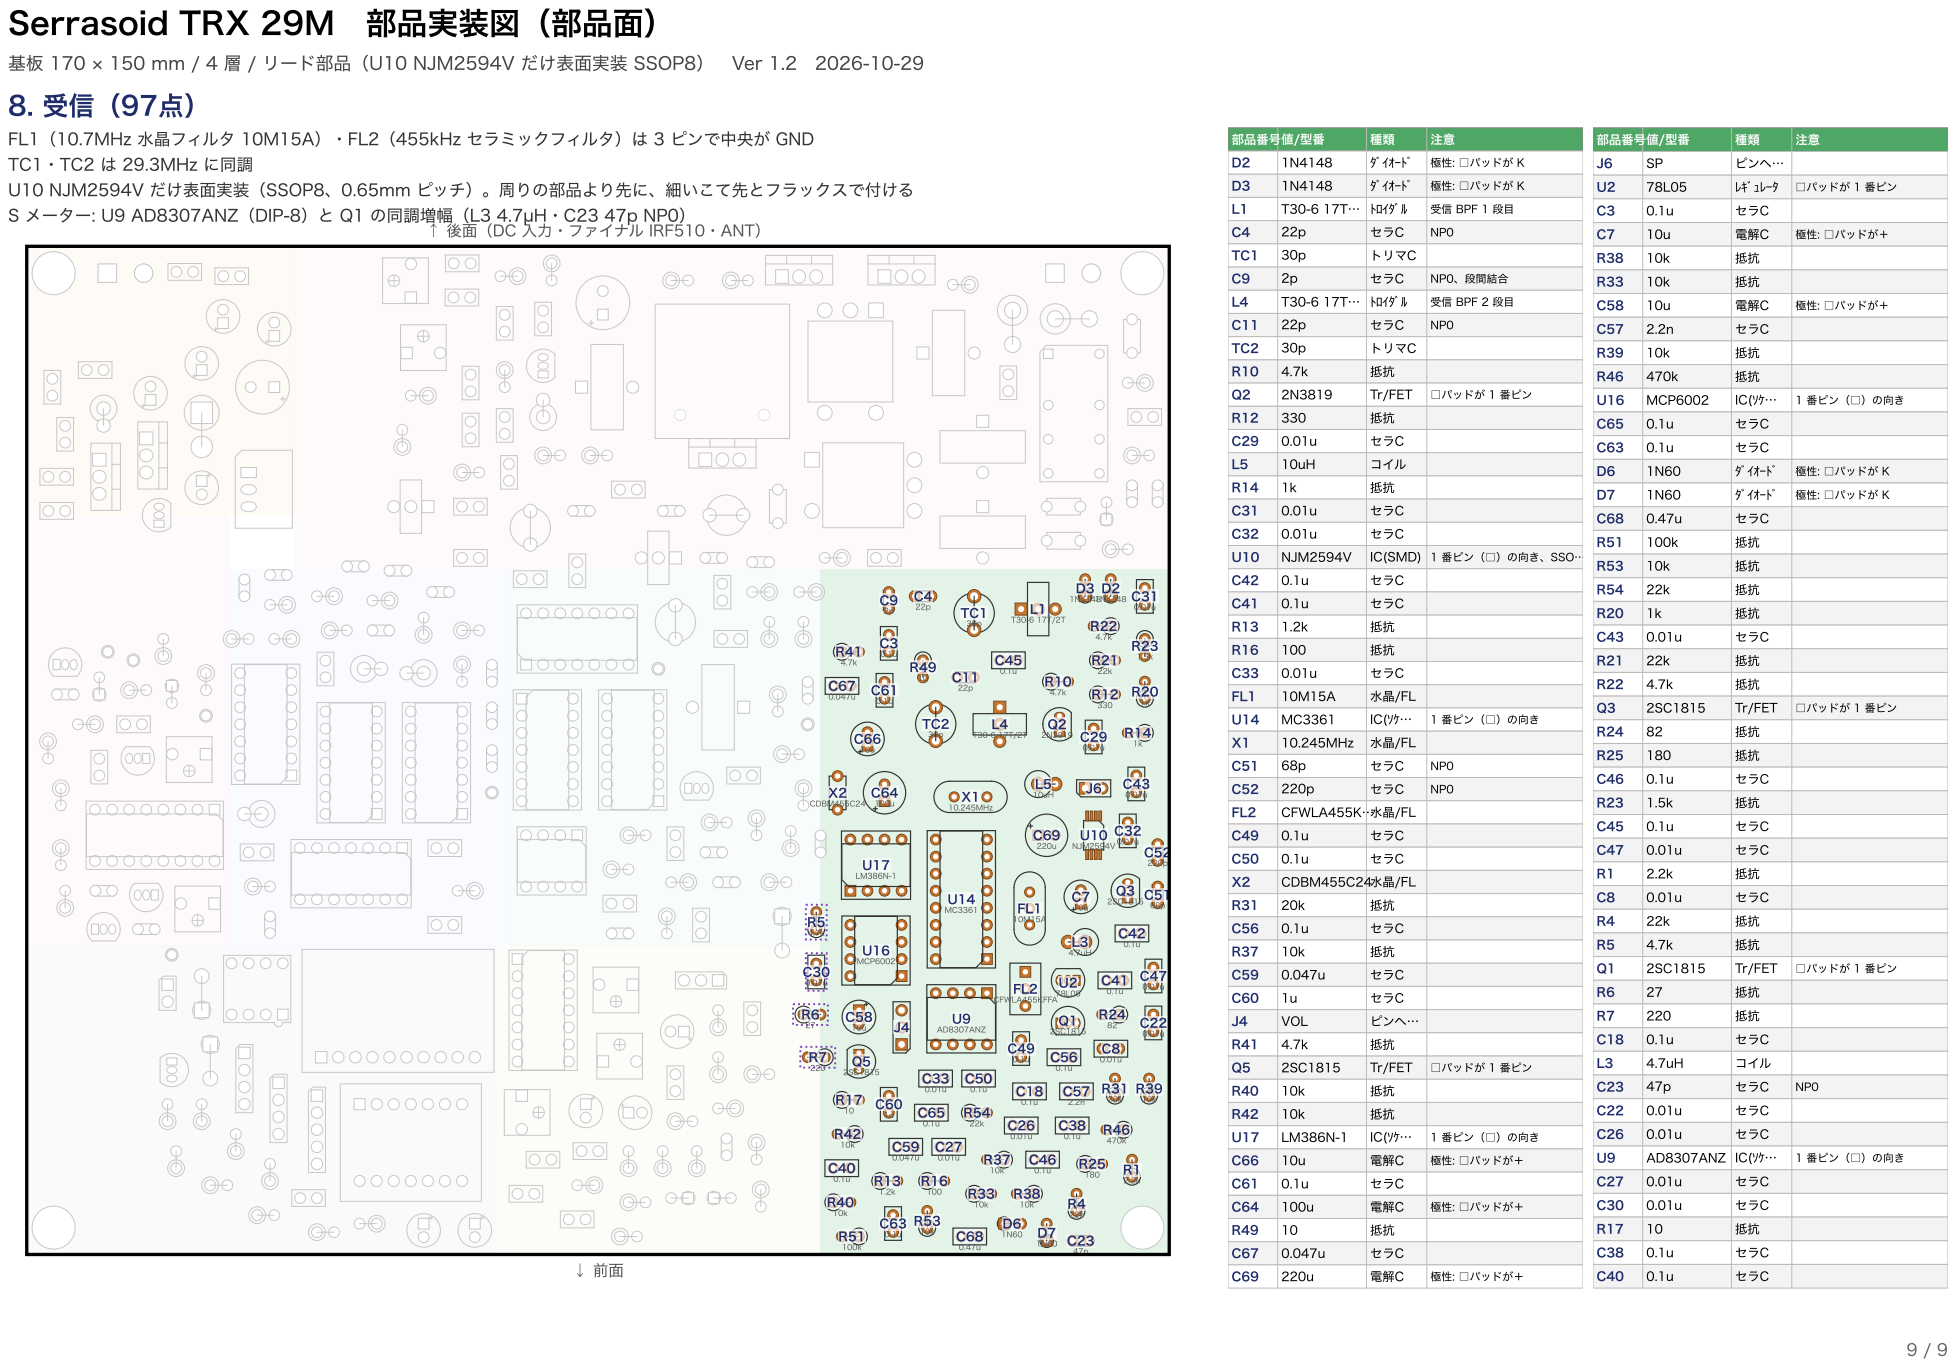
[picture p35: page 9]

FL1（10.7MHz 水晶フィルタ 10M15A）・FL2（455kHz セラミックフィルタ）は 3 ピンで中央が GND
TC1・TC2 は 29.3MHz に同調
U10 NJM2594V だけ表面実装（SSOP8、0.65mm ピッチ）。周りの部品より先に、細いこて先とフラックスで付ける
S メーター: U9 AD8307ANZ（DIP-8）と Q1 の同調増幅（L3 4.7µH・C23 47p NP0）
