kazushinjo/Serrasoid_TRX_29M/kicad/Serrasoid_TRX_部品配置図.pdf

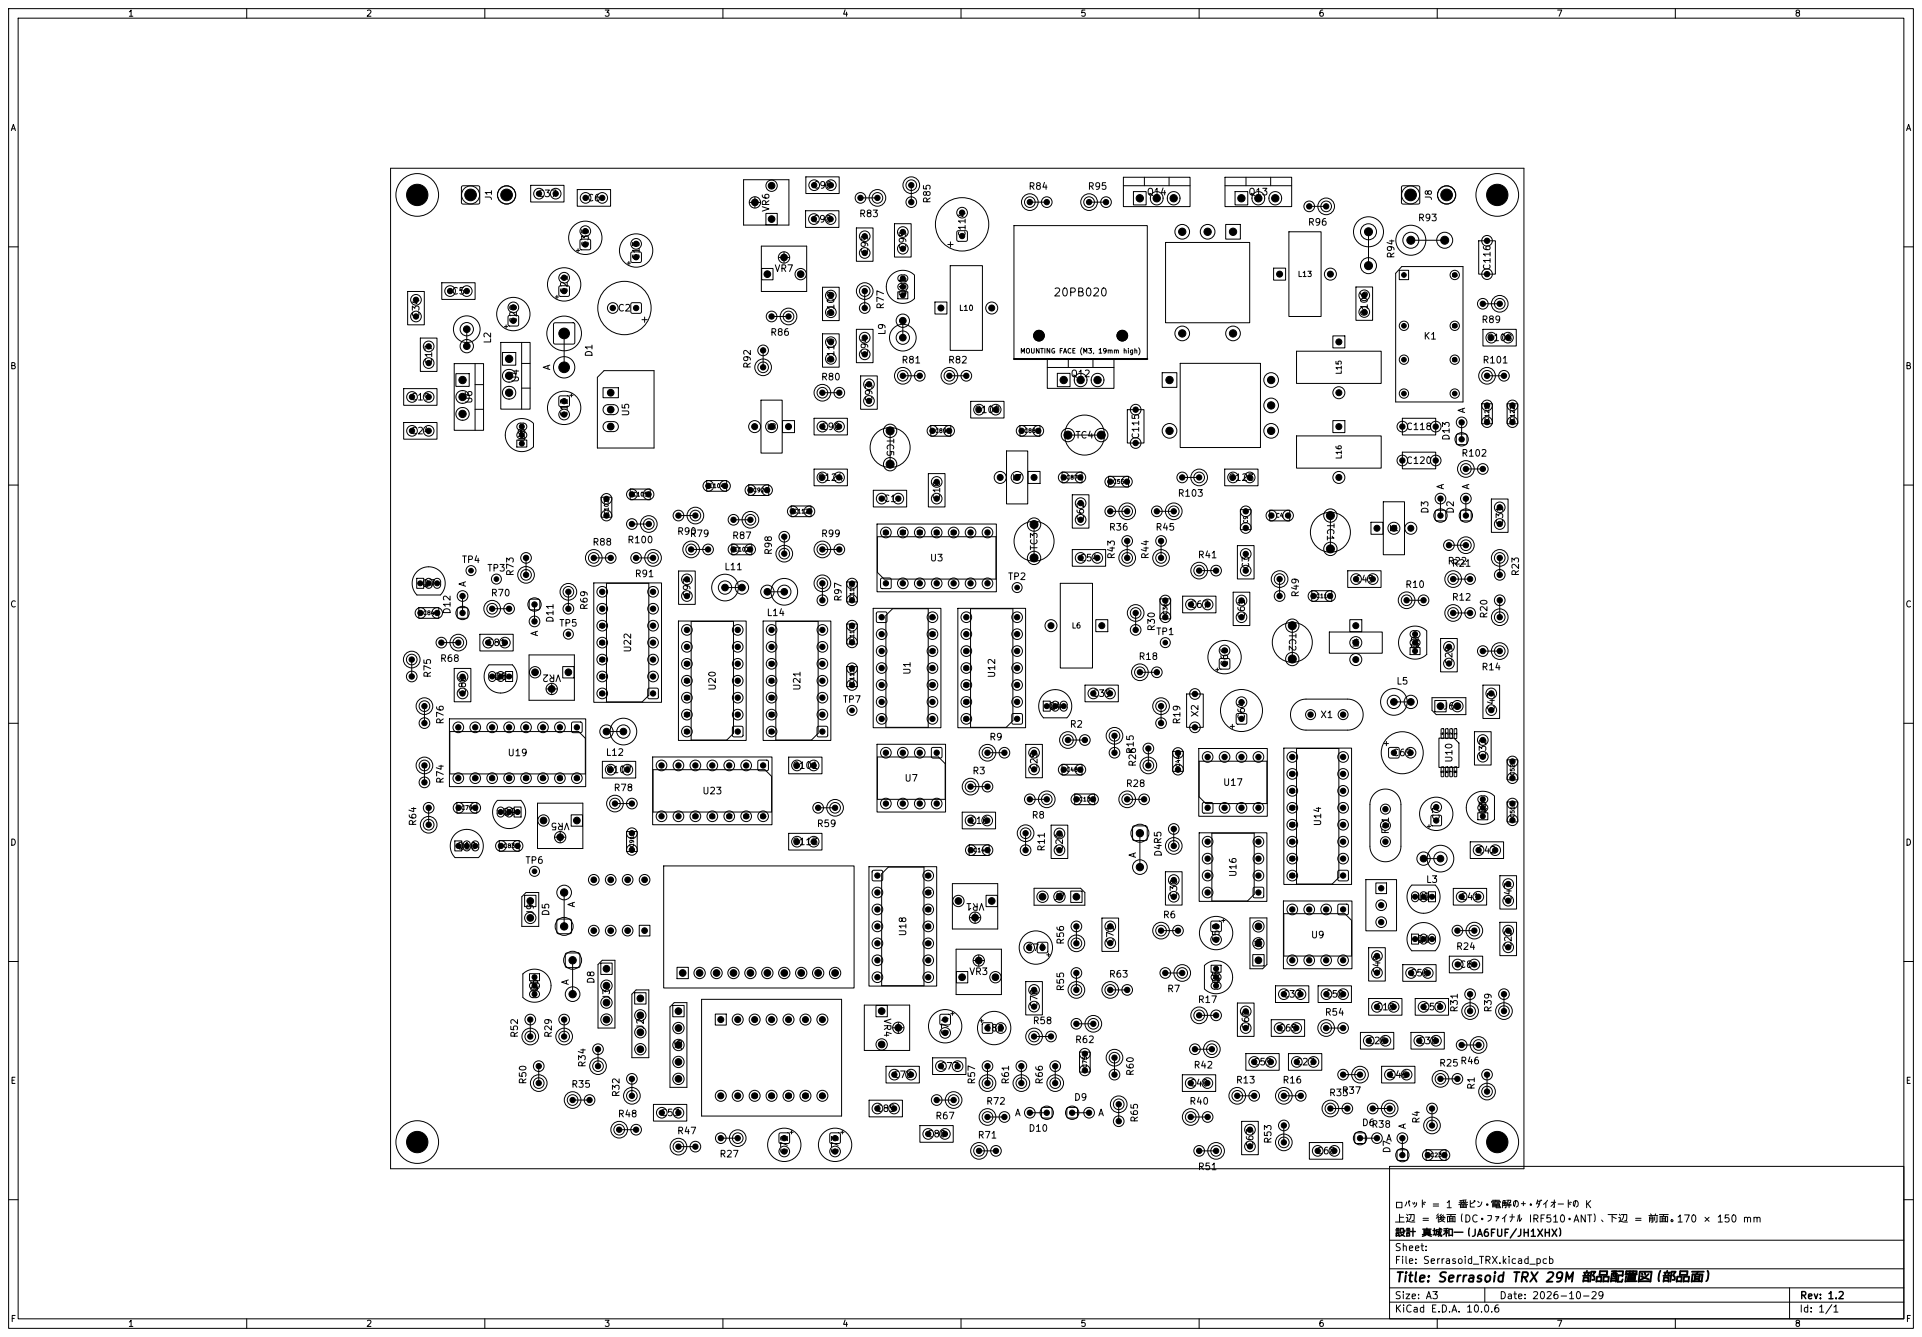
[picture p36: page 1]

□パッド = 1 番ピン・電解の＋・ダイオードの K
上辺 = 後面（DC・ファイナル IRF510・ANT）、下辺 = 前面。170 × 150 mm
設計 真城和一（JA6FUF/JH1XHX）
Sheet:
File: Serrasoid_TRX.kicad_pcb
Title: Serrasoid TRX 29M 部品配置図（部品面）

Size: A3 | Rev: 1.2
KiCad E.D.A. 10.0.6 | Id: 1/1
