kazushinjo/Serrasoid_TRX_29M/kicad/Serrasoid_TRX_回路図.pdf

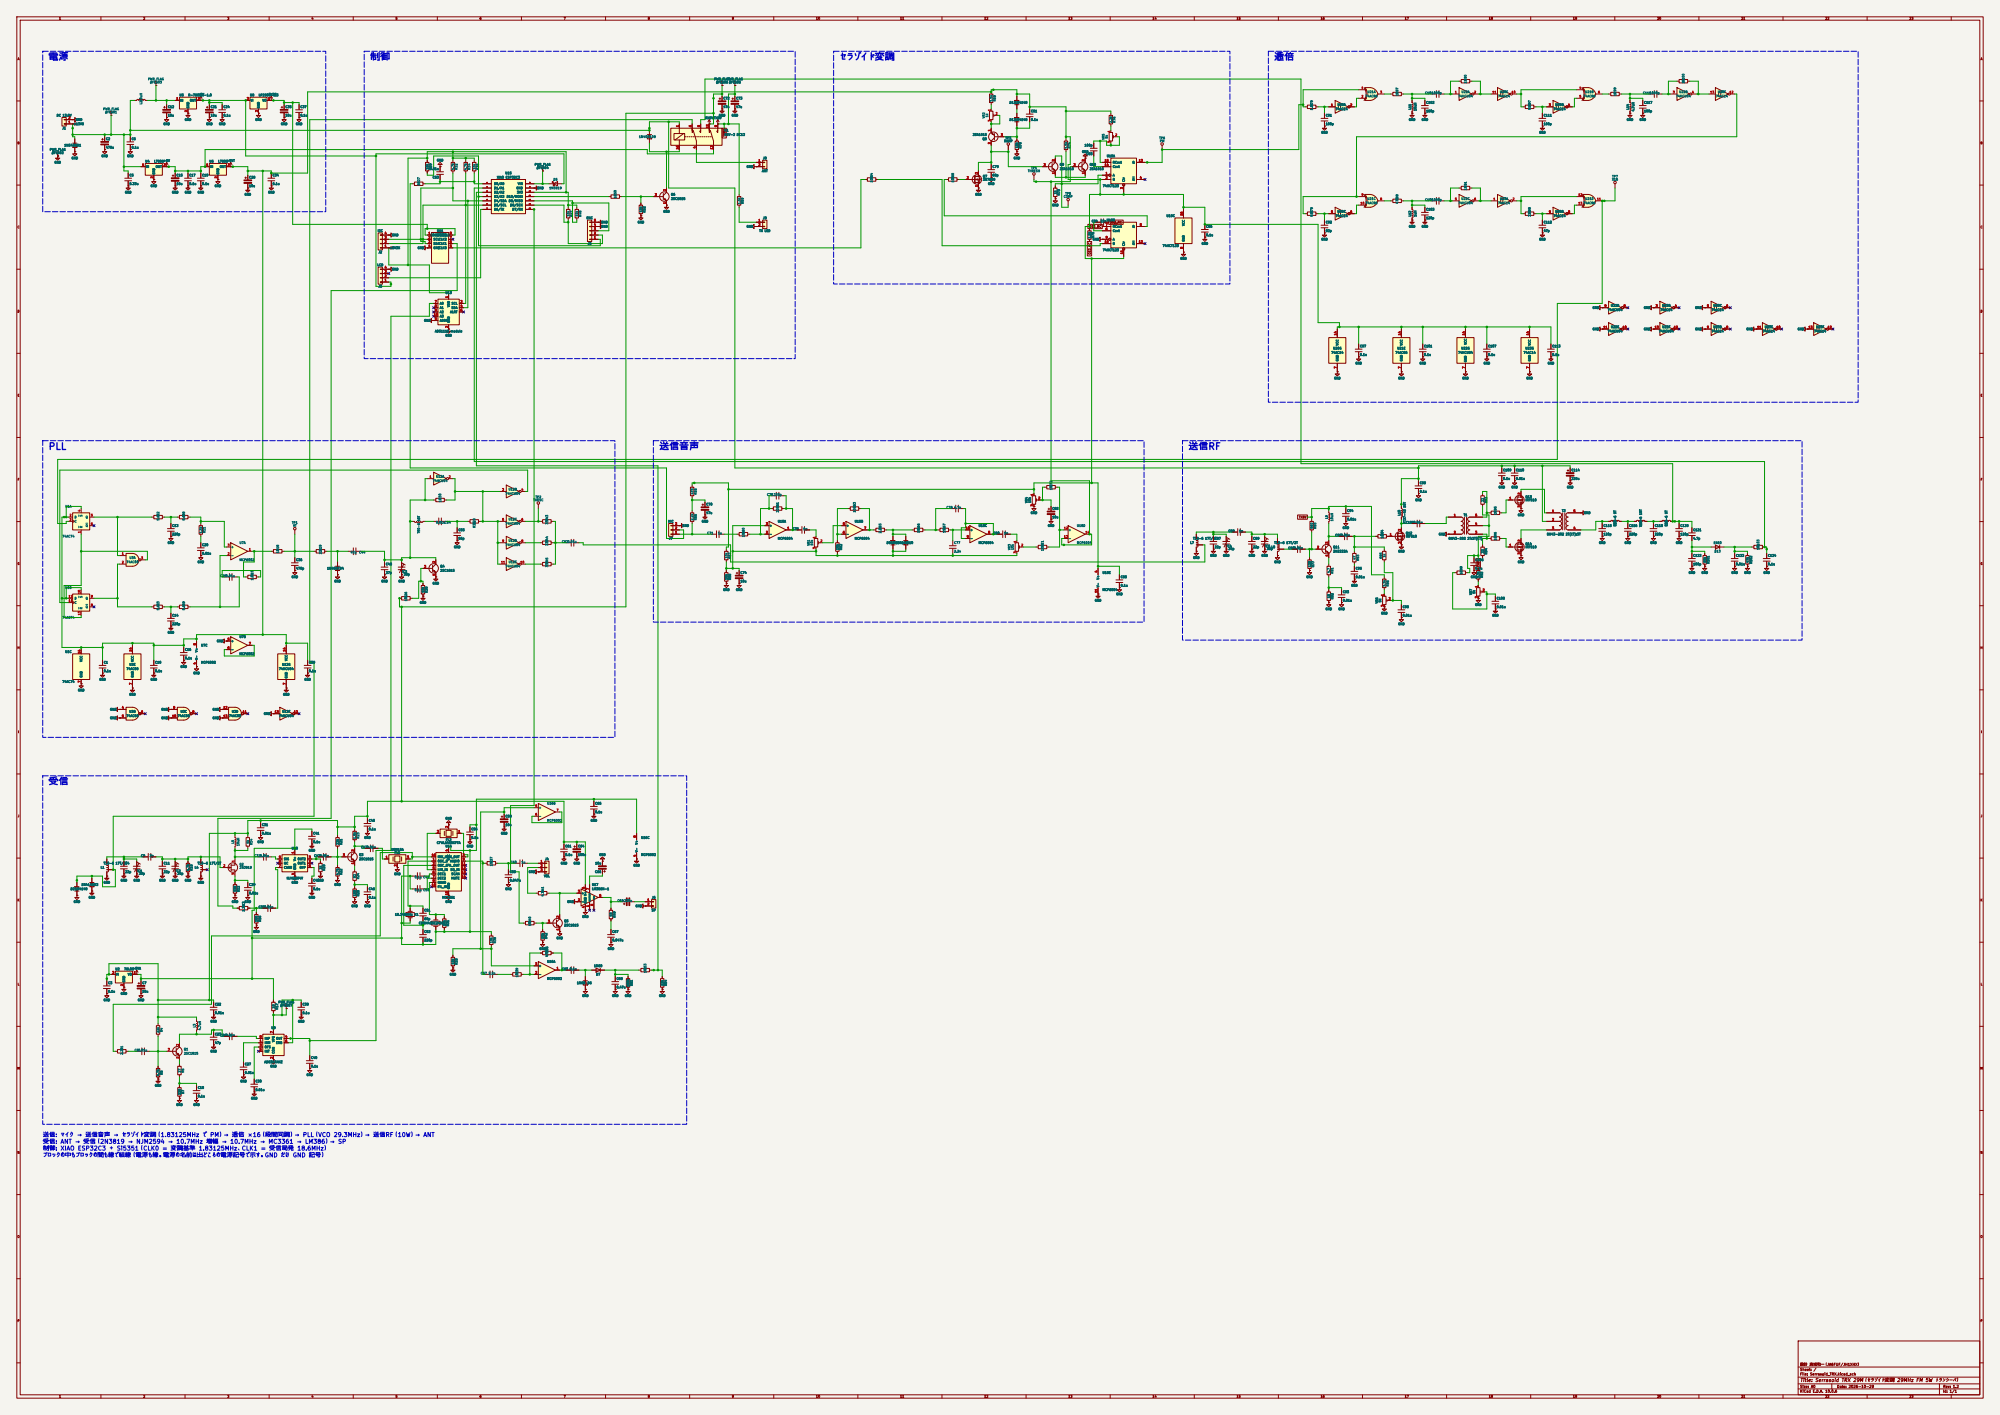
[picture p37: page 1]

送信: マイク → 送信音声 → セラゾイド変調（1.83125MHz で PM）→ 逓倍 ×16（段間同調）→ PLL（VCO 29.3MHz）→ 送信RF（10W）→ ANT
受信: ANT → 受信（2N3819 → NJM2594 → 10.7MHz 増幅 → 10.7MHz → MC3361 → LM386）→ SP
制御: XIAO ESP32C3 ＋ Si5351（CLK0 = 変調基準 1.83125MHz、CLK1 = 受信局発 18.6MHz）
ブロックの中もブロックの間も線で結線（電源も線。電源の名前は出どころの電源記号で示す。GND だけ GND 記号）

設計 真城和一（JA6FUF/JH1XHX）
Sheet: /
File: Serrasoid_TRX.kicad_sch
Title: Serrasoid TRX 29M（セラゾイド変調 29MHz FM 5W トランシーバ）

Size: A0 | Rev: 1.2
KiCad E.D.A. 10.0.6 | Id: 1/1
