kazushinjo/Serrasoid_TRX_29M/kicad/Serrasoid_TRX.kicad_pcb

## KiCad design kicad/Serrasoid_TRX.kicad_pcb (2026-10-28)

Schematic: Serrasoid_TRX.kicad_sch, Serrasoid TRX 29M（セラゾイド変調 29MHz FM 5W トランシーバ）

Parts:
C1, C3, C6, C10, C16, C17, C18, C19, C24, C34, C37, C38, C39, C40, C41, C42, C45, C46, C49, C50, C56, C61, C63, C65, C81, C85, C86, C97, C99, C101, C106, C107, C109, C113, C124: 0.1u; C_Disc_D5.0mm_W2.5mm_P2.50mm
C2: 470u; CP_Radial_D8.0mm_P3.50mm
C4, C11, C84, C87, C89: 22p; C_Disc_D3.0mm_W1.6mm_P2.50mm
C5: 0.33u; C_Disc_D5.0mm_W2.5mm_P2.50mm
C7, C12, C15, C21, C28, C35, C58, C66, C74, C82: 10u; CP_Radial_D5.0mm_P2.00mm
C8, C20, C22, C25, C26, C27, C29, C30, C31, C32, C33, C43, C47, C53, C54, C62, C90, C93, C94, C95, C96, C98, C100, C108, C110, C123: 0.01u; C_Disc_D5.0mm_W2.5mm_P2.50mm
C9: 2p; C_Disc_D3.0mm_W1.6mm_P2.50mm
C13, C14, C52, C75: 220p; C_Disc_D3.0mm_W1.6mm_P2.50mm
C23, C44, C112: 47p; C_Disc_D3.0mm_W1.6mm_P2.50mm
C36: 470p; C_Disc_D3.0mm_W1.6mm_P2.50mm
C48: 27p; C_Disc_D3.0mm_W1.6mm_P2.50mm
C51, C79: 68p; C_Disc_D3.0mm_W1.6mm_P2.50mm
C55: 56p; C_Disc_D3.0mm_W1.6mm_P2.50mm
C57, C77: 2.2n; C_Disc_D5.0mm_W2.5mm_P2.50mm
C59, C67: 0.047u; C_Disc_D5.0mm_W2.5mm_P2.50mm
C60, C71, C76, C80: 1u; C_Disc_D5.0mm_W2.5mm_P2.50mm
C64: 100u; CP_Radial_D6.3mm_P2.50mm
C68: 0.47u; C_Disc_D5.0mm_W2.5mm_P2.50mm
C69: 220u; CP_Radial_D6.3mm_P2.50mm
C70, C72, C73: 47u; CP_Radial_D5.0mm_P2.00mm
C78: 4.7n; C_Disc_D5.0mm_W2.5mm_P2.50mm
C83, C91, C111, C117, C122: 100p; C_Disc_D3.0mm_W1.6mm_P2.50mm
C88: 1p; C_Disc_D3.0mm_W1.6mm_P2.50mm
C92: 82p; C_Disc_D3.0mm_W1.6mm_P2.50mm
C102: 180p; C_Disc_D3.0mm_W1.6mm_P2.50mm
C103: 120p; C_Disc_D3.0mm_W1.6mm_P2.50mm
C104, C105, C119: 1000p; C_Disc_D3.0mm_W1.6mm_P2.50mm
C114: 220u; CP_Radial_D8.0mm_P3.50mm
C115, C120: 120p; C_Disc_D5.0mm_W2.5mm_P5.00mm
C116, C118: 220p; C_Disc_D5.0mm_W2.5mm_P5.00mm
C121: 4.7p; C_Disc_D3.0mm_W1.6mm_P2.50mm
D1: 1N5408; D_DO-201AD_P5.08mm_Vertical_AnodeUp
D2, D3, D9, D10, D11, D12: 1N4148; D_DO-35_SOD27_P2.54mm_Vertical_AnodeUp
D4: 1N4007; D_DO-41_SOD81_P5.08mm_Vertical_AnodeUp
D5: 1N5819; D_DO-41_SOD81_P5.08mm_Vertical_AnodeUp
D6, D7, D13: 1N60; D_DO-35_SOD27_P2.54mm_Vertical_AnodeUp
D8: 1N4001; D_DO-41_SOD81_P5.08mm_Vertical_AnodeUp
FL1: 10M15A; Crystal_HC49-U-3Pin_Vertical
FL2: CFWLA455KFFA; Filter_Ceramic_3pin_P2.54mm
J1: DC 13.8V; SolderWire-1sqmm_1x02_P5.4mm_D1.4mm_OD2.7mm
J2: I2C; PinHeader_1x04_P2.54mm_Vertical
J3: LCD; PinHeader_1x04_P2.54mm_Vertical
J4: VOL; PinHeader_1x03_P2.54mm_Vertical
J5: ENC; PinHeader_1x05_P2.54mm_Vertical
J6: SP; PinHeader_1x02_P2.54mm_Vertical
J7: MIC; PinHeader_1x03_P2.54mm_Vertical
J8: ANT; SolderWire-1sqmm_1x02_P5.4mm_D1.4mm_OD2.7mm
J9: TX LED; PinHeader_1x02_P2.54mm_Vertical
K1: G5V-2 DC12; Relay_DPDT_Omron_G5V-2
L1, L4, L7, L8: T30-6 17T/2T; L_T30_3pin_Vertical
L2, L5, L9, L11: 10uH; L_Axial_L9.5mm_D4.0mm_P2.54mm_Vertical_Fastron_SMCC
L3, L14: 4.7uH; L_Axial_L9.5mm_D4.0mm_P2.54mm_Vertical_Fastron_SMCC
L6: T50-6 15T; L_T50_2pin_Vertical
L10: FT37-43 10T; L_T50_2pin_Vertical
L12: 1uH; L_Axial_L9.5mm_D4.0mm_P2.54mm_Vertical_Fastron_SMCC
L13, L16: T50-6 9T; L_T50_2pin_Vertical
L15: T50-6 10T; L_T50_2pin_Vertical
Q1, Q3, Q4, Q5, Q6: 2SC1815; TO-92_Inline
Q2: 2N3819; TO-92_Inline
Q7: 2N7000; TO-92_Inline
Q8, Q9, Q10: 2SA1015; TO-92_Inline
Q11: 2N2222A; TO-92_Inline
Q12, Q13, Q14: IRF510; TO-220-3_Vertical
R1, R56, R65, R76: 2.2k; R_Axial_DIN0207_L6.3mm_D2.5mm_P2.54mm_Vertical
R2, R3, R8, R9: 5.6k; R_Axial_DIN0207_L6.3mm_D2.5mm_P2.54mm_Vertical
R4, R19, R21, R54: 22k; R_Axial_DIN0207_L6.3mm_D2.5mm_P2.54mm_Vertical
R5, R10, R22, R32, R34, R41: 4.7k; R_Axial_DIN0207_L6.3mm_D2.5mm_P2.54mm_Vertical
R6: 27; R_Axial_DIN0207_L6.3mm_D2.5mm_P2.54mm_Vertical
R7, R36: 220; R_Axial_DIN0207_L6.3mm_D2.5mm_P2.54mm_Vertical
R11, R15, R23, R59, R69, R74, R75: 1.5k; R_Axial_DIN0207_L6.3mm_D2.5mm_P2.54mm_Vertical
R12, R43, R44, R45, R98: 330; R_Axial_DIN0207_L6.3mm_D2.5mm_P2.54mm_Vertical
R13: 1.2k; R_Axial_DIN0207_L6.3mm_D2.5mm_P2.54mm_Vertical
R14, R18, R20, R27, R50, R73, R85, R87, R89, R99: 1k; R_Axial_DIN0207_L6.3mm_D2.5mm_P2.54mm_Vertical
R16, R64, R68: 100; R_Axial_DIN0207_L6.3mm_D2.5mm_P2.54mm_Vertical
R17, R49, R84, R95, R96: 10; R_Axial_DIN0207_L6.3mm_D2.5mm_P2.54mm_Vertical
R24: 82; R_Axial_DIN0207_L6.3mm_D2.5mm_P2.54mm_Vertical
R25: 180; R_Axial_DIN0207_L6.3mm_D2.5mm_P2.54mm_Vertical
R26, R28, R29, R33, R35, R37, R38, R39, R40, R42, R47, R48, R52, R53, R57, R58, R60, R62, R70, R72, R101, R103: 10k; R_Axial_DIN0207_L6.3mm_D2.5mm_P2.54mm_Vertical
R30, R90, R91, R100: 1M; R_Axial_DIN0207_L6.3mm_D2.5mm_P2.54mm_Vertical
R31: 20k; R_Axial_DIN0207_L6.3mm_D2.5mm_P2.54mm_Vertical
R46: 470k; R_Axial_DIN0207_L6.3mm_D2.5mm_P2.54mm_Vertical
R51, R63, R71: 100k; R_Axial_DIN0207_L6.3mm_D2.5mm_P2.54mm_Vertical
R55, R88: 470; R_Axial_DIN0207_L6.3mm_D2.5mm_P2.54mm_Vertical
R61: 220k; R_Axial_DIN0207_L6.3mm_D2.5mm_P2.54mm_Vertical
R66, R67: 15k; R_Axial_DIN0207_L6.3mm_D2.5mm_P2.54mm_Vertical
R77: 120; R_Axial_DIN0207_L6.3mm_D2.5mm_P2.54mm_Vertical
R78: 1.8k; R_Axial_DIN0207_L6.3mm_D2.5mm_P2.54mm_Vertical
R79: 510; R_Axial_DIN0207_L6.3mm_D2.5mm_P2.54mm_Vertical
R80: 560; R_Axial_DIN0207_L6.3mm_D2.5mm_P2.54mm_Vertical
R81: 4.7; R_Axial_DIN0207_L6.3mm_D2.5mm_P2.54mm_Vertical
R82: 18; R_Axial_DIN0207_L6.3mm_D2.5mm_P2.54mm_Vertical
R83: 47; R_Axial_DIN0207_L6.3mm_D2.5mm_P2.54mm_Vertical
R86, R92: 3.3k; R_Axial_DIN0207_L6.3mm_D2.5mm_P2.54mm_Vertical
R93, R94: 22; R_Axial_DIN0414_L11.9mm_D4.5mm_P5.08mm_Vertical
R97: 910; R_Axial_DIN0207_L6.3mm_D2.5mm_P2.54mm_Vertical
R102: 47k; R_Axial_DIN0207_L6.3mm_D2.5mm_P2.54mm_Vertical
T1: BN43-202 2T:2T(CT); Transformer_BN43-202_SS
T2: BN43-202 2T(CT):3T; Transformer_BN43-202_SP
TC1, TC2, TC3, TC4, TC5: 30p; C_Trimmer_TMCV01
TP1: VT; TestPoint_THTPad_D1.5mm_Drill0.7mm
TP2: TXOSC; TestPoint_THTPad_D1.5mm_Drill0.7mm
TP3: RAMP; TestPoint_THTPad_D1.5mm_Drill0.7mm
TP4: THRESH; TestPoint_THTPad_D1.5mm_Drill0.7mm
TP5: COMP; TestPoint_THTPad_D1.5mm_Drill0.7mm
TP6: PM; TestPoint_THTPad_D1.5mm_Drill0.7mm
TP7: X16; TestPoint_THTPad_D1.5mm_Drill0.7mm
U1: 74AC74; DIP-14_W7.62mm_Socket
U2: 78L05; TO-92_Inline
U3: 74AC00; DIP-14_W7.62mm_Socket
U4: L7808; TO-220-3_Vertical
U5: R-78E5.0-1.0; Converter_DCDC_RECOM_R-78E-0.5_THT
U6: L7805; TO-220-3_Vertical
U7, U16: MCP6002; DIP-8_W7.62mm_Socket
U8: LP2950-3.3; TO-92_Inline
U9: AD8307ANZ; DIP-8_W7.62mm_Socket
U10: NJM2594V; TSSOP-8_4.4x3mm_P0.65mm
U11: AE-Si5351A; DIP-8_W7.62mm
U12, U22: 74HCU04; DIP-14_W7.62mm_Socket
U13: ADS1115 module; ADS1115_Module_Socket
U14: MC3361; DIP-16_W7.62mm_Socket
U15: XIAO ESP32C3; Seeeduino_XIAO_Socket
U17: LM386N-1; DIP-8_W7.62mm_Socket
U18: MCP6004; DIP-14_W7.62mm_Socket
U19: 74HCT123; DIP-16_W7.62mm_Socket
U20, U23: 74AC14; DIP-14_W7.62mm_Socket
U21: 74AC86; DIP-14_W7.62mm_Socket
VR1, VR3, VR4: 10k; Potentiometer_TOCOS_GF063P_Vertical
VR2: 1k; Potentiometer_TOCOS_GF063P_Vertical
VR5, VR6, VR7: 5k; Potentiometer_TOCOS_GF063P_Vertical
X1: 10.245MHz; Crystal_HC49-U_Vertical
X2: CDBM455C24; C_Disc_D5.0mm_W2.5mm_P5.00mm

Connections:
+3V3S: C35.1, C37.1, U8.1 (VO), U11.1 (VDDO), U11.8 (VDD)
+3V3X: J2.1, R29.1, R32.1, R34.1, R35.1, R47.1, R48.1, U13.1 (VDD), U15.10 (3V3)
+5V: C21.1, C24.1, D5.2 (A), J3.1, U5.3 (OUT), U8.3 (VI)
+5VA: C7.1, C41.1, C49.2, C50.2, C52.2, C56.1, C65.1, R17.1, R31.2, R38.1, U2.1 (VO), U10.1 (V+), U14.4 (VCC), U16.8 (V+), X1.2, X2.2
+5VT: C1.1, C10.1, C16.1, C28.1, C34.1, C39.1, C81.1, C85.1, C86.1, C97.1, C101.1, C107.1, C113.1, D11.2 (A), R55.1, R57.1, R69.1, R74.1, R75.1, R76.1, U1.2 (D), U1.4 (~S), U1.10 (~S), U1.12 (D), U1.14 (VCC), U3.14 (VCC), U6.3 (OUT), U7.8 (V+), U12.14 (VCC), U18.4 (V+), U19.2 (B), U19.3 (Clr), U19.11 (Clr), U19.16 (VCC), U20.14 (VCC), U21.14 (VCC), U22.14 (VCC), U23.14 (VCC), VR4.1
+8V: C15.1, C17.1, C19.1, K1.13, U4.3 (OUT), U6.1 (IN)
+13V8: C2.1, C5.1, C6.1, C99.1, C109.1, C110.1, C114.1, D1.1 (K), D8.1 (K), J1.1, K1.1, L2.1, L10.1, T2.2 (PM), U4.1 (IN)
GND: C1.2, C2.2, C3.2, C4.2, C5.2, C6.2, C7.2, C10.2, C11.2, C12.2, C13.2, C14.2, C15.2, C16.2, C17.2, C18.2, C19.2, C20.2, C21.2, C22.2, C23.2, C24.2, C27.2, C28.2, C29.2, C30.2, C31.2, C34.2, C35.2, C36.2, C37.2, C38.2, C39.2, C40.2, C41.2, C42.2, C45.2, C46.2, C48.2, C53.2, C55.2, C56.2, C58.2, C59.2, C61.2, C64.2, C65.2, C66.2, C67.2, C68.2, C70.2, C72.2, C73.2, C74.2, C79.2, C82.2, C85.2, C86.2, C87.2, C89.2, C91.2, C92.2, C93.2, C94.2, C96.2, C97.2, C98.2, C99.2, C101.2, C102.2, C103.2, C106.2, C107.2, C108.2, C109.2, C110.2, C111.2, C112.2, C113.2, C114.2, C115.2, C116.2, C117.2, C118.2, C120.2, C122.2, C123.2, C124.2, D1.2 (A), D2.1 (K), D3.2 (A), D4.2 (A), D6.2 (A), FL1.2 (GND), FL2.2 (GND), J1.2, J2.4, J3.4, J4.3, J5.4, J5.5, J6.2, J7.3, J8.2, J9.2, L1.3, L4.3, L7.3, L8.3, L11.2, L12.2, L14.2, Q4.1 (E), Q5.1 (E), Q6.1 (E), Q7.1 (S), Q10.2 (C), Q12.3 (S), Q13.3 (S), Q14.3 (S), R5.2, R7.2, R10.2, R12.2, R16.2, R20.2, R22.2, R25.2, R28.2, R33.2, R42.2, R51.2, R52.2, R54.2, R58.2, R70.2, R73.2, R77.2, R82.2, R101.2, R102.2, T1.2 (AB), T2.5 (S2), TC1.2, TC2.2, TC3.2, TC4.2, TC5.2, U1.7 (GND), U2.2 (GND), U3.4, U3.5, U3.7 (GND), U3.9, U3.10, U3.12, U3.13, U4.2 (GND), U5.2 (GND), U6.2 (GND), U7.4 (V-), U7.5 (+), U8.2 (GND), U9.2 (COM), U10.4 (GND), U11.4 (GND), U12.7 (GND), U12.13, U13.2 (GND), U13.5 (ADDR), U14.15 (GND), U15.9 (GND), U16.4 (V-), U17.2 (-), U17.4 (GND), U18.11 (V-), U19.8 (GND), U19.9 (A), U20.7 (GND), U21.7 (GND), U22.7 (GND), U22.9, U22.11, U22.13, U23.3, U23.5, U23.7 (GND), U23.9, U23.11, U23.13, VR4.3, VR6.3, VR7.3; also elsewhere on the board
unnamed: C4.1, C9.1, L1.1, TC1.1
unnamed: C8.1, R1.2
unnamed: C13.1, R2.2, R8.1
unnamed: C14.1, R3.2, R9.1
unnamed: C18.1, R6.2, R7.1
unnamed: C20.1, R11.2
unnamed: C25.1, R15.2
unnamed: C33.1, R13.2, R16.1
unnamed: C36.1, R18.2, R19.1, TP1.1
unnamed: C46.1, R24.2, R25.1
unnamed: C54.1, C55.1, R36.2
unnamed: C54.2, L6.1
unnamed: C57.2, R39.1
unnamed: C59.1, C60.1, R37.2
unnamed: C62.1, R43.2, R44.2, R45.2
unnamed: C63.1, R46.2, U16.1
unnamed: C67.1, R49.2
unnamed: C69.1, R49.1, U17.5
unnamed: C70.1, R55.2, R56.1
unnamed: C71.2, R60.1
unnamed: C75.2, C76.1, R61.2, U18.1
unnamed: C76.2, VR1.1
unnamed: C78.1, R66.2, R67.1
unnamed: C80.2, VR3.1
unnamed: C82.1, R72.1, VR4.2
unnamed: C87.1, C88.1, L7.1, TC4.1
unnamed: C88.2, C89.1, L8.1, TC5.1
unnamed: C91.1, R78.2, U20.1
unnamed: C92.1, R79.2, U20.5
unnamed: C93.1, R81.2, R82.1
unnamed: C95.2, R83.1, R84.1, R85.2
unnamed: C96.1, R83.2
unnamed: C98.1, R85.1, VR6.2
unnamed: C102.1, C104.1, L11.1, R87.2
unnamed: C103.1, C105.1, L12.1, R88.2
unnamed: C104.2, R90.1, U22.1
unnamed: C105.2, R91.1, U22.5
unnamed: C108.1, R89.1, VR7.2
unnamed: C111.1, R97.2, U20.3
unnamed: C112.1, R98.2, U20.9
unnamed: C116.1, L13.2, L15.1
unnamed: C117.1, C119.1, L14.1, R99.2
unnamed: C118.1, L15.2, L16.1
unnamed: C119.2, R100.1, U22.3
unnamed: C120.1, C121.1, K1.8, L16.2
unnamed: D2.2 (A), D3.1 (K), K1.6, L1.2 (TAP)
unnamed: C44.2, D4.1 (K), R19.2
unnamed: D5.1 (K), U15.8 (VIN)
unnamed: C63.2, D6.1 (K), D7.2 (A)
unnamed: C68.1, D7.1 (K), R51.1, R53.1
unnamed: D8.2 (A), K1.16, Q6.2 (C)
unnamed: C74.1, C77.2, D9.1 (K), D10.2 (A), R57.2, R58.1, R62.2, U18.3 (+), VR1.3, VR3.3
unnamed: D9.2 (A), D10.1 (K), R65.2, R66.1
unnamed: D11.1 (K), D12.2 (A)
unnamed: C81.2, D12.1 (K), Q8.3 (B), R70.1
unnamed: C121.2, C122.1, D13.2 (A), R101.1
unnamed: C123.1, D13.1 (K), R102.1, R103.1
unnamed: C47.2, FL1.1 (IN)
unnamed: FL1.3 (OUT), R1.1, U14.16 (MIX_IN)
unnamed: FL2.1 (IN), U14.3 (MIX_OUT)
unnamed: FL2.3 (OUT), U14.5 (LIM_IN)
unnamed: J2.2, R34.2, U11.2 (SCL), U13.3 (SCL), U15.6 (D5/SCL)
unnamed: J2.3, R32.2, U11.3 (SDA), U13.4 (SDA), U15.5 (D4/SDA)
unnamed: J3.2, U15.7 (D6/TX)
unnamed: C60.2, J4.1
unnamed: J4.2, R41.1
unnamed: J5.1, R29.2, U15.4 (D3/A3)
unnamed: J5.2, R47.2, U15.13 (D8/SCK)
unnamed: J5.3, R48.2, U15.12 (D9/MISO)
unnamed: C69.2, J6.1
unnamed: C71.1, J7.1, R56.2
unnamed: J7.2, R27.1
unnamed: J8.1, K1.4
unnamed: J9.1, R59.2
unnamed: C62.2, L7.2 (TAP)
unnamed: C90.1, L8.2 (TAP)
unnamed: C8.2, Q1.3 (B), R4.2, R5.1
unnamed: C23.1, C26.1, L3.2, Q1.2 (C)
unnamed: Q1.1 (E), R6.1
unnamed: C32.1, L5.2, Q2.1 (D), R14.2
unnamed: C9.2, C11.1, L4.1, Q2.2 (G), R10.1, TC2.1
unnamed: C29.1, Q2.3 (S), R12.1
unnamed: C43.2, Q3.3 (B), R21.2, R22.1
unnamed: C47.1, Q3.2 (C), R23.2
unnamed: Q3.1 (E), R24.1
unnamed: Q4.3 (B), R26.2, R28.1
unnamed: C44.1, C48.1, L6.2, Q4.2 (C), R30.1, TC3.1, U12.1
unnamed: Q5.3 (B), R40.2, R42.1
unnamed: Q5.2 (C), R41.2, U17.3 (+)
unnamed: Q6.3 (B), R50.2, R52.1
unnamed: C79.1, Q7.3 (D), Q8.2 (C), Q9.3 (B), TP3.1
unnamed: Q7.2 (G), R68.2
unnamed: Q8.1 (E), VR2.2, VR2.3
unnamed: Q9.2 (C), R73.1, TP5.1, U19.1 (A)
unnamed: Q10.3 (B), TP4.1, U18.13 (-), U18.14
unnamed: Q9.1 (E), Q10.1 (E), R74.2
unnamed: C90.2, Q11.2 (B), R77.1, R80.2
unnamed: C95.1, L9.2, Q11.3 (C)
unnamed: Q11.1 (E), R81.1
unnamed: C100.1, L10.2, Q12.2 (D)
unnamed: Q12.1 (G), R84.2
unnamed: Q13.2 (D), T2.1 (PR1)
unnamed: Q13.1 (G), R95.2
unnamed: Q14.2 (D), T2.3 (PR2)
unnamed: Q14.1 (G), R96.2
unnamed: R15.1, R18.1, U7.1
unnamed: R30.2, R36.1, U12.2, U12.3, U12.5, U12.9, U12.11
unnamed: R43.1, TP2.1, U12.6
unnamed: R44.1, U12.8
unnamed: R45.1, U12.10
unnamed: R63.2, R65.1, U18.7
unnamed: R69.2, VR2.1
unnamed: R71.1, VR3.2
unnamed: R76.2, VR5.1
unnamed: R79.1, U20.12, U21.9
unnamed: R86.2, VR6.1
unnamed: R87.1, U21.3
unnamed: R88.1, U21.8
unnamed: R90.2, U20.11, U22.2
unnamed: R91.2, U22.6, U23.1
unnamed: R92.2, VR7.1
unnamed: R97.1, U20.10, U21.4
unnamed: R98.1, U21.12, U23.2
unnamed: R99.1, U21.6
unnamed: R100.2, U20.13, U22.4
unnamed: C100.2, T1.1 (AA)
unnamed: R94.1, R96.1, T1.3 (SA)
unnamed: R93.1, R95.1, T1.5 (SB)
unnamed: C106.1, R89.2, R93.2, R94.2, T1.4 (SC)
unnamed: C115.1, L13.1, T2.4 (S1)
unnamed: TP7.1, U1.3 (C), U21.11
unnamed: R2.1, U1.5 (Q), U3.1
unnamed: U1.1 (~R), U1.13 (~R), U3.3
unnamed: U1.11 (C), U12.4
unnamed: R3.1, U1.9 (Q), U3.2
unnamed: C12.1, L2.2, U5.1 (IN)
unnamed: R8.2, R11.1, U7.3 (+)
unnamed: C25.2, R9.2, U7.2 (-)
unnamed: U7.6 (-), U7.7
unnamed: C38.1, R17.2, U9.6 (ENB), U9.7 (VPS)
unnamed: C27.1, U9.1 (INM)
unnamed: C26.2, U9.8 (INP)
unnamed: C30.1, U9.3 (OFS)
unnamed: C42.1, U10.6 (BYP)
unnamed: C33.2, U10.7 (CARR)
unnamed: C43.1, R20.1, U10.3 (OUT2)
unnamed: C32.2, U10.5 (SIG)
unnamed: R64.1, U11.5 (CLK0)
unnamed: R13.1, U11.6 (CLK1)
unnamed: C40.1, U9.4 (OUT), U13.7 (A0)
unnamed: C57.1, R37.1, U14.9 (AUDIO)
unnamed: C49.1, U14.6 (DEC1)
unnamed: C50.1, U14.7 (DEC2)
unnamed: C51.1, U14.1 (OSC_B), X1.1
unnamed: C51.2, C52.1, U14.2 (OSC_E)
unnamed: R31.1, U14.8 (QUAD), X2.1
unnamed: C53.1, R27.2, R35.2, U15.1 (D0/A0)
unnamed: C124.1, R103.2, U15.2 (D1/A1)
unnamed: R53.2, R54.1, U15.3 (D2/A2)
unnamed: R40.1, U15.14 (D7/RX)
unnamed: R50.1, U15.11 (D10/MOSI)
unnamed: C58.1, R33.1, R38.2, U16.3 (+), U16.5 (+)
unnamed: R39.2, R46.1, U16.2 (-)
unnamed: U16.6 (-), U16.7
unnamed: C66.1, U17.7 (BYPASS)
unnamed: C75.1, R60.2, R61.1, U18.2 (-)
unnamed: U18.5 (+), VR1.2
unnamed: R62.1, R63.1, U18.6 (-)
unnamed: C77.1, R67.2, U18.10 (+)
unnamed: C78.2, C80.1, U18.8, U18.9 (-)
unnamed: R71.2, R72.2, U18.12 (+)
unnamed: C83.1, U19.14 (Cext)
unnamed: R78.1, TP6.1, U19.13 (Q), U21.1
unnamed: C83.2, U19.15 (RCext), VR5.2, VR5.3
unnamed: R64.2, U19.10 (B)
unnamed: C84.1, U19.6 (Cext)
unnamed: R68.1, U19.5 (Q)
unnamed: U20.2, U21.2
unnamed: U20.4, U21.5
unnamed: U20.6, U21.10
unnamed: U20.8, U21.13
OS2_RC: C84.2, R75.2, U19.7 (RCext)
RX8V: C3.1, C22.1, C31.1, C45.1, C61.1, C64.1, C72.1, K1.11, L3.1, L5.1, R4.1, R14.1, R21.1, R23.1, R26.1, U2.3 (VI), U17.6 (V+)
TX8V: C73.1, C94.1, K1.9, L9.1, R59.1, R80.1, R86.1, R92.1

Notes on the sheet:
セラゾイド変調
PLL
送信音声
送信RF
送信: マイク → 送信音声 → セラゾイド変調（1.83125MHz で PM）→ 逓倍 ×16（段間同調）→ PLL（VCO 29.3MHz）→ 送信RF（10W）→ ANT 受信: ANT → 受信（2N3819 → NJM2594 → 10.7MHz 増幅 → 10.7MHz → MC3361 → LM386）→ SP 制御: XIAO ESP32C3 ＋ Si5351（CLK0 = 変調基準 1.83125MHz、CLK1 = 受信局発 18.6MHz） ブロックの中もブロックの間も線で結線（電源も線。電源の名前は出どころの電源記号で示す。GND だけ GND 記号）

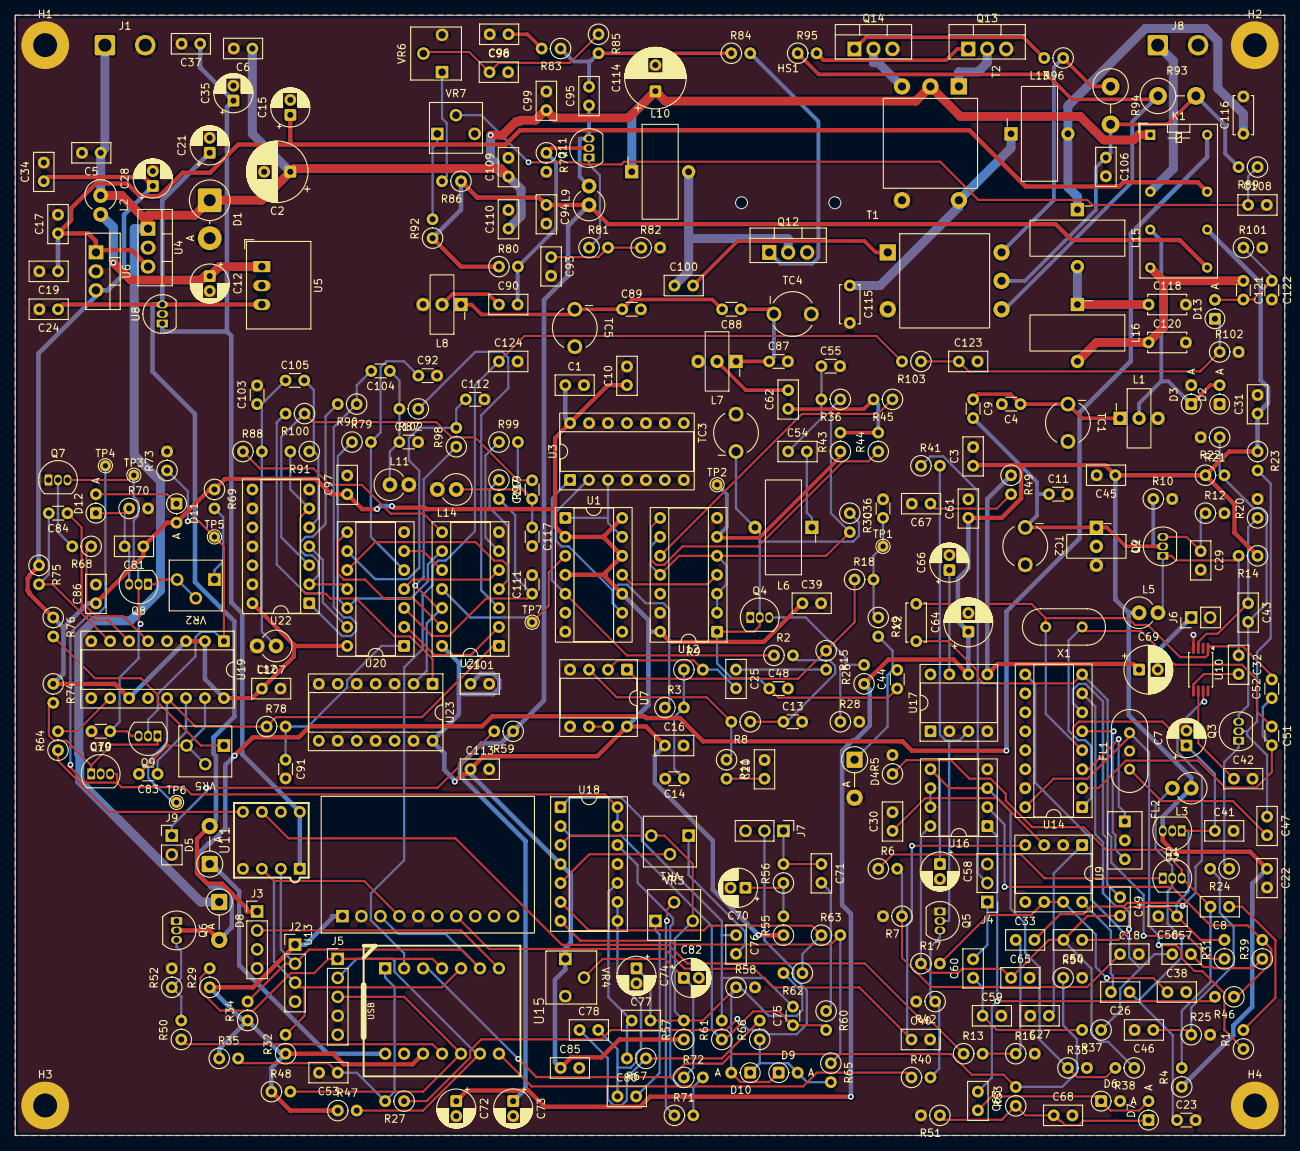
[picture p38: board Serrasoid_TRX.kicad_pcb from above]

Board: 4 copper layers, 170.0 x 150.0 mm, 333 parts (0 on the bottom side), 192 nets.

Other parts of the board:
H1, H2, H3, H4: M3; MountingHole_3.2mm_M3_Pad
HS1: 20PB020; Heatsink_20PB020

Their connections:
GND: H1.1, H2.1, H3.1, H4.1; also elsewhere on the board
