kazushinjo/Serrasoid_TRX_29M/tools/make_bom_purchase.py

"""購入先入りの部品表 kicad/bom_purchase.csv を作る（PSN_TRX の kicad/make_bom_purchase.py と同じ列）

  python3 tools/make_bom_purchase.py   （tools/gen_bom.py も BOM.md の「購入先」列に同じ情報を使う）

部品は circuit.py から読み、値・種類・注記（NP0・500V・積層）で購入する品を決める（部品番号には依らない）。
秋月電子の型番・販売コード・入数・価格は 2026-10-16 に秋月の通販サイトで確認したもの（2026-10-29 に足した部品は、その日に商品ページで確認）。
秋月以外の部品は 2026-10-29 に DigiKey などの検索結果で在庫・品番を調べた（集計サイトの値もあり、注文前に必ず確認）。
「要確認」は秋月で扱いがなく、型番・在庫を確かめていない部品（代わりの品の候補をメモに書いた）。
出力は UTF-8 BOM 付き（Excel でそのまま開ける）。
"""
import os, sys, csv, re, collections
sys.path.insert(0, os.path.dirname(os.path.abspath(__file__)))
from circuit import parts, prefix

ROOT = os.path.dirname(os.path.dirname(os.path.abspath(__file__)))
CHECKED = '2026-10-16'
AKI = '秋月電子'


def aki(model, code, unit, price, note=''): return (AKI, model, code, unit, price, note)
def other(shop, model, note=''): return (shop, model, '', '', '', note)


BENT = '足のピッチが 5mm なので寄せて 2.5mm の穴に入れる'
# 購入する品: キー（item_key の戻り値）→ (品名, (購入先, 購入先の型番, 販売コード, 入数, 価格, 購入メモ))
BUY = {
    # ---- 抵抗（1/4W カーボン、100 本入。秋月にカーボンがない値は金属皮膜）
    'R:1.2k': ('カーボン抵抗 1/4W', aki('CF25J1K2B', '125122', '100本', 170)),
    'R:1.5k': ('カーボン抵抗 1/4W', aki('CF25J1K5B', '125152', '100本', 170)),
    'R:1.8k': ('金属皮膜抵抗 1/4W', aki('MFS25F1K8B', '108538', '100本', 200, '秋月にカーボンの 1.8kΩ はない')),
    'R:10': ('カーボン抵抗 1/4W', aki('CF25J10RB', '125100', '100本', 220)),
    'R:100': ('カーボン抵抗 1/4W', aki('CF25J100RB', '125101', '100本', 200)),
    'R:22:1/2W': ('カーボン抵抗 1/2W', aki('CFS50J22RB', '107797', '100本', 160, 'ファイナルの入力スワンプ（2026-10-29 確認）')),
    'R:100:1/2W': ('カーボン抵抗 1/2W', aki('CFS50J100RB', '107803', '100本', 250, '入力スワンプ（2 本並列で 50Ω）')),
    'R:100k': ('カーボン抵抗 1/4W', aki('CF25J100KB', '125104', '100本', 200)),
    'R:10k': ('カーボン抵抗 1/4W', aki('RD25S 10K', '125103', '100本', 100)),
    'R:120': ('カーボン抵抗 1/4W', aki('CF25J120RB', '125121', '100本', 220)),
    'R:15k': ('金属皮膜抵抗 1/4W', aki('MFS25F15KB', '108552', '100本', 300, '秋月にカーボンの 15kΩ はない')),
    'R:1k': ('カーボン抵抗 1/4W', aki('CF25J1KB', '125102', '100本', 100)),
    'R:2.2k': ('カーボン抵抗 1/4W', aki('CF25J2K2B', '125222', '100本', 220, '電源 LED の抵抗にも使う')),
    'R:20k': ('カーボン抵抗 1/4W', aki('CF25J20KB', '103940', '100本', 180)),
    'R:220k': ('カーボン抵抗 1/4W', aki('CF25J220KB', '125224', '100本', 180)),
    'R:22k': ('カーボン抵抗 1/4W', aki('CF25J22KB', '125223', '100本', 180)),
    'R:3.3k': ('カーボン抵抗 1/4W', aki('CF25J3K3B', '125332', '100本', 180)),
    'R:3.9k': ('カーボン抵抗 1/4W', aki('RD25S 3K9', '125392', '100本', 100)),
    'R:330': ('カーボン抵抗 1/4W', aki('CF25J330RB', '125331', '100本', 200)),
    'R:4.7': ('カーボン抵抗 1/4W', aki('CF25J4R7B', '125047', '100本', 50)),
    'R:4.7k': ('カーボン抵抗 1/4W', aki('CF25J4K7B', '125472', '100本', 170)),
    'R:47': ('カーボン抵抗 1/4W', aki('CF25J47RB', '125470', '100本', 200)),
    'R:470': ('カーボン抵抗 1/4W', aki('CF25J470RB', '125471', '100本', 200)),
    'R:470k': ('カーボン抵抗 1/4W', aki('RD25S 470K', '125474', '100本', 100)),
    'R:47k': ('カーボン抵抗 1/4W', aki('CF25J47KB', '118208', '100本', 150)),
    'R:510': ('カーボン抵抗 1/4W', aki('CF25J510RB', '125511', '100本', 200)),
    'R:560': ('カーボン抵抗 1/4W', aki('CF25J560RB', '125561', '100本', 200)),
    'R:910': ('カーボン抵抗 1/4W', aki('CF25J910RB', '114277', '100本', 100)),
    'R:82': ('カーボン抵抗 1/4W', aki('CF25J82RB', '114276', '100本', 100)),
    'R:180': ('カーボン抵抗 1/4W', aki('CF25J180RB', '125181', '100本', 100)),
    'R:1M': ('カーボン抵抗 1/4W', aki('CF25J1MB', '125105', '100本', 200, '2026-10-29 確認')),
    'R:220': ('カーボン抵抗 1/4W', aki('CF25J220RB', '125221', '100本', 200, '2026-10-29 確認')),
    'R:5.6k': ('カーボン抵抗 1/4W', aki('RD25S 5K6', '125562', '100本', 100, '2026-10-29 確認')),
    'R:27': ('カーボン抵抗 1/4W', aki('CF25J27RB', '114273', '100本', 100, '2026-10-29 確認')),
    'R:18': ('カーボン抵抗 1/4W', aki('CF25J18RB', '114272', '100本', 100, '2026-10-29 確認')),
    # ---- 半固定抵抗
    'VR:10k': ('半固定抵抗 TOCOS GF063P', aki('GF063P B103K', '114905', '1個', 30, '確認時は入荷予定')),
    'VR:1k': ('半固定抵抗 TOCOS GF063P', aki('GF063P B102K', '114901', '1個', 30, '確認時は入荷予定')),
    'VR:5k': ('半固定抵抗 TOCOS GF063P', aki('GF063P B502K', '114904', '1個', 30, '確認時は在庫僅少')),
    # ---- セラミックコンデンサ（2.5mm 穴。5mm ピッチ品は足を寄せる）
    'C:2p:NP0': ('積層セラミックコンデンサ 2pF 50V C0G', aki('RDE5C1H2R0C0K1H03B', '108044', '10個', 100, BENT)),
    'C:1p:NP0': ('積層セラミックコンデンサ 1pF 50V C0G', aki('RDE5C1H1R0C0K1H03B', '108082', '10個', 100, '送信 BPF の段間結合。' + BENT)),
    'C:27p:NP0': ('積層セラミックコンデンサ 27pF 50V C0G', aki('RDE5C1H270J0K1H03B', '108095', '10個', 100, BENT)),
    'C:56p:NP0': ('積層セラミックコンデンサ 56pF 50V C0G', aki('RDE5C1H560J0K1H03B', '108099', '10個', 100, BENT)),
    'C:120p:NP0': ('積層セラミックコンデンサ 120pF 50V C0G', aki('RDE5C1H121J0K1H03B', '108103', '10個', 100, BENT)),
    'C:180p:NP0': ('積層セラミックコンデンサ 180pF 50V C0G', aki('RDE5C1H181J0K1H03B', '108105', '10個', 100, BENT)),
    'C:470p': ('積層セラミックコンデンサ 470pF 50V C0G', aki('RDE5C1H471J0K1H03B', '108110', '10個', 130, BENT)),
    'C:1000p': ('積層セラミックコンデンサ 1000pF 50V C0G', aki('RDE5C1H102J0K1H03B', '108114', '10個', 130, BENT)),
    'C:0.01u:NP0': ('積層セラミックコンデンサ 0.01µF 50V C0G', aki('RDE5C1H103J1K1H03B', '108043', '10個', 200,
                    'PLL のループフィルタ（容量が電圧で変わらない C0G）。' + BENT)),
    'C:22p:NP0': ('積層セラミックコンデンサ 22pF 50V（CH）2.54mm', aki('RD15N220J1HL2L', '104060', '10個', 100)),
    'C:47p:NP0': ('積層セラミックコンデンサ 47pF 50V C0G', aki('RDE5C1H470J0K1H03B', '108045', '10個', 130, BENT)),
    'C:68p:NP0': ('積層セラミックコンデンサ 68pF 50V C0G 2.54mm', aki('RDE5C1H680J0P1H03B', '114323', '5個', 100)),
    'C:82p:NP0': ('積層セラミックコンデンサ 82pF 50V C0G', aki('RDE5C1H820J0K1H03B', '108101', '10個', 150, BENT)),
    'C:100p:NP0': ('積層セラミックコンデンサ 100pF 50V C0G', aki('RDE5C1H101J0K1H03B', '108063', '10個', 120,
                   '遅延・のこぎり波用は C0G を指定。' + BENT)),
    'C:100p': ('積層セラミックコンデンサ 100pF 50V 2.54mm', aki('RD15N101J1HL2L-10', '104061', '10個', 100)),
    'C:220p:NP0': ('積層セラミックコンデンサ 220pF 50V C0G', aki('RDE5C1H221J0K1H03B', '108106', '10個', 130, BENT)),
    'C:220p': ('積層セラミックコンデンサ 220pF 50V C0G', aki('RDE5C1H221J0K1H03B', '108106', '10個', 130, BENT)),
    'C:2.2n': ('積層セラミックコンデンサ 2200pF 50V X7R 2.54mm', aki('RDER71H222K0P1H03B', '112060', '1個', 15)),
    'C:4.7n': ('フィルムコンデンサ 4700pF 50V', aki('50F2D472J', '110336', '1個', 10, '音声 LPF。' + BENT)),
    'C:0.01u': ('積層セラミックコンデンサ 0.01µF 50V X7R 2.54mm', aki('RD15W103K1HL2L-10', '104063', '10個', 100)),
    'C:0.047u': ('積層セラミックコンデンサ 0.047µF 50V X7R 2.54mm', aki('RDER71H473K0P1H03B', '112059', '1個', 15, '確認時は在庫僅少')),
    'C:0.1u': ('積層セラミックコンデンサ 0.1µF 50V X7R 2.54mm', aki('RDER71H104K0P1H03B', '113582', '10個', 100)),
    'C:0.1u:積層': ('積層セラミックコンデンサ 0.1µF 100V X7R', aki('RDER72A104K1K1H03B', '115927', '10個', 120,
                    'PA の電源バイパス（約 1.6Arms）。' + BENT)),
    'C:0.33u': ('積層セラミックコンデンサ 0.33µF 50V X7R 2.54mm', aki('RD15W334K1HL2L-10', '115937', '10個', 170)),
    'C:0.47u': ('積層セラミックコンデンサ 0.47µF 50V X7R 2.54mm', aki('RD15W474K1HL2L-10', '115938', '10個', 170)),
    'C:1u': ('積層セラミックコンデンサ 1µF 50V X7R 2.54mm', aki('RD15W105K1HL2L-503', '115940', '10個', 170)),
    # 送信 LPF・出力検出（高耐圧 C0G、秋月に扱いなし）
    'C:4.7p:NP0:500V': ('セラミックコンデンサ 4.7pF 500V 以上 C0G（NP0）', other('DigiKey／Mouser（要確認）', 'C0G 500V〜1kV ディスク 4.7pF',
                        '秋月の高耐圧品は 22pF 2kV（111548）と 470pF 1kV（B 特性）だけ')),
    'C:120p:NP0:500V': ('セラミックコンデンサ 120pF 500V 以上 C0G（NP0）5mm', other('DigiKey／Mouser（要確認）', 'C0G 500V〜1kV ディスク 120pF',
                        '送信 LPF。50V 品・B 特性は使わない')),
    'C:220p:NP0:500V': ('セラミックコンデンサ 220pF 500V 以上 C0G（NP0）5mm', other('DigiKey／Mouser（要確認）', 'C0G 500V〜1kV ディスク 220pF',
                        '送信 LPF。50V 品・B 特性は使わない')),
    # ---- 電解コンデンサ（ルビコン PX）
    'C:10u': ('電解コンデンサ 10µF 50V', aki('50PX10MEFC5X11', '117897', '1個', 10)),
    'C:47u': ('電解コンデンサ 47µF 35V', aki('35PX47MEFC5X11', '117887', '1個', 10)),
    'C:100u': ('電解コンデンサ 100µF 25V', aki('25PX100MEFC5X11', '117877', '1個', 10, 'φ5（穴は φ6.3 用、2.5mm ピッチ）')),
    'C:220u': ('電解コンデンサ 220µF 25V', aki('25PX220MEFC6.3X11', '117879', '1個', 20)),
    'C:470u': ('電解コンデンサ 470µF 25V', aki('25PX470MEFC8X11.5', '117883', '1個', 20)),
    # ---- トリマ
    'TC:30p': ('セラミックトリマコンデンサ 30pF（緑）', aki('TMCV01-30P100VBG', '115472', '1個', 25)),
    # ---- コイル・トランス（トロイダルは線を別に用意して巻く）
    'L:10uH': ('マイクロインダクタ 10µH', aki('AL0510-100K', '104922', '10本', 110)),
    'L:4.7uH': ('マイクロインダクタ 4.7µH', aki('AL0410-4R7K', '104931', '10本', 80, '段間同調 2')),
    'L:1uH': ('マイクロインダクタ 1µH', aki('AL0410-1R0K', '104930', '10本', 80, '段間同調 3')),
    'L:T30-6': ('トロイダルコア T-30-6（0.4mm ポリウレタン線を巻く）', aki('T-30-6', '116458', '1個', 210, '17 回、コールド側から 2 回目でタップ')),
    'L:T50-6': ('トロイダルコア T-50-6（0.8mm ポリウレタン線を巻く）', aki('T-50-6', '111947', '1個', 410, '巻数は値のとおり（9T・10T）')),
    'L:FT37-43': ('フェライトトロイダルコア FT-37-43', aki('FT-37-43', '131660', '1個', 310, '10 回')),
    'L:FT50-43': ('フェライトトロイダルコア FT-50-43（0.8mm 線）', aki('FT-50-43', '116918', '1個', 290, '8 回（3A 流れる）')),
    'T:BN43-202': ('めがねコア BN-43-202', other('DigiKey', 'Fair-Rite 2843002402（BN-43-202）', '在庫あり 約 $0.19（集計サイトの値（2026-10-29 調べ））。巻き方は各トランスの備考と README のコイル表のとおり')),
    # ---- ダイオード
    'D:1N4148': ('小信号ダイオード', aki('1N4148', '100941', '50本', 200)),
    'D:1N4001': ('整流ダイオード 1A', aki('1N4007-3485', '100934', '20本', 100, '1N4001 の代わりに 1N4007')),
    'D:1N4007': ('整流ダイオード 1A（VCO の可変容量に使う）', aki('1N4007-3485', '100934', '20本', 100, '1N4001 と同じ袋から')),
    'D:1N5408': ('逆接続保護ダイオード 3A', aki('1N5822', '102229', '10個', 350,
                 '秋月に 1N5408 はない。代わりにショットキー 1N5822（40V 3A、DO-201AD）。逆接続で 5A ヒューズを切る')),
    'D:1N5819': ('ショットキーダイオード 40V 1A', aki('1N5819', '117244', '10本', 100)),
    'D:1N60': ('ゲルマニウムダイオード', other('サトー電気 など（要確認）', '1N60', '秋月に扱いなし')),
    # ---- トランジスタ・FET
    'Q:2SC1815': ('NPN トランジスタ', aki('2SC1815L-GR-T92', '106477', '20個', 100)),
    'Q:2SA1015': ('PNP トランジスタ', aki('2SA1015L-GR-T92', '106734', '20個', 100)),
    'Q:2N7000': ('N-ch MOSFET', aki('2N7000', '109723', '1個', 40)),
    'Q:2N3819': ('N-ch JFET', other('DigiKey（取り寄せ）', '2N3819 APM PBFREE（Central）', 'Central 品は量産中だが DigiKey の在庫なし・取り寄せ（納期 8〜18 週）（2026-10-29 調べ）')),
    'Q:IRF510': ('N-ch パワー MOSFET（TO-220、ドライバ 1・ファイナル 2）', other('DigiKey', 'IRF510PBF（Vishay、IRF510PBF-ND）',
                 'DigiKey に 1 万個以上（標準納期 15〜20 週、2026-10-29 調べ）。RD06HHF1・RD16HHF1（製造終了）の代わり。タブ = ドレイン')),
    'Q:2N2222A': ('NPN トランジスタ（TO-92、送信バッファ）', other('DigiKey など', '2N2222A（TO-92、E-B-C の並び）',
                  'DigiKey に複数メーカーの在庫あり（2026-10-29 調べ）。2N3866（製造中止）の代わり')),
    'Q:2N3866': ('RF 用 NPN トランジスタ（TO-39）', other('要注意（製造中止）', '2N3866 または HG3866（同等品）', 'Central・Microchip・ST 品は DigiKey で製造中止（2026-10-29 調べ）。HG Semiconductor の HG3866 が同じピン配置の同等品（在庫は不定）。DigiKey の代替品一覧（onsemi など）も確認。放熱クリップも用意')),
    'Q:RD06HHF1': ('RF パワー MOSFET（三菱）', other('要注意（入手難）', 'RD06HHF1', 'RF Parts では在庫限り（NOS）・輸出不可（2026-10-29 調べ）。早めに確保するか代わりを検討')),
    'Q:RD16HHF1': ('RF パワー MOSFET（三菱）', other('要注意（入手難）', 'RD16HHF1', '代理店は見積もりのみ（中国の代理店に在庫表示）（2026-10-29 調べ）。偽物に注意。早めに確保するか代わりを検討')),
    # ---- IC・モジュール
    'U:74AC14': ('シュミットインバータ（AC、DIP）', other('DigiKey', 'SN74AC14N（296-4301-5-ND）', 'DigiKey JP 在庫あり 約 ¥120/個（2026-10-29 調べ）。必ず AC 品')),
    'U:74AC86': ('2 入力 XOR（AC、DIP）', other('DigiKey', 'SN74AC86N（296-4345-5-ND）', 'DigiKey 在庫あり 約 $0.66（2026-10-29 調べ）。必ず AC 品')),
    'U:74AC74': ('D フリップフロップ（AC、DIP）', other('DigiKey', 'SN74AC74N（296-4342-5-ND）', 'DigiKey 在庫あり 約 $0.77（2026-10-29 調べ）。PLL の位相比較。必ず AC 品')),
    'U:74AC00': ('2 入力 NAND（AC、DIP）', other('DigiKey', 'SN74AC00N（296-4287-5-ND）', 'DigiKey 在庫あり（標準納期 12 週）（2026-10-29 調べ）。PLL の位相比較のリセット。必ず AC 品')),
    'U:74HCU04': ('アンバッファインバータ（DIP）', other('DigiKey', 'SN74HCU04N（296-9820-5-ND）', 'DigiKey JP 在庫あり 約 ¥115（2026-10-29 調べ）。代わりに CD74HCU04E（296-33167-5-ND）も可。必ず U 付き')),
    'U:AD8307ANZ': ('対数増幅 IC（DIP-8、S メーター）', other('DigiKey／Mouser（要確認）', 'AD8307ANZ',
                    'Analog Devices。2026-10-29 時点で量産品、DigiKey の標準納期 10 週。秋月に扱いなし')),
    'U:ADS1115 module': ('16 ビット I2C ADC モジュール（ADS1115）', other('DigiKey（Adafruit 1085）／Amazon など（要確認）',
                         'Adafruit 1085 または同じピン並び（VDD GND SCL SDA ADDR ALRT A0〜A3）のモジュール',
                         '付属のピンヘッダをはんだ付けし、基板のピンソケットに差す。秋月に扱いなし')),
    'U:74HCT123': ('ワンショット（HCT、DIP）', other('DigiKey', 'CD74HCT123E', 'DigiKey に約 4,600 個（2026-10-29 調べ）。2 回路とも使う（PM のパルスとリセットパルス）')),
    'U:74HCT4017': ('10 進カウンタ（HCT、DIP）', other('DigiKey／Mouser（要確認）', 'CD74HCT4017E', 'DigiKey では HCT 品が見つからなかった（2026-10-29 調べ）。HC 品（CD74HC4017E、296-25989-5-ND、在庫あり）は Si5351 の 3.3V 出力を受けられない（5V で High 3.5V 以上）ので、HCT 品を探すか、間にレベル変換を入れる。秋月は表面実装の 74HC4017 だけ')),
    'U:MAX913CPA': ('高速コンパレータ（DIP-8）', other('DigiKey（要注意）', 'MAX913CPA+', '製造中止扱いの販売店が多い。DigiKey は在庫 43 個・約 €13（2026-10-29 調べ）、Rochester に在庫あり。早めに確保するか代わりを検討')),
    'U:MCP6004': ('4 回路オペアンプ（DIP-14）', other('DigiKey', 'MCP6004-I/P（MCP6004-I/P-ND）', 'DigiKey 在庫あり 約 $0.59（2026-10-29 調べ）')),
    'U:MCP6002': ('2 回路オペアンプ（DIP-8）', aki('MCP6002-E/P', '130011', '1個', 80, '確認時は入荷予定')),
    'U:NJM2594V': ('ダブルバランスドミキサ（SSOP8、表面実装）', aki('NJM2594V', '111195', '1個', 150, 'SA612AN（製造中止）の代わり。0.65mm ピッチを部品面に手はんだ')),
    'U:MC3361': ('FM IF IC（DIP-16）', other('LCSC／海外通販（要注意）', 'MC3361BPL-D16-T（UTC、DIP-16）または MC3361BP', 'Motorola 品は製造中止（2026-10-29 調べ）。UTC の互換品が LCSC で約 $0.22。古い在庫品は eBay など')),
    'U:LM386N-1': ('オーディオアンプ（DIP-8）', aki('LM386G-D08', '114548', '1個', 40, 'LM386N-1 の互換品（HTC）')),
    'U:78L05': ('3 端子レギュレータ 5V 100mA', aki('L78L05ACZ', '101250', '5個', 100, 'ピン配置（OUT-GND-IN）を基板と照合する')),
    'U:L7805': ('3 端子レギュレータ 5V 1.5A', aki('L7805CV-DG', '107903', '1個', 120)),
    'U:L7808': ('3 端子レギュレータ 8V 1.5A（TO-220）', other('DigiKey', 'L7808CV（4491-L7808CV-ND、Lumimax）', 'DigiKey マーケットプレイスに在庫あり 約 $0.50（2026-10-29 調べ）。ST 品（497-2949-5-ND）は在庫なし')),
    'U:LP2950-3.3': ('3.3V LDO レギュレータ', aki('LP2950L-33-T92', '108749', '1個', 30)),
    'U:R-78E5.0-1.0': ('DC-DC コンバータ 5V 1A（78xx 互換）', other('DigiKey／Mouser', 'R-78E5.0-1.0', '秋月は 0.5A 品 R-78E5.0-0.5（106353）のみ')),
    'U:XIAO ESP32C3': ('Seeed Studio XIAO ESP32C3', aki('113991054', '117454', '1個', 1080, '確認時は在庫僅少')),
    'U:AE-Si5351A': ('Si5351A クロックジェネレータモジュール', aki('AE-Si5351A-B', '110679', '1セット', 650, 'ピン配置を基板と照合してから取り付ける')),
    # ---- 水晶・フィルタ
    'X:10.245MHz': ('水晶振動子 10.245MHz（HC-49/U）', other('Tayda／LCSC', '10.245MHz HC-49/S（例: YXC X49SD10245MSD2SC）', 'HC-49/U の DigiKey 品は見つからない（2026-10-29 調べ）。HC-49/S（背の低い品）なら安く手に入り、足の間隔は同じ。負荷容量 18〜20pF')),
    'X:CDBM455C24': ('セラミックディスクリミネータ 455kHz', other('要確認（製造中止の恐れ）', 'CDBM455C24（村田）', '村田の 455kHz ディスクリミネータは DigiKey で製造中止の品が多い（2026-10-29 調べ）。在庫を確かめてから。入手できないときは 455kHz の LC 同調（コイル ＋ C）で置き換えを検討')),
    'FL:10M15A': ('10.7MHz 水晶フィルタ（15kHz 幅、3 ピン）', other('DigiKey', 'ECS-10.7-15A（X703-ND）', '10.7MHz・帯域 15kHz・3 端子、終端 3kΩ。DigiKey は標準納期 18 週（2026-10-29 調べ）')),
    'FL:CFWLA455KFFA': ('455kHz セラミックフィルタ', aki('LT455EU', '116046', '1個', 65,
                        'CFWLA455KFFA の代わり（±7.5kHz）。ピン配置・寸法を基板と照合する')),
    # ---- リレー・コネクタ
    'K:G5V-2 DC12': ('リレー DPDT 12V（オムロン G5V-2）', other('LCSC／DigiKey（要確認）', 'G5V-2-DC12', 'LCSC に在庫あり（2026-10-29 調べ）。DigiKey は未確認')),
    'J:header': ('ピンヘッダ', aki('PH-1x40SG', '100167', '1本(40P)', 35, 'J2・J3・J7・J5・J4・J6・J9 で 1 本')),
    'J:wire': ('ビニール線（AWG18 など）', other('手持ち／ホームセンター', '', 'DC 入力・ANT（ANT は RG-174 同軸）')),
    'TP:': ('テストポイント', other('手持ち', '', '抵抗の足の切れ端をループにして立てる')),
}

def _refs(cond):
    rs = sorted([p['ref'] for p in parts if not p['ref'].startswith('#') and cond(p)], key=lambda r: (re.match(r'[A-Z]+', r).group(0), int(re.search(r'\d+', r).group(0))))
    return len(rs), '・'.join(rs)
SOCK = {k: _refs(lambda p, k=k: (k + '_W7.62mm_Socket') in p['fp']) for k in ('DIP-8', 'DIP-14', 'DIP-16')}
XIAO = _refs(lambda p: 'XIAO' in p['fp'])[1]

# 基板の外の部品と、部品に付ける物: (品名, 数量, (購入先…), 備考)
EXTRA = [
    ('IC ソケット 8P', SOCK['DIP-8'][0], aki('2227-08-03', '100017', '10個', 110), SOCK['DIP-8'][1]),
    ('IC ソケット 14P', SOCK['DIP-14'][0], aki('2227-14-03', '100006', '10個', 120), SOCK['DIP-14'][1]),
    ('IC ソケット 16P', SOCK['DIP-16'][0], aki('2227-16-03', '100007', '10個', 180), SOCK['DIP-16'][1]),
    ('ピンソケット 1×7（XIAO 用）', 2, aki('FH-1x7SG/RH', '104285', '1個', 20), XIAO),
    ('ピンソケット 1×10（ADS1115 モジュール用）', 1, other('秋月／千石 など（要確認）', 'ピンソケット 1×10 2.54mm（40P を切ってもよい）'), 'U13'),
    ('TO-220 用 絶縁シート＋絶縁ブッシング', 3, other('秋月／マルツ など（要確認）', 'TO-220 用 シリコン（またはマイカ）絶縁シートと絶縁ブッシング'),
     'IRF510 × 3（タブ = ドレインなので放熱器から絶縁する）'),
    ('放熱器 20PB020（ドライバ IRF510 用）', 1, aki('20PB020-01025', '105054', '1個', 80), 'HS1（基板に付ける）'),
    ('放熱器 16PB017（L7808 用）', 1, aki('16PB017-01025', '105053', '1個', 60), 'U4。取り付けられる向き・隙間を要確認'),
    ('放熱器（ファイナル IRF510 × 2 用、ケース内に立てる）', 1, other('秋月／マルツ など（要確認）', '熱抵抗 5〜8℃/W、幅 50 × 高さ 30 mm 程度'),
     'ケースの後面の窓からフィンを出す（enclosure/README.md）'),
    ('ロータリーエンコーダ', 1, aki('EC12E2420801', '106357', '1個', 100, '押しスイッチ付きか要確認。確認時は在庫僅少'), 'TUNE（J5）'),
    ('AF ボリューム 10kΩA', 1, aki('SH16K4A103L20KCCI', '129553', '1個', 60), 'VOL（J4）'),
    ('電源スイッチ', 1, other('要確認', 'φ13 穴に合う 2A 以上のもの'), 'POWER'),
    ('電源 LED（3mm 緑）', 1, aki('OSG5TA3Z74A', '111635', '1個', 20, '2.2kΩ を直列に'), 'ON'),
    ('TX ランプ（3mm 赤）', 1, aki('OSR5JA3Z74A', '111577', '1個', 10), 'TX（J9）'),
    ('マイクコネクタ 4P 丸型（パネル取付 φ16）', 1, other('千石電商／マルツ など（要確認）', '4P 丸型マイクコネクタ（メス）'), 'MIC（J7）'),
    ('外部スピーカージャック（スイッチ付き）', 1, aki('MJ-352W-C', '117359', '1個', 175, 'M6 ナットでふたに固定'), 'EXT SP（J6）'),
    ('スピーカー 5cm 8Ω 0.5W', 1, aki('DXYD50N-22Z-8A-F', '116024', '1個', 250), 'ふた裏に M3 皿ねじ＋ナット 4 本'),
    ('LCD Nextion NX4832T035（3.5 インチ 480×320）', 1, other('Nextion 公式ストア／Amazon など（要確認）', 'NX4832T035', 'PSN_TRX と同じ。TJC4832T135（AliExpress の TJC 公式ストア）でも可（画面データは別に作る）。作り方は firmware/Serrasoid_TRX/nextion'), 'J3'),
    ('DC ジャック 2.1mm（パネル取付）', 1, aki('MJ-14', '106342', '1個', 70), '後面'),
    ('ヒューズホルダ（パネル取付）', 1, aki('MF-524M', '107079', '1個', 210), '後面'),
    ('ヒューズ 5A（5×20mm）', 1, aki('MF51NR 250V 5', '107131', '1個', 40), ''),
    ('BNC コネクタ（パネル取付）', 1, aki('B-014IF', '100093', '1個', 150), '後面、J8 へ RG-174'),
    ('M3 インサートナット', 24, other('Amazon／モノタロウ', ''), 'ケース（enclosure/README.md）'),
    ('M3 ねじ・皿ねじ・ナット', 1, other('ホームセンター／モノタロウ', ''), '本数は enclosure/README.md'),
]


def item_key(p):
    pf, v, n, fp = prefix(p), p['value'], p['note'], p['fp']
    if pf == 'R': return 'R:%s%s' % (v, ':1/2W' if 'DIN0414' in fp else '')
    if pf == 'C':
        k = 'C:' + v
        if 'NP0' in n or 'C0G' in n: k += ':NP0'
        if '500V' in n: k += ':500V'
        if '積層' in n: k += ':積層'
        return k
    if pf == 'L' and not v.endswith('uH'): return 'L:' + v.split()[0]
    if pf == 'T': return 'T:' + v.split()[0]
    if pf == 'J': return 'J:wire' if 'SolderWire' in fp else 'J:header'
    if pf == 'TP': return 'TP:'
    return '%s:%s' % (pf, v)


def buy_of(p):
    k = item_key(p)
    if k not in BUY: raise SystemExit('購入先が決まっていない部品: %s（%s）→ BUY に追加する' % (p['ref'], k))
    return BUY[k]


SECTION = {'R': '抵抗', 'VR': '半固定抵抗', 'TC': 'トリマコンデンサ', 'L': 'コイル', 'T': 'トランス', 'D': 'ダイオード',
           'Q': 'トランジスタ・FET', 'U': 'IC・レギュレータ・モジュール', 'X': '水晶・フィルタ', 'FL': '水晶・フィルタ',
           'K': 'リレー', 'J': 'コネクタ', 'TP': 'テストポイント'}
ORDER = ['抵抗', '半固定抵抗', 'コンデンサ（セラミック）', 'コンデンサ（電解）', 'トリマコンデンサ', 'コイル', 'トランス', 'ダイオード',
         'トランジスタ・FET', 'IC・レギュレータ・モジュール', '水晶・フィルタ', 'リレー', 'コネクタ', 'テストポイント']


def refkey(r):
    m = re.match(r'([A-Z]+)(\d+)', r); return (m.group(1), int(m.group(2)))


def rows():
    g = collections.OrderedDict()
    for p in sorted([p for p in parts if not p['ref'].startswith('#')], key=lambda p: refkey(p['ref'])):
        pf = prefix(p)
        sec = ('コンデンサ（電解）' if 'CP_Radial' in p['fp'] else 'コンデンサ（セラミック）') if pf == 'C' else SECTION[pf]
        g.setdefault((sec, item_key(p), p['value']), []).append(p)
    out = []
    for (sec, k, v), ps in g.items():
        name, b = buy_of(ps[0])
        out.append([sec, ','.join(p['ref'] for p in ps), name, v, ps[0]['fp'].split(':')[-1], len(ps), *b])
    out.sort(key=lambda r: (ORDER.index(r[0]), refkey(r[1].split(',')[0])))
    return out


def main():
    rs = rows()
    path = os.path.join(ROOT, 'kicad', 'bom_purchase.csv')
    with open(path, 'w', encoding='utf-8-sig', newline='') as fh:
        w = csv.writer(fh, lineterminator='\r\n')
        w.writerow(['区分', 'Reference', '品名', '値/型番', 'フットプリント', '数量', '購入先', '購入先の型番', '販売コード', '入数',
                    '価格（税込、%s）' % CHECKED, '購入メモ'])
        for r in rs: w.writerow(r)
        for name, qty, b, note in EXTRA:
            w.writerow(['回路図に載っていない部品', '', name, '', '', qty, *b[:5], '　'.join(x for x in (b[5], note) if x)])
    n_aki = sum(1 for r in rs if r[6] == AKI); n_chk = sum(1 for r in rs if '要確認' in r[6] or r[6] == '要確認')
    print('%s: %d 行（%d 点）＋回路図外 %d 行。秋月 %d 行、要確認 %d 行' % (os.path.basename(path), len(rs), sum(r[5] for r in rs), len(EXTRA), n_aki, n_chk))


if __name__ == '__main__':
    main()
