kazushinjo/Serrasoid_TRX_29M/tools/circuit.py

"""Serrasoid TRX 29M の回路（部品と接続）

各部品は (ブロック, 記号, 値, フットプリント, {ピン番号: ネット名}, 備考)。
ネット名 None は未接続（NC）。部品番号は種類ごとにこの並び順で自動で振る。
回路図（gen_sch.py）と基板（gen_pcb.py）はこの一覧から作る。
"""
L = 'Serrasoid_TRX:'
# ---- フットプリント
FP_R = 'Resistor_THT:R_Axial_DIN0207_L6.3mm_D2.5mm_P2.54mm_Vertical'
FP_R1W = 'Resistor_THT:R_Axial_DIN0414_L11.9mm_D4.5mm_P5.08mm_Vertical'
FP_C = 'Capacitor_THT:C_Disc_D5.0mm_W2.5mm_P2.50mm'
FP_CS = 'Capacitor_THT:C_Disc_D3.0mm_W1.6mm_P2.50mm'
FP_CHV = 'Capacitor_THT:C_Disc_D5.0mm_W2.5mm_P5.00mm'
FP_CP5 = 'Capacitor_THT:CP_Radial_D5.0mm_P2.00mm'
FP_CP6 = 'Capacitor_THT:CP_Radial_D6.3mm_P2.50mm'
FP_CP8 = 'Capacitor_THT:CP_Radial_D8.0mm_P3.50mm'
FP_TC = L + 'C_Trimmer_TMCV01'
FP_VR = L + 'Potentiometer_TOCOS_GF063P_Vertical'
FP_D35 = 'Diode_THT:D_DO-35_SOD27_P2.54mm_Vertical_AnodeUp'
FP_D41 = 'Diode_THT:D_DO-41_SOD81_P5.08mm_Vertical_AnodeUp'
FP_D201 = 'Diode_THT:D_DO-201AD_P5.08mm_Vertical_AnodeUp'
FP_TO92 = 'Package_TO_SOT_THT:TO-92_Inline'
FP_TO220 = 'Package_TO_SOT_THT:TO-220-3_Vertical'
FP_LAX = 'Inductor_THT:L_Axial_L9.5mm_D4.0mm_P2.54mm_Vertical_Fastron_SMCC'
FP_T50 = L + 'L_T50_2pin_Vertical'
FP_T30T = L + 'L_T30_3pin_Vertical'
FP_DIP8 = 'Package_DIP:DIP-8_W7.62mm_Socket'
FP_DIP14 = 'Package_DIP:DIP-14_W7.62mm_Socket'
FP_DIP16 = 'Package_DIP:DIP-16_W7.62mm_Socket'
FP_H = lambda n: 'Connector_PinHeader_2.54mm:PinHeader_1x%02d_P2.54mm_Vertical' % n
FP_WIRE = 'Connector_Wire:SolderWire-1sqmm_1x02_P5.4mm_D1.4mm_OD2.7mm'
FP_TP = 'TestPoint:TestPoint_THTPad_D1.5mm_Drill0.7mm'

parts = []
def add(blk, sym, val, fp, pins, note=''):
    parts.append(dict(block=blk, sym=sym, value=val, fp=fp, pins=pins, note=note))

def R(b, v, n1, n2, note='', fp=FP_R): add(b, 'Device:R', v, fp, {'1': n1, '2': n2}, note)
def C(b, v, n1, n2, note='', fp=FP_C): add(b, 'Device:C', v, fp, {'1': n1, '2': n2}, note)
def CP(b, v, plus, minus, note='', fp=FP_CP5): add(b, 'Device:C_Polarized', v, fp, {'1': plus, '2': minus}, note)
def TC(b, v, n1, n2, note=''): add(b, 'Device:C_Trim', v, FP_TC, {'1': n1, '2': n2}, note)
def Lx(b, v, n1, n2, note='', fp=FP_LAX): add(b, 'Device:L', v, fp, {'1': n1, '2': n2}, note)
def LT(b, v, hot, tap, cold, note=''): add(b, L + 'L_Tap', v, FP_T30T, {'1': hot, '2': tap, '3': cold}, note)
def VR(b, v, p1, w, p3, note=''): add(b, 'Device:R_Potentiometer_Trim', v, FP_VR, {'1': p1, '2': w, '3': p3}, note)
def D(b, v, k, a, note='', sym='Device:D', fp=FP_D35): add(b, sym, v, fp, {'1': k, '2': a}, note)
def NPN(b, v, e, c, bb, note=''): add(b, 'Transistor_BJT:Q_NPN_ECB', v, FP_TO92, {'1': e, '2': c, '3': bb}, note)
def PNP(b, v, e, c, bb, note=''): add(b, 'Transistor_BJT:Q_PNP_ECB', v, FP_TO92, {'1': e, '2': c, '3': bb}, note)
def HDR(b, v, nets, note='', fp=None):
    add(b, 'Connector_Generic:Conn_01x%02d' % len(nets), v, fp or FP_H(len(nets)),
        {str(i + 1): n for i, n in enumerate(nets)}, note)
def TP(b, v, net, note=''): add(b, 'Connector:TestPoint', v, FP_TP, {'1': net}, note)
def REMOVED(sym):
    """取り外した部品。仮の部品番号を 1 つ使うだけで、回路には入らない（RENUMBER の対応をずらさないため）"""
    parts.append(dict(block=None, sym=sym, value='', fp='', pins={}, note='', removed=True))

G = 'GND'

# =====================================================================
# 電源
# =====================================================================
B = '電源'
HDR(B, 'DC 13.8V', ['+13V8', G], '後面の DC ジャックから（ヒューズ 5A は後面パネル側）', fp=FP_WIRE)
D(B, '1N5408', '+13V8', G, '逆接続保護（逆接続でヒューズを切る）', sym='Diode:1N5408', fp=FP_D201)
CP(B, '470u', '+13V8', G, '25V 以上', fp=FP_CP8)
C(B, '0.1u', '+13V8', G)
Lx(B, '10uH', '+13V8', 'DCDC_IN', 'DC-DC 入力フィルタ')
CP(B, '10u', 'DCDC_IN', G, '25V 以上')
add(B, 'Converter_DCDC:R-78E5.0-1.0', 'R-78E5.0-1.0', 'Converter_DCDC:Converter_DCDC_RECOM_R-78E-0.5_THT',
    {'1': 'DCDC_IN', '2': G, '3': '+5V'}, 'デジタル系 5V（XIAO・表示）')
CP(B, '10u', '+5V', G)
C(B, '0.1u', '+5V', G)
add(B, 'Regulator_Linear:L7808', 'L7808', FP_TO220, {'1': '+13V8', '2': G, '3': '+8V'}, '受信・送信バイアス・アナログ系。小型放熱器を付ける')
C(B, '0.33u', '+13V8', G)
CP(B, '10u', '+8V', G)
C(B, '0.1u', '+8V', G)
add(B, 'Regulator_Linear:L7805', 'L7805', FP_TO220, {'1': '+8V', '2': G, '3': '+5VT'}, '変調部専用 5V（リニア。DC-DC のリプルを変調に入れないため）')
C(B, '0.1u', '+8V', G)
CP(B, '10u', '+5VT', G)
C(B, '0.1u', '+5VT', G)
add(B, 'Regulator_Linear:LP2950-3.3_TO92', 'LP2950-3.3', FP_TO92, {'1': '+3V3S', '2': G, '3': '+5V'}, 'Si5351 モジュール用 3.3V')
CP(B, '10u', '+3V3S', G)
C(B, '0.1u', '+3V3S', G)
for n in ['+13V8', G, 'DCDC_IN']:
    add(B, 'power:PWR_FLAG', 'PWR_FLAG', '', {'1': n})

# =====================================================================
# 制御（XIAO ESP32C3・Si5351・送受切替）
# =====================================================================
B = '制御'
add(B, L + 'XIAO_ESP32C3', 'XIAO ESP32C3', L + 'Seeeduino_XIAO_Socket',
    {'1': 'PTT_IN', '2': 'FWD_ADC', '3': 'NOISE_ADC', '4': 'ENC_A', '5': 'SDA', '6': 'SCL', '7': 'UART_TX',
     '8': 'XIAO_5V', '9': G, '10': '+3V3X', '11': 'TX_EN', '12': 'ENC_SW', '13': 'ENC_B', '14': 'MUTE'},
    'ソケット実装。起動設定ピン D0（GPIO2）・D9（GPIO9）は起動時に High が必要なので、ふだん開放の PTT と'
    'エンコーダ SW をつなぐ（PTT・つまみを押したまま電源を入れない）。D8（GPIO8）はフラッシュ起動に関係しないのでエンコーダ B 相')
D(B, '1N5819', 'XIAO_5V', '+5V', 'USB 接続時の逆流防止', sym='Diode:1N5819', fp=FP_D41)
add(B, 'power:PWR_FLAG', 'PWR_FLAG', '', {'1': 'XIAO_5V'})
R(B, '4.7k', '+3V3X', 'SDA', 'I2C プルアップ')
R(B, '4.7k', '+3V3X', 'SCL', 'I2C プルアップ')
add(B, L + 'Si5351_Module', 'AE-Si5351A', L + 'DIP-8_W7.62mm',
    {'1': '+3V3S', '2': 'SCL', '3': 'SDA', '4': G, '5': 'CLK0', '6': 'CLK1', '7': None, '8': '+3V3S'},
    '秋月 AE-Si5351A。CLK0 = 変調基準 1.83125MHz（送信時のみ。29.3MHz ÷ 16）、CLK1 = 受信局発 18.6MHz（受信時のみ）')
HDR(B, 'I2C', ['+3V3X', 'SCL', 'SDA', G], 'OLED 表示を使う場合の予備')
HDR(B, 'LCD', ['+5V', 'UART_TX', None, G], 'Nextion NX4832T035（または TJC4832T135）表示器。2 番（XIAO の TX）→ 表示器の RX（黄）。表示器の TX（青）はつながない（表示器からの受信は使わない）')
HDR(B, 'ENC', ['ENC_A', 'ENC_B', 'ENC_SW', G, G], 'ロータリーエンコーダ（上面 TUNE）')
R(B, '10k', '+3V3X', 'ENC_A')
R(B, '10k', '+3V3X', 'ENC_B')
R(B, '10k', '+3V3X', 'ENC_SW')
R(B, '10k', '+3V3X', 'PTT_IN', 'PTT プルアップ')
R(B, '1k', 'MIC_PTT', 'PTT_IN', 'PTT 保護抵抗')
C(B, '0.01u', 'PTT_IN', G)
# 送受切替: TX_EN → Q → K1。K1 の 1 極目でアンテナ、2 極目で 8V を TX8V / RX8V に振り分ける
R(B, '1k', 'TX_EN', 'RLY_B', 'リレー駆動のベース電流 約 2.6mA（コイル約 42mA を確実に飽和させる）')
R(B, '10k', 'RLY_B', G)
NPN(B, '2SC1815', G, 'RLY_C', 'RLY_B', 'リレー駆動')
D(B, '1N4001', '+13V8', 'RLY_C', 'リレーコイルの逆起電力吸収', sym='Diode:1N4001', fp=FP_D41)
add(B, 'Relay:G5V-2', 'G5V-2 DC12', 'Relay_THT:Relay_DPDT_Omron_G5V-2',
    {'1': '+13V8', '16': 'RLY_C', '4': 'ANT', '6': 'RX_ANT', '8': 'TX_OUT', '13': '+8V', '11': 'RX8V', '9': 'TX8V'},
    '送受切替。1 極目: アンテナ（NC=受信、NO=送信）、2 極目: 8V を RX8V / TX8V へ')
HDR(B, 'ANT', ['ANT', G], '後面 BNC へ（RG-174 で配線）', fp=FP_WIRE)
R(B, '1.5k', 'TX8V', 'TXLED', 'TX ランプ電流')
HDR(B, 'TX LED', ['TXLED', G], '上面の TX ランプ')
CP(B, '47u', 'TX8V', G)
CP(B, '47u', 'RX8V', G)
for n in ['TX8V', 'RX8V']:             # リレー接点から出る電源なので、ここで「電源の出どころ」を示す
    add(B, 'power:PWR_FLAG', 'PWR_FLAG', '', {'1': n})

# =====================================================================
# セラゾイド変調（+5VT）
# =====================================================================
B = 'セラゾイド変調'
R(B, '100', 'CLK0', 'CLK0_IN', 'Si5351 CLK0（1.83125MHz）の直列抵抗')
# 2026-10-29 74HCT4017（製造中止）を取り外し: CLK0 を 1.83125MHz にして、リセットパルスは 74HCT123 の 2 回路目で作る（一覧の最後）
REMOVED('4xxx:4017')
REMOVED('Device:C')
# のこぎり波: 2SA1015 定電流源で C を充電、2N7000 で放電
R(B, '1.5k', '+5VT', 'RE_N', '定電流源エミッタ抵抗')
VR(B, '1k', 'RE_N', 'RAMP_E', 'RAMP_E', 'のこぎり波の傾き調整（約 260〜430µA）')
D(B, '1N4148', 'VB1', '+5VT', '基準電圧（ダイオード 2 本）', sym='Diode:1N4148')
D(B, '1N4148', 'RAMP_B', 'VB1', '', sym='Diode:1N4148')
R(B, '10k', 'RAMP_B', G)
C(B, '0.1u', '+5VT', 'RAMP_B')
PNP(B, '2SA1015', 'RAMP_E', 'RAMP', 'RAMP_B', '定電流源')
C(B, '68p', 'RAMP', G, 'C0G（NP0）必須。のこぎり波の直線性に直結。山 約 1.5〜1.7V', fp=FP_CS)
R(B, '100', 'RST_P', 'RST_G')
add(B, 'Transistor_FET:2N7000', '2N7000', FP_TO92, {'1': G, '2': 'RST_G', '3': 'RAMP'}, '放電スイッチ')
TP(B, 'RAMP', 'RAMP', 'のこぎり波の観測点')
# コンパレータ: 2026-10-29 MAX913（入手難）を取り外し、2SA1015 の差動対で組んだ（一覧の最後）
REMOVED('Comparator:LT1016')
REMOVED('Device:C')
TP(B, 'THRESH', 'THRESH', 'しきい値（約 0.85V ± 音声）の観測点')
# パルス整形（ワンショット）
add(B, '74xx:74HC123', '74HCT123', FP_DIP16,
    {'1': 'COMP_N', '2': '+5VT', '3': '+5VT', '13': 'PM_OUT', '4': None, '14': 'OS_C', '15': 'OS_RC',
     '9': G, '10': 'CLK0_IN', '11': '+5VT', '5': 'RST_P', '12': None, '6': 'OS2_C', '7': 'OS2_RC', '8': G, '16': '+5VT'},
    '1 回路目: コンパレータの出力の立ち下がり（1A）で約 273ns（デューティ 50%）の PM_OUT。'
    '2 回路目: CLK0 の立ち上がり（2B）で約 50〜100ns のリセットパルス（2N7000 で放電）。HCT 品（Si5351 の 3.3V 出力を受けるため）')
C(B, '100p', 'OS_C', 'OS_RC', 'ワンショット時定数', fp=FP_CS)
R(B, '2.2k', '+5VT', 'OS_R')
VR(B, '5k', 'OS_R', 'OS_RC', 'OS_RC', 'パルス幅（デューティ 50%）調整')
C(B, '0.1u', '+5VT', G)
TP(B, 'PM', 'PM_OUT', '位相変調された 1.83125MHz の観測点（立ち上がりが音声で揺れる）')

# =====================================================================
# 逓倍 ×16（+5VT）
# =====================================================================
B = '逓倍'
# 各段: XOR(x, x を RC で遅らせて 74AC14 で整形・反転したもの) → 2 倍の周波数。
# 遅延（RC ＋ 74AC14 約 6ns）を入力周期の 1/4 にすると出力のデューティが 50% になる。
# 段 1〜3 の出力は LC 同調で正弦波にしてから矩形に戻す（一覧の最後、段間同調）。
# 2026-10-29 スプリアス対策で ×32（5 段）から ×16（4 段）に減らした。もとの段 1（3.9k・100p）と 2 個目の 74AC86 は取り外し
REMOVED('Device:R')
REMOVED('Device:C')
stages = [('PM_OUT', 'X2', '1.8k', '100p', '137ns（1.83MHz の 1/4 周期）'),
          ('X2S', 'X4', '910', '100p', '68ns（3.66MHz の 1/4 周期）'),
          ('X4S', 'X8', '510', '82p', '34ns（7.33MHz の 1/4 周期）'),
          ('X8S', 'X16', '330', '47p', '17ns（14.65MHz の 1/4 周期）')]
inv_pins = [('1', '2'), ('3', '4'), ('5', '6'), ('9', '8'), ('11', '10'), ('13', '12')]
gate_pins = [('1', '2', '3'), ('4', '5', '6'), ('9', '10', '8'), ('12', '13', '11')]
dl = []
inv = {'7': G, '14': '+5VT'}
for i, (xi, xo, rv, cv, t) in enumerate(stages):
    rc, dn = 'RC%d' % (i + 1), 'DLY%d' % (i + 1)
    R(B, rv, xi, rc, '×2 段 %d の遅延 %s' % (i + 1, t))
    C(B, cv, rc, G, 'NP0', fp=FP_CS)
    inv.update({inv_pins[i][0]: rc, inv_pins[i][1]: dn})
    dl.append((xi, dn, xo))
# 残りの 2 個は段 1・2 の同調の後の整形（シュミットなので、受信中に入力がしきい値付近に止まっても発振しない）
inv.update({'11': 'SQO1', '10': 'X2S', '13': 'SQO2', '12': 'X4S'})
add(B, '74xx:74HC14', '74AC14', FP_DIP14, inv, 'RC 遅延の後の波形整形（シュミット）と、段 1・2 の同調の後の整形。'
    '74AC86 に遅い波形を入れないため。必ず AC 品')
C(B, '0.1u', '+5VT', G)
u1 = {'7': G, '14': '+5VT'}
for (a, b2, y), (xi, dn, xo) in zip(gate_pins, dl):
    u1.update({a: xi, b2: dn, y: xo})
add(B, '74xx:74HC86', '74AC86', FP_DIP14, u1, '×2 段 1〜4（1.83 → 3.66 → 7.33 → 14.65 → 29.3MHz）。必ず AC 品')
REMOVED('74xx:74HC86')
C(B, '0.1u', '+5VT', G)
REMOVED('Device:C')
B = 'PLL'      # VCO の出力から送信 BPF へ（2026-10-29 から PLL の一部。部品番号の並びを保つためここに置く）
TP(B, 'TXOSC', 'TXOSC', '29.3MHz（PLL の VCO）の観測点')
R(B, '330', 'TXOSC', 'TXDRV', '送信 BPF への直列抵抗。VCO の出力バッファ 3 回路を 330Ω ずつで合わせる（並列で約 110Ω）')
C(B, '0.01u', 'TXDRV', 'TXBPF_IN')

# =====================================================================
# 送信音声（MCP6004、+5VT）
# =====================================================================
B = '送信音声'
R(B, '10k', '+5VT', 'VREF', 'VREF = 2.5V')
R(B, '10k', 'VREF', G)
CP(B, '10u', 'VREF', G)
HDR(B, 'MIC', ['MIC', 'MIC_PTT', G], 'エレクトレットマイク・PTT（上面 MIC）')
R(B, '470', '+5VT', 'MICB', 'マイク電源デカップリング')
CP(B, '47u', 'MICB', G)
R(B, '2.2k', 'MICB', 'MIC', 'エレクトレットのバイアス')
C(B, '1u', 'MIC', 'MA_IN')
R(B, '10k', 'MA_IN', 'MA_N')
R(B, '220k', 'MA_N', 'MA_OUT', 'マイクアンプ利得 22')
C(B, '220p', 'MA_N', 'MA_OUT', '高域カット', fp=FP_CS)
C(B, '1u', 'MA_OUT', 'MG_IN')
VR(B, '10k', 'MG_IN', 'MG_W', 'VREF', 'マイク利得')
R(B, '100k', 'MB_N', 'MB_OUT', '利得 11')
R(B, '10k', 'MB_N', 'VREF')
R(B, '2.2k', 'MB_OUT', 'CLIP', 'IDC（クリップ）')
D(B, '1N4148', 'VREF', 'CLIP', 'クリップ ±0.6V', sym='Diode:1N4148')
D(B, '1N4148', 'CLIP', 'VREF', '', sym='Diode:1N4148')
R(B, '15k', 'CLIP', 'SK1', '3kHz LPF（サレンキー）')
R(B, '15k', 'SK1', 'SK2')
C(B, '4.7n', 'SK1', 'SK_OUT')
C(B, '2.2n', 'SK2', 'VREF')
C(B, '1u', 'SK_OUT', 'DEV_IN')
VR(B, '10k', 'DEV_IN', 'DEV_W', 'VREF', '周波数偏移（±5kHz に調整）')
R(B, '100k', 'DEV_W', 'TH_SUM')
VR(B, '10k', '+5VT', 'CEN_W', G, 'しきい値の中心（エッジがのこぎり波の中央に来るように）')
CP(B, '10u', 'CEN_W', G)
R(B, '10k', 'CEN_W', 'TH_SUM')
add(B, 'Amplifier_Operational:MCP6004', 'MCP6004', FP_DIP14,
    {'3': 'VREF', '2': 'MA_N', '1': 'MA_OUT',
     '5': 'MG_W', '6': 'MB_N', '7': 'MB_OUT',
     '10': 'SK2', '9': 'SK_OUT', '8': 'SK_OUT',
     '12': 'TH_SUM', '13': 'THRESH', '14': 'THRESH',
     '4': '+5VT', '11': G},
    'A: マイクアンプ、B: 利得段、C: 3kHz LPF、D: しきい値バッファ')
C(B, '0.1u', '+5VT', G)

# =====================================================================
# 送信 RF（BPF・2N2222A・IRF510 ドライバ・IRF510 プッシュプル・LPF）
# =====================================================================
B = '送信RF'
LT(B, 'T30-6 17T/2T', 'TB1', 'TXBPF_IN', G, '送信 BPF 1 段目。T-30-6 に 0.4mm 線 17 回、コールド側から 2 回目でタップ')
C(B, '22p', 'TB1', G, 'NP0', fp=FP_CS)
TC(B, '30p', 'TB1', G, '29.3MHz に同調')
C(B, '1p', 'TB1', 'TB2', 'NP0、段間結合（2p では過結合で ±1.8MHz が落ちない。1p で 29.0〜29.7MHz の偏差 0.6dB 以内）', fp=FP_CS)
LT(B, 'T30-6 17T/2T', 'TB2', 'TXBPF_OUT', G, '送信 BPF 2 段目')
C(B, '22p', 'TB2', G, 'NP0', fp=FP_CS)
TC(B, '30p', 'TB2', G, '29.3MHz に同調')
# バッファ 2N2222A（TX8V、約 33mA）。2026-10-29 2N3866（製造中止）から変更
C(B, '0.01u', 'TXBPF_OUT', 'Q_BUF_B')
R(B, '560', 'TX8V', 'Q_BUF_B', 'ベースバイアス（分圧電流 約 12mA、hFE が低くても約 40mA を保つ）')
R(B, '120', 'Q_BUF_B', G)
add(B, 'Transistor_BJT:Q_NPN_EBC', '2N2222A', FP_TO92,
    {'1': 'Q_BUF_E', '2': 'Q_BUF_B', '3': 'Q_BUF_C'}, 'バッファ（TO-92、E-B-C の並び。fT 250MHz 以上、コレクタ損失 約 0.3W）')
R(B, '4.7', 'Q_BUF_E', 'Q_BUF_E2', '帰還（バイパスしない）')
R(B, '18', 'Q_BUF_E2', G, 'エミッタ電流 約 33mA（2N2222A の損失を 0.25W 程度に）')
C(B, '0.01u', 'Q_BUF_E2', G)
Lx(B, '10uH', 'TX8V', 'Q_BUF_C', 'コレクタチョーク')
C(B, '0.01u', 'TX8V', G)
C(B, '0.01u', 'Q_BUF_C', 'DRV_IN')
# ドライバ IRF510（ドレイン 13.8V、ゲートバイアスは TX8V から）。2026-10-29 RD06HHF1（製造終了）から変更
R(B, '10', 'DRV_IN', 'DRV_G', 'ゲートストッパー')
R(B, '47', 'DRV_IN', 'DRV_SW', '入力スワンプ')
C(B, '0.01u', 'DRV_SW', G)
R(B, '3.3k', 'TX8V', 'DRV_BN')
VR(B, '5k', 'DRV_BN', 'DRV_BW', G, 'ドライバ IRF510 のアイドル電流（約 150mA。ゲート約 3.5〜4V）')
C(B, '0.01u', 'DRV_BW', G)
R(B, '1k', 'DRV_BW', 'DRV_IN', 'ゲートバイアス')
add(B, 'Transistor_FET:IRF540N', 'IRF510', FP_TO220, {'1': 'DRV_G', '2': 'DRV_D', '3': G},
    'ドライバ（約 0.5W）。放熱器 HS1 に固定。タブ = ドレイン（+13.8V）なので絶縁シートと絶縁ブッシングで絶縁する')
Lx(B, 'FT37-43 10T', '+13V8', 'DRV_D', 'ドレインチョーク（約 35µH）', fp=FP_T50)
C(B, '0.1u', '+13V8', G)
C(B, '0.01u', 'DRV_D', 'PA_IN')
# ファイナル IRF510 × 2 プッシュプル（2026-10-29 RD16HHF1（製造終了）から変更）。29MHz・13.8V で 5W 前後の見込み
# 入力: T（BN43-202 1:1、2 次側センタータップ）→ ゲートストッパー 10Ω → 各ゲート。各半分を 22Ω でスワンプ（ドライバから見て約 44Ω）
# 出力: T（BN43-202、1 次 2 回センタータップ・2 次 3 回、1:2.25）。センタータップから 13.8V を給電、ドレイン間 約 22Ω
R(B, '10', 'PA_GA_IN', 'PA_GA', 'ゲートストッパー（A）')
R(B, '22', 'PA_GA_IN', 'PA_BIAS', '入力スワンプ（A）', fp=FP_R1W)
R(B, '22', 'PA_GB_IN', 'PA_BIAS', '入力スワンプ（B）', fp=FP_R1W)
C(B, '0.1u', 'PA_BIAS', G, 'バイアス点を交流で GND に')
R(B, '3.3k', 'TX8V', 'PA_BN')
VR(B, '5k', 'PA_BN', 'PA_BW', G, 'ファイナル IRF510 × 2 のアイドル電流（合計 約 100mA）')
C(B, '0.01u', 'PA_BW', G)
R(B, '1k', 'PA_BW', 'PA_BIAS', 'ゲートバイアス（入力トランスのセンタータップへ）')
add(B, 'Transistor_FET:IRF540N', 'IRF510', FP_TO220, {'1': 'PA_GA', '2': 'PA_DA', '3': G},
    'ファイナル A。基板の後ろの端に立て、ケースの放熱器にねじ止め。タブ = ドレインなので絶縁シートと絶縁ブッシングで絶縁する')
REMOVED('Device:L')
C(B, '0.1u', '+13V8', G)
C(B, '0.01u', '+13V8', G)
CP(B, '220u', '+13V8', G, '25V 以上', fp=FP_CP8)
REMOVED('Device:C')
add(B, 'Device:Transformer_SP_1S', 'BN43-202 2T(CT):3T', L + 'Transformer_BN43-202_SP',
    {'1': 'PA_DB', '2': '+13V8', '3': 'PA_DA', '4': 'LPF_IN', '5': G},
    '出力トランス。1 次 2 回（センタータップから 13.8V）・2 次 3 回（1:2.25、ドレイン間 約 22Ω → 50Ω）。1 次は 0.8mm 線（約 0.7A ずつ）')
# 7 次チェビシェフ LPF（fc 約 32MHz）
C(B, '120p', 'LPF_IN', G, 'NP0 500V', fp=FP_CHV)
Lx(B, 'T50-6 9T', 'LPF_IN', 'LPF2', '約 0.35µH', fp=FP_T50)
C(B, '220p', 'LPF2', G, 'NP0 500V', fp=FP_CHV)
Lx(B, 'T50-6 10T', 'LPF2', 'LPF3', '約 0.39µH', fp=FP_T50)
C(B, '220p', 'LPF3', G, 'NP0 500V', fp=FP_CHV)
Lx(B, 'T50-6 9T', 'LPF3', 'TX_OUT', '約 0.35µH', fp=FP_T50)
C(B, '120p', 'TX_OUT', G, 'NP0 500V', fp=FP_CHV)
# 出力検出（進行波の目安）
C(B, '4.7p', 'TX_OUT', 'FD1', 'NP0 500V。容量分割', fp=FP_CS)
C(B, '100p', 'FD1', G, '', fp=FP_CS)
R(B, '10k', 'FD1', G)
D(B, '1N60', 'FD2', 'FD1', '出力検波（ゲルマニウム）')
C(B, '0.01u', 'FD2', G)
R(B, '47k', 'FD2', G)
R(B, '10k', 'FD2', 'FWD_ADC')
C(B, '0.1u', 'FWD_ADC', G)

# =====================================================================
# 受信（BPF・2N3819・NJM2594・10.7MHz 増幅・10.7MHz 水晶フィルタ・MC3361）
# =====================================================================
B = '受信'
D(B, '1N4148', G, 'RX_ANT', '入力保護', sym='Diode:1N4148')
D(B, '1N4148', 'RX_ANT', G, '入力保護', sym='Diode:1N4148')
LT(B, 'T30-6 17T/2T', 'RB1', 'RX_ANT', G, '受信 BPF 1 段目')
C(B, '22p', 'RB1', G, 'NP0', fp=FP_CS)
TC(B, '30p', 'RB1', G, '29.3MHz に同調')
C(B, '2p', 'RB1', 'RB2', 'NP0、段間結合', fp=FP_CS)
LT(B, 'T30-6 17T/2T', 'RB2', None, G, '受信 BPF 2 段目（タップは使わない）')
C(B, '22p', 'RB2', G, 'NP0', fp=FP_CS)
TC(B, '30p', 'RB2', G, '29.3MHz に同調')
R(B, '4.7k', 'RB2', G, 'Q 調整')
add(B, 'Transistor_FET:2N3819', '2N3819', 'Package_TO_SOT_THT:TO-92_Inline', {'1': 'RFA_D', '2': 'RB2', '3': 'RFA_S'},
    'RF アンプ（ソース接地）')
R(B, '330', 'RFA_S', G)
C(B, '0.01u', 'RFA_S', G)
Lx(B, '10uH', 'RX8V', 'RFA_D', 'ドレインチョーク（2N3819 の Idss のばらつきでドレイン電圧が下がらないように）')
R(B, '1k', 'RX8V', 'RFA_D', '負荷（NJM2594 の入力 600Ω と並列で約 375Ω、利得 約 4dB。感度が足りなければ外す）')
C(B, '0.01u', 'RX8V', G)
C(B, '0.01u', 'RFA_D', 'MIX_IN')
# 第 1 混合 NJM2594（SA612 は製造中止なので置き換え。データシートの応用回路「エミッタ・フォロア出力タイプ」）
add(B, L + 'NJM2594', 'NJM2594V', 'Package_SO:TSSOP-8_4.4x3mm_P0.65mm',
    {'5': 'MIX_IN', '6': 'MIX_BYP', '7': 'LO_IN', '8': None, '1': '+5VA', '2': None, '3': 'MIX_EF', '4': G},
    '第 1 混合（DBM、変換利得 0dB）。表面実装 SSOP8（0.65mm ピッチ）、部品面に手はんだ（この部品だけ表面実装）。'
    '3 番エミッタフォロワ出力、2 番は開放、8 番（内部で未接続）は開放（基板で両側を信号線に挟まれ GND に落とせないため）')
C(B, '0.1u', 'MIX_BYP', G, '差動入力の中点（6 番）の AC 接地')
C(B, '0.1u', '+5VA', G)
R(B, '1.2k', 'CLK1', 'LO_DIV', '局発を約 106mVrms に減衰（NJM2594 のキャリア入力 1200Ω。データシートの規格 100mVrms・−7dBm、約 100mV 以上で出力一定）')
R(B, '100', 'LO_DIV', G)
C(B, '0.01u', 'LO_DIV', 'LO_IN')
add(B, L + 'Filter_3pin', '10M15A', 'Crystal:Crystal_HC49-U-3Pin_Vertical', {'1': 'MIX_OUT', '2': G, '3': 'IF1'},
    '10.7MHz 水晶フィルタ（帯域 ±7.5kHz）。ピン配置は実物で確認')
# MC3361
add(B, L + 'MC3361', 'MC3361', FP_DIP16,
    {'16': 'IF1', '1': 'OSC_B', '2': 'OSC_E', '3': 'MIX3', '5': 'LIM_IN', '6': 'DEC1', '7': 'DEC2', '8': 'QUAD',
     '9': 'AF_DEM', '10': None, '11': None, '12': None, '13': None, '14': None, '4': '+5VA', '15': G},
    '第 2 混合（455kHz）・リミッタ・検波。スケルチは XIAO 側で行うので 10〜14 番は未使用')
add(B, 'Device:Crystal', '10.245MHz', 'Crystal:Crystal_HC49-U_Vertical', {'1': 'OSC_B', '2': '+5VA'}, '第 2 局発。データシートの試験回路どおり 1 番と VCC の間')
C(B, '68p', 'OSC_B', 'OSC_E', 'NP0', fp=FP_CS)
C(B, '220p', 'OSC_E', '+5VA', 'NP0（データシートどおり VCC へ）', fp=FP_CS)
add(B, L + 'Filter_3pin', 'CFWLA455KFFA', L + 'Filter_Ceramic_3pin_P2.54mm', {'1': 'MIX3', '2': G, '3': 'LIM_IN'},
    '455kHz セラミックフィルタ（±7.5kHz 程度）。ピン配置は実物で確認')
C(B, '0.1u', 'DEC1', '+5VA', 'データシートどおり VCC へ')
C(B, '0.1u', 'DEC2', '+5VA', 'データシートどおり VCC へ')
add(B, 'Device:Crystal', 'CDBM455C24', FP_CHV, {'1': 'QUAD', '2': '+5VA'}, '455kHz セラミックディスクリミネータ（2 端子、5mm ピッチ）')
R(B, '20k', 'QUAD', '+5VA', 'ダンピング（データシートは 20k）。音が歪むときは 6.8k〜47k で調整')
C(B, '0.1u', '+5VA', G)
# ディエンファシス・音量・ミュート・LM386
R(B, '10k', 'AF_DEM', 'AF_DE', 'ディエンファシス 470µs')
C(B, '0.047u', 'AF_DE', G)
C(B, '1u', 'AF_DE', 'VOL_H')
HDR(B, 'VOL', ['VOL_H', 'VOL_W', G], '上面 VOL（10kΩ A カーブ）')
R(B, '4.7k', 'VOL_W', 'AF_IN')
NPN(B, '2SC1815', G, 'AF_IN', 'MUTE_B', 'スケルチのミュート（MUTE = High で消音）')
R(B, '10k', 'MUTE', 'MUTE_B')
R(B, '10k', 'MUTE_B', G)
add(B, 'Amplifier_Audio:LM386', 'LM386N-1', FP_DIP8,
    {'3': 'AF_IN', '2': G, '4': G, '6': 'RX8V', '7': 'AF_BYP', '5': 'AF_OUT', '1': None, '8': None}, '低周波増幅（利得 20）')
CP(B, '10u', 'AF_BYP', G)
C(B, '0.1u', 'RX8V', G)
CP(B, '100u', 'RX8V', G, '', fp=FP_CP6)
R(B, '10', 'AF_OUT', 'ZOBEL')
C(B, '0.047u', 'ZOBEL', G)
CP(B, '220u', 'AF_OUT', 'SPK', '16V 以上', fp=FP_CP6)
HDR(B, 'SP', ['SPK', G], 'スピーカー 8Ω')
add(B, 'Regulator_Linear:L78L05_TO92', '78L05', FP_TO92, {'1': '+5VA', '2': G, '3': 'RX8V'}, '受信用 5V（NJM2594・MC3361・スケルチ）')
C(B, '0.1u', 'RX8V', G)
CP(B, '10u', '+5VA', G)
# スケルチ用ノイズ検出（MCP6002、+5VA）
R(B, '10k', '+5VA', 'NREF')
R(B, '10k', 'NREF', G)
CP(B, '10u', 'NREF', G)
C(B, '2.2n', 'AF_DEM', 'NQ_IN', 'ノイズ HPF（約 7kHz 以上）')
R(B, '10k', 'NQ_IN', 'NQ_N')
R(B, '470k', 'NQ_N', 'NQ_OUT', 'ノイズアンプ利得 47')
add(B, 'Amplifier_Operational:MCP6002-xP', 'MCP6002', FP_DIP8,
    {'3': 'NREF', '2': 'NQ_N', '1': 'NQ_OUT', '5': 'NREF', '6': 'NQ_B', '7': 'NQ_B', '8': '+5VA', '4': G},
    'A: スケルチ用ノイズアンプ、B: 未使用（ボルテージフォロワで固定）')
C(B, '0.1u', '+5VA', G)
C(B, '0.1u', 'NQ_OUT', 'NR1')
D(B, '1N60', 'NR1', G, '倍電圧検波')
D(B, '1N60', 'NOISE_V', 'NR1')
C(B, '0.47u', 'NOISE_V', G)
R(B, '100k', 'NOISE_V', G)
R(B, '10k', 'NOISE_V', 'NOISE_ADC')
R(B, '22k', 'NOISE_ADC', G, 'ADC 入力を 3.1V 以下に')
# 第 1 混合の出力と 10.7MHz 増幅（NJM2594 の変換利得 0dB を補う。SA612 は約 +14dB だった）
# 部品番号は回路一覧の順で仮に振るので、追加した部品はここ（一覧の最後）に置く
R(B, '1k', 'MIX_EF', G, 'NJM2594 のエミッタフォロワの負荷（アイドル電流 約 3.3mA ＝（5V − 1.7V）÷ 1k）')
C(B, '0.01u', 'MIX_EF', 'IFA_B')
R(B, '22k', 'RX8V', 'IFA_B', '10.7MHz 増幅のベースバイアス（約 1.4V）')
R(B, '4.7k', 'IFA_B', G)
NPN(B, '2SC1815', 'IFA_E', 'IFA_C', 'IFA_B', '10.7MHz 増幅（エミッタ接地、約 18dB。Ic 約 2.9mA）')
R(B, '82', 'IFA_E', 'IFA_E2', 'エミッタ帰還（バイパスしない。利得 ≒ 1.5k ÷ 91Ω）')
R(B, '180', 'IFA_E2', G)
C(B, '0.1u', 'IFA_E2', G)
R(B, '1.5k', 'RX8V', 'IFA_C', 'コレクタ負荷（水晶フィルタの入力側の終端。10M15A の規格に合わせて調整）')
C(B, '0.1u', 'RX8V', G)
C(B, '0.01u', 'IFA_C', 'MIX_OUT')

# =====================================================================
# 段間同調（逓倍、+5VT）2026-10-29 スプリアス対策
# =====================================================================
# 段 1〜3 の XOR 出力を 1k（段 3 は 470Ω）で LC 並列共振（Q 約 5、調整なし）に入れて正弦波にし、自己バイアスの 74HCU04 で
# 平均値を境に矩形へ戻す → デューティが 50% にそろい、前の段の遅延ずれ（入力周波数の成分）が約 16dB 下がる。
# シミュレーションでは、同調がないと部品のばらつきで ×16 の出力のエッジが欠ける（200 台中 160 台）のが 0 台になった
B = '逓倍'
# L は秋月のマイクロインダクタ（1・4.7・10µH）。同調 3 は L が小さいので駆動を 470Ω にして Q をそろえる
for k, (xo, rv, lv, cv, f) in enumerate([('X2', '1k', '10uH', '180p', '3.66'), ('X4', '1k', '4.7uH', '100p', '7.33'),
                                         ('X8', '470', '1uH', '120p', '14.65')]):
    tk, sq, so = 'TK%d' % (k + 1), 'SQ%d' % (k + 1), 'SQO%d' % (k + 1)
    R(B, rv, xo, tk, '同調 %d（%sMHz）の駆動。Q 約 5 を決める' % (k + 1, f))
    Lx(B, lv, tk, G, '同調 %d（%sMHz）。マイクロインダクタ（Q 40 程度）、±10%% 品で可' % (k + 1, f))
    C(B, cv, tk, G, 'NP0。同調 %d（%sMHz、配線と 74HCU04 の入力を含めて）' % (k + 1, f), fp=FP_CS)
    C(B, '1000p', tk, sq, '', fp=FP_CS)
    R(B, '1M', sq, so, '自己バイアス（しきい値 = 入力の平均）')
add(B, '74xx:74HC04', '74HCU04', FP_DIP14,
    {'1': 'SQ1', '2': 'SQO1', '3': 'SQ2', '4': 'SQO2', '5': 'SQ3', '6': 'SQO3', '9': G, '8': None,
     '11': G, '10': None, '13': G, '12': None, '7': G, '14': '+5VT'},
    'アンバッファ品（必ず U 付き）。1〜3: 同調 1〜3 の後の自己バイアス増幅。4〜6 回路目は未使用')
C(B, '0.1u', '+5VT', G)
add(B, '74xx:74HC14', '74AC14', FP_DIP14,
    {'1': 'SQO3', '2': 'X8S', '3': G, '4': None, '5': G, '6': None,
     '9': G, '8': None, '11': G, '10': None, '13': G, '12': None, '7': G, '14': '+5VT'},
    '同調 3 の後の整形（シュミット）。2〜6 回路目は未使用。必ず AC 品')
C(B, '0.1u', '+5VT', G)
TP(B, 'X16', 'X16', '×16 の出力（29.3MHz、PLL の基準）の観測点')

# =====================================================================
# PLL 追従フィルタ（+5VT）2026-10-29 スプリアス対策
# =====================================================================
# ×16 の出力に VCO を位相同期させ、ループ帯域（約 37kHz）の外の側帯波を落とす。±1.83MHz で約 −77dB。
# 音声の位相変調（〜3kHz）はループ帯域の中なのでそのまま VCO に移る
B = 'PLL'
# 位相周波数比較（74AC74 の 2 個の D-FF、両方 High になったら 74AC00 でリセット）
add(B, '74xx:74HC74', '74AC74', FP_DIP14,
    {'1': 'PFD_RST', '2': '+5VT', '3': 'X16', '4': '+5VT', '5': 'PFD_UP', '6': None,
     '13': 'PFD_RST', '12': '+5VT', '11': 'VCO_CK', '10': '+5VT', '9': 'PFD_DN', '8': None, '7': G, '14': '+5VT'},
    '位相周波数比較。1 個目のクロック = ×16（基準）、2 個目 = VCO。必ず AC 品（29.3MHz）')
C(B, '0.1u', '+5VT', G)
add(B, '74xx:74HC00', '74AC00', FP_DIP14,
    {'1': 'PFD_UP', '2': 'PFD_DN', '3': 'PFD_RST', '4': G, '5': G, '6': None, '9': G, '10': G, '8': None,
     '12': G, '13': G, '11': None, '7': G, '14': '+5VT'},
    '位相比較のリセット（UP・DN が両方 High で両方の D-FF をクリア）。2〜4 回路目は未使用')
C(B, '0.1u', '+5VT', G)
# ループフィルタ（差動の能動積分、MCP6002）: τ1 = 11.2k × 10n、τ2 = 1.5k × 10n、入力 RC で 258kHz の極
R(B, '5.6k', 'PFD_UP', 'LF_P1')
C(B, '220p', 'LF_P1', G, 'PFD のパルスをならす', fp=FP_CS)
R(B, '5.6k', 'LF_P1', 'LF_NI')
R(B, '1.5k', 'LF_NI', 'LF_NIC')
C(B, '0.01u', 'LF_NIC', G, 'フィルム（または C0G）')
R(B, '5.6k', 'PFD_DN', 'LF_N1')
C(B, '220p', 'LF_N1', G, 'PFD のパルスをならす', fp=FP_CS)
R(B, '5.6k', 'LF_N1', 'LF_INV')
R(B, '1.5k', 'LF_OUT', 'LF_FBC', 'ダンピング（ζ 約 0.7）')
C(B, '0.01u', 'LF_FBC', 'LF_INV', 'フィルム（または C0G）。積分')
add(B, 'Amplifier_Operational:MCP6002-xP', 'MCP6002', FP_DIP8,
    {'3': 'LF_NI', '2': 'LF_INV', '1': 'LF_OUT', '5': G, '6': 'LF_B', '7': 'LF_B', '8': '+5VT', '4': G},
    'A: ループフィルタ（レール・ツー・レール出力 0〜5V）、B: 未使用（ボルテージフォロワで固定）')
C(B, '0.1u', '+5VT', G)
R(B, '1k', 'LF_OUT', 'VT')
C(B, '470p', 'VT', G, '339kHz の極（PFD の残りを落とす）', fp=FP_CS)
TP(B, 'VT', 'VT', 'VCO 制御電圧。29.3MHz 送信で約 2.5V になるよう TC（VCO）を調整')
# VCO: 74HCU04（VCO 専用）の 1 個目を使ったピアース（コルピッツ）型 LC 発振。1N4007 の接合容量を可変容量に使う
R(B, '1M', 'VCO_IN', 'VCO_OA', '自己バイアス')
R(B, '220', 'VCO_OA', 'VCO_O', '出力の直列抵抗（発振振幅・高調波を抑える）')
C(B, '56p', 'VCO_O', G, 'NP0', fp=FP_CS)
C(B, '0.01u', 'VCO_O', 'VCO_L', 'DC カット（受信中に入力を GND に落としても出力から電流が流れない）')
Lx(B, 'T50-6 15T', 'VCO_L', 'VCO_IN', '約 0.9µH（0.5mm 線）', fp=FP_T50)
C(B, '27p', 'VCO_IN', G, 'NP0', fp=FP_CS)
TC(B, '30p', 'VCO_IN', G, 'VCO の中心。VT が約 2.5V で 29.3MHz に')
C(B, '47p', 'VCO_IN', 'VAR_K', 'NP0。可変容量の結合（範囲 約 0.8MHz）', fp=FP_CS)
D(B, '1N4007', 'VAR_K', G, '可変容量として使う（逆バイアス 0.5〜4.5V で約 20〜9pF）。可変容量ダイオード（1SV101 など）でも可',
  sym='Diode:1N4007', fp=FP_D41)
R(B, '22k', 'VT', 'VAR_K')
# 受信中は VCO を止める（受信周波数 29.3MHz に VCO が漏れないように）
NPN(B, '2SC1815', G, 'VCO_IN', 'VCO_KB', '受信中（RX8V）に VCO の入力を GND に落として発振を止める')
R(B, '10k', 'RX8V', 'VCO_KB')
R(B, '10k', 'VCO_KB', G)
add(B, '74xx:74HC04', '74HCU04', FP_DIP14,
    {'1': 'VCO_IN', '2': 'VCO_OA', '3': 'VCO_OA', '4': 'VCO_CK', '5': 'VCO_OA', '6': 'TXOSC', '9': 'VCO_OA', '8': 'TXOSC2',
     '11': 'VCO_OA', '10': 'TXOSC3', '13': G, '12': None, '7': G, '14': '+5VT'},
    'VCO 専用（必ず U 付き）。1: 発振、2: 位相比較行きのバッファ、3〜5: 送信 RF 行きのバッファ（出力を 330Ω ずつで合わせ、駆動を強くする）、6: 未使用。'
    '受信中は 1 の入力が GND に落ち、バッファの出力は Low のまま止まる')
C(B, '0.1u', '+5VT', G)
R(B, '330', 'TXOSC2', 'TXDRV', 'VCO の出力バッファ 2 個目の直列抵抗')
R(B, '330', 'TXOSC3', 'TXDRV', 'VCO の出力バッファ 3 個目の直列抵抗')

# =====================================================================
# S メーター（受信、2026-10-29 追加）: 10.7MHz 水晶フィルタの出力 → 同調増幅 → AD8307（対数増幅）→ ADS1115（I2C）→ XIAO
# =====================================================================
# MC3361 には RSSI 出力がないので、水晶フィルタ（帯域 ±7.5kHz）の後ろで 10.7MHz の強さを測る。
# IF1 での信号は S9（−73dBm）で約 −54dBm（アンテナから約 ＋19dB）。2.2kΩ で軽く取り出し（−5dB）、増幅（約 ＋26dB）して
# AD8307 へ: S9 で約 −33dBm、測れる範囲（−75〜＋17dBm）で S2〜S9＋40 程度
B = '受信'
R(B, '2.2k', 'IF1', 'RS_IN', '取り出し。水晶フィルタの終端（MC3361 の入力）に重い負荷をかけないため')
C(B, '0.01u', 'RS_IN', 'RS_B')
R(B, '22k', 'RX8V', 'RS_B', 'S メーター増幅のベースバイアス（約 1.4V）')
R(B, '4.7k', 'RS_B', G)
NPN(B, '2SC1815', 'RS_E', 'RS_C', 'RS_B', 'S メーター用 10.7MHz 増幅（Ic 約 3mA、約 26dB）')
R(B, '27', 'RS_E', 'RS_E2', 'エミッタ帰還（バイパスしない）')
R(B, '220', 'RS_E2', G)
C(B, '0.1u', 'RS_E2', G)
Lx(B, '4.7uH', 'RX8V', 'RS_C', 'コレクタ同調（4.7µH ＋ 47p で約 10.7MHz、AD8307 の入力 1.1kΩ で Q 約 2。AD8307 に広帯域の雑音を入れない）')
C(B, '47p', 'RS_C', G, 'NP0。コレクタ同調', fp=FP_CS)
C(B, '0.01u', 'RX8V', G)
C(B, '0.01u', 'RS_C', 'RS_INP')
add(B, L + 'AD8307', 'AD8307ANZ', FP_DIP8,
    {'8': 'RS_INP', '1': 'RS_INM', '3': 'RS_OFS', '5': None, '4': 'RSSI_V', '6': 'RS_VPS', '7': 'RS_VPS', '2': G},
    '対数増幅（25mV/dB、−75〜＋17dBm）。DIP-8。+5VA（受信中だけ）。INT（5 番）は開放、ENB は VPS へ')
C(B, '0.01u', 'RS_INM', G, '負入力を交流で GND へ')
C(B, '0.01u', 'RS_OFS', G, 'オフセット補償ループの時定数（データシートの応用回路）')
R(B, '10', '+5VA', 'RS_VPS', '電源のデカップリング（データシートの応用回路）')
add(B, 'power:PWR_FLAG', 'PWR_FLAG', '', {'1': 'RS_VPS'})   # 10Ω の後ろの電源（ERC 用）
C(B, '0.1u', 'RS_VPS', G)
C(B, '0.1u', 'RSSI_V', G, '出力の平滑（出力抵抗 12.5kΩ と約 1.3ms）')
B = '制御'
add(B, L + 'ADS1115_Module', 'ADS1115 module', L + 'ADS1115_Module_Socket',
    {'1': '+3V3X', '2': G, '3': 'SCL', '4': 'SDA', '5': G, '6': None, '7': 'RSSI_V', '8': None, '9': None, '10': None},
    'I2C 16 ビット ADC（ADS1115 モジュール、Adafruit 1085 と同じピン並び）。アドレス 0x48（ADDR = GND）。A0 = S メーター。'
    'ピンソケットに差す（XIAO のピンが足りないので I2C で読む）')

# =====================================================================
# セラゾイド変調の比較とリセット（2026-10-29、MAX913・74HCT4017 の代わり）
# =====================================================================
# 比較: 2SA1015 の差動対（エミッタ共通、電流 約 2.3mA）。のこぎり波（RAMP）がしきい値（THRESH）を超えると、
# Q（RAMP 側）が切れて COMP_N が約 2.3V → 0V に下がり、74HCT123 の 1A（立ち下がりでトリガ）で PM_OUT を作る。
# 遅れ（十数 ns）は一定なので、位相のずれにはならない。トランジスタの Vbe の差は VR（しきい値の中心）で吸収する
B = 'セラゾイド変調'
R(B, '1.5k', '+5VT', 'CMP_E', '差動対の電流（約 (5 − 0.85 − 0.65) ÷ 1.5k ≒ 2.3mA）')
PNP(B, '2SA1015', 'CMP_E', 'COMP_N', 'RAMP', '比較（ベース = のこぎり波）。GR ランクの 2 個をそろえる')
PNP(B, '2SA1015', 'CMP_E', G, 'THRESH', '比較（ベース = しきい値）')
R(B, '1k', 'COMP_N', G, '負荷。RAMP < THRESH で約 2.3V、超えると 0V')
TP(B, 'COMP', 'COMP_N', 'コンパレータの出力の観測点（交点で立ち下がる）')
C(B, '22p', 'OS2_C', 'OS2_RC', 'リセットパルスの時定数（NP0）', fp=FP_CS)
R(B, '1.5k', '+5VT', 'OS2_RC', 'リセットパルス 約 50〜100ns')

# ファイナル B と入力トランス（2026-10-29、IRF510 プッシュプル）
B = '送信RF'
add(B, 'Transistor_FET:IRF540N', 'IRF510', FP_TO220, {'1': 'PA_GB', '2': 'PA_DB', '3': G},
    'ファイナル B。A と並べてケースの放熱器にねじ止め（絶縁シートと絶縁ブッシング）')
R(B, '10', 'PA_GB_IN', 'PA_GB', 'ゲートストッパー（B）')
add(B, 'Device:Transformer_1P_SS', 'BN43-202 2T:2T(CT)', L + 'Transformer_BN43-202_SS',
    {'1': 'PA_IN', '2': G, '3': 'PA_GA_IN', '4': 'PA_BIAS', '5': 'PA_GB_IN'},
    '入力トランス 1:1。1 次 2 回（ドライバから）・2 次 2 回（センタータップにバイアス）。0.4mm 線')

PREFIX = {'Device:R': 'R', 'Device:C': 'C', 'Device:C_Polarized': 'C', 'Device:C_Trim': 'TC', 'Device:L': 'L',
          'Device:R_Potentiometer_Trim': 'VR', 'Device:Crystal': 'X', 'Device:Transformer_1P_1S': 'T',
          'Device:Transformer_SP_1S': 'T', 'Device:Transformer_1P_SS': 'T',
          'Connector:TestPoint': 'TP', 'power:PWR_FLAG': '#FLG', 'Relay:G5V-2': 'K',
          'Jumper:SolderJumper_3_Bridged12': 'JP'}
def prefix(p):
    s = p['sym']
    if s in PREFIX: return PREFIX[s]
    if s.startswith('Connector_Generic'): return 'J'
    if s.startswith('Diode:') or s == 'Device:D': return 'D'
    if s.startswith('Transistor') or 'RD_MOSFET' in s: return 'Q'
    if s.endswith('L_Tap'): return 'L'
    if s.endswith('Filter_3pin'): return 'FL'
    return 'U'

# 部品番号の振り直し（2026-10-29、tools/renumber.py）: 出現順の仮の番号 → 回路図の位置順の番号
RENUMBER = {'C1': 'C2', 'C2': 'C6', 'C3': 'C12', 'C4': 'C21', 'C5': 'C24', 'C6': 'C5', 'C7': 'C15', 'C8': 'C17', 'C9': 'C19', 'C10': 'C28', 'C11': 'C34', 'C12': 'C35', 'C13': 'C37', 'C14': 'C53', 'C15': 'C73', 'C16': 'C72', 'C18': 'C81', 'C19': 'C79', 'C21': 'C83', 'C22': 'C86', 'C24': 'C91', 'C25': 'C111', 'C26': 'C92', 'C27': 'C112', 'C28': 'C97', 'C29': 'C101', 'C31': 'C62', 'C32': 'C74', 'C33': 'C70', 'C34': 'C71', 'C35': 'C75', 'C36': 'C76', 'C37': 'C78', 'C38': 'C77', 'C39': 'C80', 'C40': 'C82', 'C41': 'C85', 'C42': 'C87', 'C43': 'C88', 'C44': 'C89', 'C45': 'C90', 'C46': 'C93', 'C47': 'C94', 'C48': 'C95', 'C49': 'C96', 'C50': 'C98', 'C51': 'C99', 'C52': 'C100', 'C53': 'C106', 'C54': 'C108', 'C55': 'C109', 'C56': 'C110', 'C57': 'C114', 'C59': 'C115', 'C60': 'C116', 'C61': 'C118', 'C62': 'C120', 'C63': 'C121', 'C64': 'C122', 'C65': 'C123', 'C66': 'C124', 'C67': 'C4', 'C68': 'C9', 'C69': 'C11', 'C70': 'C29', 'C71': 'C31', 'C72': 'C32', 'C73': 'C42', 'C74': 'C41', 'C75': 'C33', 'C76': 'C51', 'C77': 'C52', 'C78': 'C49', 'C79': 'C50', 'C80': 'C56', 'C81': 'C59', 'C82': 'C60', 'C83': 'C66', 'C84': 'C61', 'C85': 'C64', 'C86': 'C67', 'C87': 'C69', 'C88': 'C3', 'C89': 'C7', 'C90': 'C58', 'C91': 'C57', 'C92': 'C65', 'C93': 'C63', 'C94': 'C68', 'C95': 'C43', 'C96': 'C46', 'C97': 'C45', 'C98': 'C47', 'C99': 'C102', 'C100': 'C104', 'C101': 'C117', 'C102': 'C119', 'C104': 'C105', 'C105': 'C107', 'C106': 'C113', 'C107': 'C1', 'C108': 'C10', 'C109': 'C13', 'C110': 'C20', 'C111': 'C14', 'C112': 'C25', 'C113': 'C16', 'C114': 'C36', 'C115': 'C55', 'C116': 'C54', 'C117': 'C48', 'C118': 'C44', 'C119': 'C39', 'C120': 'C8', 'C121': 'C18', 'C122': 'C23', 'C123': 'C22', 'C124': 'C26', 'C125': 'C27', 'C126': 'C30', 'C127': 'C38', 'C128': 'C40', 'C129': 'C84', 'D2': 'D5', 'D3': 'D8', 'D4': 'D11', 'D5': 'D12', 'D6': 'D9', 'D7': 'D10', 'D8': 'D13', 'D9': 'D2', 'D10': 'D3', 'D11': 'D6', 'D12': 'D7', 'D13': 'D4', 'J4': 'J5', 'J5': 'J8', 'J6': 'J9', 'J8': 'J4', 'J9': 'J6', 'L1': 'L2', 'L2': 'L7', 'L3': 'L8', 'L4': 'L9', 'L5': 'L10', 'L7': 'L13', 'L8': 'L15', 'L9': 'L16', 'L10': 'L1', 'L11': 'L4', 'L12': 'L5', 'L13': 'L11', 'L15': 'L12', 'L16': 'L6', 'L17': 'L3', 'Q1': 'Q6', 'Q2': 'Q8', 'Q3': 'Q7', 'Q4': 'Q11', 'Q5': 'Q12', 'Q6': 'Q14', 'Q7': 'Q2', 'Q8': 'Q5', 'Q9': 'Q3', 'Q10': 'Q4', 'Q11': 'Q1', 'Q12': 'Q9', 'Q13': 'Q10', 'Q14': 'Q13', 'R1': 'R32', 'R2': 'R34', 'R3': 'R29', 'R4': 'R47', 'R5': 'R48', 'R6': 'R35', 'R7': 'R27', 'R8': 'R50', 'R9': 'R52', 'R10': 'R59', 'R11': 'R64', 'R12': 'R69', 'R13': 'R70', 'R14': 'R68', 'R15': 'R76', 'R17': 'R78', 'R18': 'R97', 'R19': 'R79', 'R20': 'R98', 'R21': 'R43', 'R22': 'R57', 'R23': 'R58', 'R24': 'R55', 'R25': 'R56', 'R26': 'R60', 'R27': 'R61', 'R28': 'R63', 'R29': 'R62', 'R30': 'R65', 'R31': 'R66', 'R32': 'R67', 'R33': 'R71', 'R34': 'R72', 'R35': 'R80', 'R36': 'R77', 'R37': 'R81', 'R38': 'R82', 'R39': 'R84', 'R40': 'R83', 'R41': 'R86', 'R42': 'R85', 'R43': 'R96', 'R44': 'R94', 'R45': 'R93', 'R46': 'R92', 'R47': 'R89', 'R48': 'R101', 'R49': 'R102', 'R50': 'R103', 'R51': 'R10', 'R52': 'R12', 'R53': 'R14', 'R54': 'R13', 'R55': 'R16', 'R56': 'R31', 'R57': 'R37', 'R58': 'R41', 'R59': 'R40', 'R60': 'R42', 'R61': 'R49', 'R62': 'R38', 'R63': 'R33', 'R64': 'R39', 'R65': 'R46', 'R66': 'R51', 'R67': 'R53', 'R68': 'R54', 'R69': 'R20', 'R70': 'R21', 'R71': 'R22', 'R72': 'R24', 'R73': 'R25', 'R74': 'R23', 'R75': 'R87', 'R76': 'R90', 'R77': 'R99', 'R78': 'R100', 'R79': 'R88', 'R80': 'R91', 'R81': 'R2', 'R82': 'R8', 'R83': 'R11', 'R84': 'R3', 'R85': 'R9', 'R86': 'R15', 'R87': 'R18', 'R88': 'R30', 'R89': 'R36', 'R90': 'R19', 'R91': 'R26', 'R92': 'R28', 'R93': 'R44', 'R94': 'R45', 'R95': 'R1', 'R96': 'R4', 'R97': 'R5', 'R98': 'R6', 'R99': 'R7', 'R100': 'R17', 'R101': 'R74', 'R102': 'R73', 'R103': 'R75', 'R104': 'R95', 'T1': 'T2', 'T2': 'T1', 'TC1': 'TC4', 'TC2': 'TC5', 'TC3': 'TC1', 'TC4': 'TC2', 'TC5': 'TC3', 'TP1': 'TP3', 'TP2': 'TP4', 'TP3': 'TP6', 'TP4': 'TP2', 'TP5': 'TP7', 'TP6': 'TP1', 'TP7': 'TP5', 'U1': 'U5', 'U2': 'U4', 'U3': 'U6', 'U4': 'U8', 'U5': 'U15', 'U6': 'U11', 'U9': 'U19', 'U10': 'U20', 'U11': 'U21', 'U13': 'U18', 'U14': 'U10', 'U15': 'U14', 'U16': 'U17', 'U17': 'U2', 'U18': 'U16', 'U19': 'U22', 'U20': 'U23', 'U21': 'U1', 'U22': 'U3', 'U23': 'U7', 'U24': 'U12', 'U25': 'U9', 'U26': 'U13', 'VR1': 'VR2', 'VR2': 'VR5', 'VR3': 'VR1', 'VR4': 'VR3', 'VR5': 'VR4'}

def numbered():
    cnt = {}
    for p in parts:
        k = prefix(p); cnt[k] = cnt.get(k, 0) + 1
        p['ref'] = '%s%d' % (k, cnt[k]) if not k.startswith('#') else '%s0%d' % (k, cnt[k])
        p['ref'] = RENUMBER.get(p['ref'], p['ref'])
    parts[:] = [p for p in parts if not p.get('removed')]
    return parts

numbered()

if __name__ == '__main__':
    import collections
    nets = collections.defaultdict(list)
    for p in parts:
        for k, n in p['pins'].items():
            if n: nets[n].append(p['ref'] + '.' + k)
    print(len(parts), 'parts', len(nets), 'nets')
    for n, v in sorted(nets.items()):
        if len(v) < 2: print('SINGLE', n, v)

# =====================================================================
# 回路図での位置（手で決めた部品）: 部品番号（多ユニットは '番号:ユニット'）→ (x, y, 角度)。
# 座標はそのブロックの区画（A3、左上 (20, 22)）での mm。ここにない部品は gen_sch.py が自動で置く。
# 部品番号は回路一覧の並びで決まるので、部品を足したり並べ替えたりしたらここも見直す。
# =====================================================================
g = 2.54
LAYOUT = {
    # ---- 電源: 左の DC 入力から +13V8 の幹線（y=60.96）を右へ。上の段 DC-DC 5V → LP2950 3.3V、下の段 L7808 → L7805
    'J1': (40.64, 60.96, 180),
    '#FLG01': (63.5, 53.34, 0),
    'D1': (55.88, 68.58, 270),
    'C2': (63.5, 68.58, 0),
    'C6': (71.12, 68.58, 0),
    '#FLG02': (40.64, 76.2, 0),
    'L2': (86.36, 40.64, 90),
    'C12': (96.52, 48.26, 0),
    '#FLG03': (96.52, 33.02, 0),
    'U5': (114.3, 40.64, 0),
    'C21': (127.0, 48.26, 0),
    'C24': (134.62, 48.26, 0),
    'U8': (152.4, 40.64, 0),
    'C35': (167.64, 48.26, 0),
    'C37': (175.26, 48.26, 0),
    'C5': (78.74, 88.9, 0),
    'U4': (93.98, 81.28, 0),
    'C15': (106.68, 88.9, 0),
    'C17': (114.3, 88.9, 0),
    'C19': (121.92, 88.9, 0),
    'U6': (132.08, 81.28, 0),
    'C28': (144.78, 88.9, 0),
    'C34': (152.4, 88.9, 0),
    # ---- セラゾイド変調: 左 CLK0 → 4017 → 2N7000（放電）、中央 定電流源とのこぎり波（RAMP の線 y=63.5）、右 MAX913 → 74HCT123
    'R64': (40.64, 76.2, 90),
    'R68': (88.9, 76.2, 90),
    'Q7': (101.6, 76.2, 0),       # 2N7000（G 96.52,76.2、D 104.14,71.12）
    'R69': (111.76, 27.94, 0),    # 定電流源: +5VT → R69 → VR2 → 2SA1015 のエミッタ
    'VR2': (111.76, 38.1, 0),
    'Q8': (114.3, 50.8, 180),     # 2SA1015（E 111.76,45.72、C 111.76,55.88、B 119.38,50.8）
    'D11': (127.0, 30.48, 90),     # ベースの基準（ダイオード 2 本）
    'D12': (127.0, 40.64, 90),
    'C81': (134.62, 38.1, 0),
    'R70': (127.0, 55.88, 0),
    'C79': (111.76, 71.12, 0),    # のこぎり波の C
    'TP3': (121.92, 58.42, 0),
    'TP4': (137.16, 76.2, 0),
    'R76': (182.88, 40.64, 0),    # ワンショットの時定数
    'VR5': (182.88, 50.8, 0),
    'C83': (172.72, 58.42, 180),
    'U19:1': (190.5, 71.12, 0),    # 74HCT123（B 177.8,76.2、Q 203.2,66.04）
    'TP6': (213.36, 58.42, 0),
    'U19:2': (190.5, 109.22, 0),   # 使わない 2 回路目
    'U19:3': (226.06, 106.68, 0),
    'C86': (238.76, 106.68, 0),
    # ---- 送信音声: 左のマイクから右へ A マイクアンプ → B 利得段 → IDC → C 3kHz LPF → D しきい値（出力 THRESH）
    #      各段の帰還は上、VREF（2.5V）に落ちる部品は下
    'J7': (27.94, 88.9, 180),     # MIC（1 MIC 91.44、2 PTT 88.9、3 GND 86.36）
    'R55': (40.64, 66.04, 0), 'C70': (48.26, 76.2, 0), 'R56': (40.64, 81.28, 0),
    'C71': (55.88, 91.44, 90), 'R60': (71.12, 91.44, 90),
    'U18:1': (91.44, 88.9, 0), 'R61': (91.44, 76.2, 90), 'C75': (91.44, 68.58, 90),
    'C76': (106.68, 88.9, 90), 'VR1': (114.3, 96.52, 0),
    'U18:2': (137.16, 88.9, 0), 'R63': (137.16, 76.2, 90), 'R62': (127.0, 99.06, 0),
    'R65': (152.4, 88.9, 90), 'D9': (160.02, 96.52, 90), 'D10': (167.64, 96.52, 270),
    'R66': (175.26, 88.9, 90), 'R67': (190.5, 88.9, 90),
    'U18:3': (210.82, 91.44, 0), 'C78': (198.12, 76.2, 90), 'C77': (195.58, 99.06, 0),
    'C80': (226.06, 91.44, 90), 'VR3': (233.68, 99.06, 0), 'R71': (248.92, 99.06, 90),
    'VR4': (243.84, 71.12, 0), 'C82': (254.0, 78.74, 0), 'R72': (254.0, 63.5, 90),
    'U18:4': (269.24, 91.44, 0),
    'R57': (60.96, 104.14, 0), 'R58': (60.96, 116.84, 0), 'C74': (68.58, 116.84, 0),   # VREF
    'U18:5': (284.48, 119.38, 0), 'C85': (294.64, 119.38, 0),
    # ---- 送信RF: 左から BPF（2 段）→ 2N2222A → IRF510 → IRF510 × 2 → トランス → 7 次 LPF → 出力検出
    #      バイアス・スワンプは各段の下、ドレインチョーク・パスコンは上
    'L7': (35.56, 86.36, 0), 'C87': (45.72, 86.36, 0), 'TC4': (53.34, 86.36, 0),
    'C88': (60.96, 81.28, 90),
    'C89': (68.58, 86.36, 0), 'TC5': (76.2, 86.36, 0), 'L8': (83.82, 86.36, 0),
    'C90': (96.52, 87.63, 90),
    'Q11': (111.76, 87.63, 0), 'R80': (104.14, 76.2, 0), 'R77': (104.14, 99.06, 0),
    'R81': (114.3, 99.06, 0), 'R82': (114.3, 111.76, 0), 'C93': (121.92, 111.76, 0),
    'L9': (114.3, 71.12, 0), 'C94': (121.92, 63.5, 0),
    'C95': (124.46, 82.55, 90),
    'R83': (129.54, 91.44, 0), 'C96': (129.54, 104.14, 0),
    'R85': (139.7, 91.44, 180), 'R86': (147.32, 96.52, 0), 'VR6': (147.32, 109.22, 0), 'C98': (157.48, 116.84, 0),
    'R84': (142.24, 82.55, 90),
    'Q12': (156.21, 82.55, 0), 'L10': (158.75, 66.04, 0), 'C99': (166.37, 58.42, 0),
    'C100': (167.64, 72.39, 90),
    'R94': (175.26, 81.28, 0), 'R93': (180.34, 81.28, 0), 'C106': (177.8, 96.52, 0),
    'R89': (185.42, 81.28, 180), 'R92': (190.5, 86.36, 0), 'VR7': (190.5, 99.06, 0), 'C108': (200.66, 106.68, 0),
    'R96': (187.96, 72.39, 90),
    'Q14': (201.93, 72.39, 0),
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
    'C115:1': (276.86, 78.74, 0),
    'C116:1': (292.1, 78.74, 0),
    'C118:1': (307.34, 78.74, 0),
    'C120:1': (322.58, 78.74, 0),
    'C121:1': (330.2, 81.28, 0),
    'C122:1': (330.2, 96.52, 0),
    'C123:1': (355.6, 96.52, 0),
    'C124:1': (374.65, 96.52, 0),
    'D13:1': (345.44, 88.9, 180),
    'L13:1': (284.48, 73.66, 90),
    'L15:1': (299.72, 73.66, 90),
    'L16:1': (314.96, 73.66, 90),
    'R102:1': (363.22, 96.52, 0),
    'R103:1': (369.57, 88.9, 90),
    'R101:1': (337.82, 96.52, 0),
    'T1:1': (195.58, 76.2, 0),
    'R96:1': (213.36, 83.82, 90),
    'R95:1': (213.36, 68.58, 90),
    'R94:1': (205.74, 91.44, 0),
    'R93:1': (205.74, 60.96, 0),
    'C106:1': (200.66, 99.06, 0),
    'R89:1': (193.04, 104.14, 90),
    'Q14:1': (226.06, 88.9, 0),
    'Q13:1': (226.06, 60.96, 0),
    'T2:1': (254.0, 73.66, 0),
})
