kazushinjo/Serrasoid_TRX_29M/(commit log)

2026-10-14 初版: セラゾイド変調 29MHz FM 10W トランシーバの設計概要
2026-10-14 回路図 Ver 1.0: セラゾイド変調・逓倍・送信 RF・受信・制御・電源（244 点）
    - tools/circuit.py に部品と接続をまとめ、gen_sch.py で回路図、gen_bom.py で部品表を生成
    - 独自記号（SA612・MC3361・3 端子フィルタ・タップ付きコイル・電源記号）と
    PSN_TRX から流用したフットプリントを kicad/Serrasoid_TRX.* に収録
    - ERC エラー・警告 0、回路図ネットと circuit.py の 640 ピンを照合して一致
    - README を回路に合わせて更新（PM のまま送信する理由、2N3866・2N3819、電源系統、XIAO ピン表）
2026-10-14 回路図を 1 枚（A0）で線による結線に作り直し、表面実装部品をなくす
    - ブロックごとに枠で囲み、ブロック内・ブロック間とも線で結線（電源は電源記号）
    - コンパレータを TLV3501（SOIC）から MAX913CPA（DIP-8）へ、SHDN はんだジャンパをジャンパピンに
    - ERC 違反なし、circuit.py との接続照合 640 ピン一致（tools/verify_sch.py）
    - 基板生成スクリプト（配線長を短くする配置 place.py、Freerouting 用 route.sh）を追加。基板は未完成
2026-10-15 回路図の論理チェック（第 1 回）: 9 件修正
    - リレー駆動のベース抵抗 4.7k → 1k、MAX913 の LE を GND 固定（ジャンパ廃止）
    - ワンショットを 74HCT123 に（MAX913 の TTL 出力を受ける）
    - 逓倍の遅延を入力周期の 1/4 に直し、RC の後に 74AC14 で整形
    - 2N3866 のバイアスを 560/120Ω、出力トランスを 2T:5T（約 8Ω）
    - 2N3819 のドレインをチョーク給電、MC3361 周辺をデータシートの試験回路どおりに
    - 結果と実物で確認が必要な項目を docs/回路図論理チェック.md に記載
2026-10-15 基板 Ver 1.0（配置・配線）と基板チェック（第 1 回）
    - 170×130mm 4 層（内層 2 枚 GND）、242 点すべてリード部品
    - 機能ブロックの区画内で配線長が短くなるよう自動配置、Freerouting 1.9.0 で配線
    - DRC エラー 0、未接続 0、回路図との食い違い 0（警告はシルクのみ）
    - 長い線・RD16HHF1 の取付・レギュレータの放熱などを docs/基板チェック.md に記載
2026-10-15 Freerouting のログフォルダを除外
2026-10-15 route.sh の既定を ~/tools/freerouting-1.9.jar に
2026-10-15 回路図: 電源もすべて線で結線（ネットラベル 0）
    - +13V8・+8V・+5V・+5VT・+5VA・+3V3S・+3V3X・TX8V・RX8V をブロック内・ブロック間とも線で結ぶ
    - 電源の名前は出どころ（レギュレータの出力・コネクタ）に電源記号を 1 つだけ置いて示す。GND は GND 記号
    - ブロック間の線が別の線の途中から分岐するときの接続点の抜けを修正
    - ERC 違反なし、接続照合 655 ピン一致、基板（f53db31）との食い違いなし
2026-10-15 回路図の見た目を整理: 部品の向きと信号の流れで並べる
    - GND・電源に落ちる部品は縦（GND が下、電源が上）、信号の通り道の部品は横に置く
    - ブロックの入力から信号をたどった順に左から右へ列を作り、区画の幅で折り返す
    - パスコンは直前の部品（IC・レギュレータ）の列の下に、レギュレータは 1 個ずつ列を持つ
    - 配線の評価で曲がり（6）と交差（12）を重くした
    - 線を引けないときは用紙・間隔を変えて置き直す。ピンの出口をふさいでいた丸め誤差を修正
    - ERC 違反なし、接続照合 655 ピン一致、ラベル 0、基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
2026-10-15 回路図: 全ブロックの部品配置を手で決めて信号の流れどおりに並べる（A1 一枚）
    - circuit.py に LAYOUT（部品番号 → 回路図の位置・向き）を追加し、gen_sch.py はそこを固定して残りだけ自動で置く
    - 電源: DC 入力 → +13V8 の幹線 → 上の段 DC-DC・LP2950、下の段 L7808・L7805
    - 制御: 中央に XIAO、左にエンコーダ・I2C・表示器とプルアップ、右に PTT・リレー駆動・リレー
    - 変調・逓倍・送信音声・送信RF・受信: 信号を左から右へ一列（逓倍は 5 段を同じ形で）
    - RD06HHF1/RD16HHF1 の記号を上下反転（ドレイン上・ソース下）
    - 電源名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
2026-10-15 回路図: KiCad で手直しした部品の位置を LAYOUT に取り込み、線を引き直す
    - 10/16 02:19 に KiCad で保存された回路図から 270 個の位置・向きを取り込み（動かした部品 43 個）
    - その回路図で切れていた L1 の +13V8 側と、TX8V と PA_D（RD16HHF1 のドレイン）のショートは、線の引き直しで解消
    - 手で決めた位置は 1.27mm 刻みのまま使う（2.54mm に丸めていたのを修正）
    - ピンの端どうしが重なっている所は線なしの接続として扱う。線の端から同じ向きに延ばせるようにした
    - R43 をゲートのピンと端が重なる位置に（KiCad では 1.27mm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
2026-10-15 回路図: KiCad での手修正（部品 26 個の移動と線）を確認して取り込む
    - 手修正版を確認: ERC 0、circuit.py との接続照合 655 ピン一致、部品・値・フットプリントの変更なし、
    T 字の接続点の抜けなし、記号の上を通る線なし、記号の重なりなし
    - プロジェクト設定に PSN_TRX の回路図 ID が残っていて、KiCad が部品の登録先をそれに書き換えていたため、
    基板との照合が 199 件食い違っていた。回路図の ID にそろえて解消（基板: エラー 0・未接続 0・食い違い 0）
    - 動かした 26 個の位置を circuit.py の LAYOUT に取り込み（tools/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
2026-10-15 資料: セラゾイド変調部の動作説明（docx）を追加
    - 信号の流れ、基準クロック、のこぎり波、しきい値と音声、コンパレータによるパルス位置変調、
    ワンショット、XOR 逓倍 ×32、偏移の計算と PM＝プリエンファシス付き FM、調整手順、注意点
    - 図 3 枚（信号の流れ・のこぎり波としきい値の波形・XOR 逓倍の波形）を docs/images に、
    作成スクリプトを docs/tools に収録
2026-10-15 回路図の論理チェック（第 2 回）: 2 件修正し、基板を作り直す
    - XIAO の D0（GPIO2、起動時に High が必要）からエンコーダ B 相を外し、D0 = PTT、D8 = エンコーダ B 相に
    - SA612 の局発入力を範囲（200〜300mVp-p）の中央に: R54 1k → 1.2kΩ（約 0.25Vp-p）
    - C58 は積層セラミック（約 1.6Arms）と部品表に明記
    - PTT・エンコーダ周りの回路図の配置を、ピンの入れ替えに合わせて手で置き直す
    - 回路図: ERC 違反なし、接続照合 655 ピン一致。基板: 配置・配線をやり直し DRC エラー 0・未接続 0・食い違い 0
    - 結果を docs/回路図論理チェック.md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
2026-10-15 資料: 「エッジの時刻のずれ」を「タイミングのズレ」に統一
    - 本文 5 か所と図 2 枚の表記を変更（交点の時刻 → 交点のタイミング）
2026-10-15 資料: 基板の部品実装図（ブロック別 8 ページ）と A3 部品配置図を追加
    - docs/Serrasoid_TRX_部品実装図.pdf: 全体図と、ブロックごと（組立順の目安）の強調図・部品表（値・種類・極性の注意）
    - kicad/Serrasoid_TRX_部品配置図.pdf: A3 1 枚（F.Fab、タイトル欄入り）
    - docs/tools/: PSN_TRX の生成スクリプトを元にした作図スクリプト（部品表は tools/circuit.py から作る）
2026-10-15 ケース: OpenSCAD モデルを追加（終段の放熱器をケース内に立て、フィンを後面の窓から出す）
    - enclosure/serrasoid_trx_case.scad: PSN_TRX のケースが元。W200×D175×H50、上面操作、前後パネル差し込み式
    - RD16HHF1 のタブを市販の放熱器（仮 50×30、ベース 4・フィン 18）に直付けし、後面パネルの窓から外へ出す
    - 基板の背の高い部品 13 点とふた裏・後面の部品、放熱器の干渉を assert で確認
    - STL 5 点、前後パネルの穴あけ図（DXF/SVG）、プレビュー画像、README（放熱器の選び方・要実測の寸法）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
2026-10-15 ケース: 上面に内蔵スピーカー（φ40・8Ω）を追加、PSN_TRX 最終版の薄肉部も反映
    - ふたの手前中央にスピーカーのグリル、押さえリング（mode 10、ふたの上から M3 皿ねじ 2 本）
    - SP ジャックはスイッチ付きの外部スピーカー用（EXT SP）に。LCD を 9mm 奥へ
    - PSN_TRX と同じく、EXT SP ジャックの周り（ふた）と DC ジャックの周り（後面）を板厚 1.8mm に
    - スピーカーと基板の部品・つまみ・LCD・前面パネルとの干渉を assert で確認
2026-10-15 ケース: 内蔵スピーカーを PSN_TRX 最終版（0685f03）と同じ秋月 116024 に
    - 5cm 角 8Ω をふた裏に密着させ、M3 皿ねじ＋ナット 4 本で留める（押さえリング mode 10 は廃止）
    - 放音穴は φ2.5・4.5mm ピッチ・直径 35mm（PSN と同じ）、EXT SP ジャックは MJ-352W-C（ブレーク接点で内蔵を切る）
    - スピーカーの場所を空けるため LCD をさらに 8mm 奥へ
    - 前面パネル・LCD・ベゼル・EXT SP・TUNE・基板の部品との干渉を assert で確認、ふたの STL とプレビューを再出力
2026-10-15 資料: 部品実装図のスクリプトに PSN_TRX 最終版（300b347）の変更を反映（Windows のフォント、U5 (XIAO) 表記）
2026-10-15 ケース: 内蔵スピーカーを PSN_TRX と同じ位置（LCD の奥、通風スロットの左）に
    - スピーカー中心 X80・Y130、LCD を元の位置（Y71）に戻す
    - スピーカーのコーンをよけるため、後面のヒューズホルダを右端（X176、電源スイッチの奥）へ
    - 通風スロットはスピーカーの右（X108〜165）
    - 後面の部品・ボス・LCD・ベゼルとスピーカーの干渉を assert で確認、ふた・後面パネルの STL と図を再出力
2026-10-15 部品番号を回路図の位置順に振り直す（PSN_TRX 2026-10-15 と同じ方法）
    - 種類ごとに回路図の X の小さい順、同じ X は Y の順（多ユニットは最も小さいユニットの位置）。242 点のうち 206 点が変更
    - tools/renumber.py: 回路図・基板の部品番号と、番号から作る UUID、基板のネット名（Net-(C23-Pad1) など 140 個）を書き換え、
    circuit.py の RENUMBER（仮の番号 → 最終の番号）・LAYOUT・注記、資料・ケースの番号も置き換える
    - 新旧の対応表 kicad/refdes_map_2026-10-16.csv。チェックの記録（回路図論理チェック・基板チェック）は旧番号のま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
2026-10-15 ケース上面: TX ランプを PSN_TRX と同じく MIC の左 30mm（MIC と同じ高さ）に
    - MIC を X35→50、EXT SP を X70→85 へずらして TX（X20）の場所を空ける
    - TX の文字は MIC・EXT SP と同じ高さ、TX と MIC・ふたの縁の間隔を assert で確認
    - ふたの STL とプレビューを再出力
2026-10-15 購入用部品表を追加（PSN_TRX と同じ列: 購入先・型番・秋月の販売コード・入数・価格）
    - tools/make_bom_purchase.py → kicad/bom_purchase.csv（UTF-8 BOM 付き）。購入する品は値・種類・注記（NP0・500V・積層）で決め、部品番号に依らない
    - 秋月電子の通販サイトで 2026-10-16 に確認: 111 行のうち 82 行は秋月、21 行は秋月に扱いがなく要確認（74AC/HCT ロジック・MAX913・MC3361・SA612・RD06/RD16・水晶とフィルタ・G5V-2・500V C0G など）
    - 回路図に載っていない部品（IC ソケット・放熱器・パネル部品・スピーカー・LCD など）22 行
    - BOM.md の各表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
2026-10-16 受信の第 1 混合を SA612AN（製造中止）から NJM2594V に変更し、10.7MHz 増幅を追加（回路図・基板 Ver 1.1）
    - U13 NJM2594V（秋月 111195、SSOP8 0.65mm）: データシートの応用回路（エミッタフォロワ出力）どおり。
    5 番 信号、6 番 バイパス、7 番 局発（R41 1.2k / R45 100Ω で約 106mVrms）、3 番 出力（R48 1k）、2・8 番 開放
    この機械で唯一の表面実装部品（ユーザーが了承）。gen_pcb.py は NJM2594V 以外の表面実装で止まる
    - 変換利得 0dB（SA612 は約 +14dB）を 10.7MHz 増幅（Q6 2SC1815、約 20dB）で補う。計算は docs/回路図論理チェック.md の追補
    - 部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
2026-10-28 スプリアス対策: 逓倍を ×16 にし、段間同調と PLL 追従フィルタを追加（回路図・基板 Ver 1.2）
    Ver 1.1（915.625kHz × 32、段間に同調なし）は計算でアンテナ端 −13.5dBc（27.47MHz）の側帯波が出て、
    規格（30MHz 以下: 50mW 以下かつ −50dBc）を満たさなかった。次の 3 つを入れ、計算では最悪 −99dBc。
    - 逓倍数を減らす: CLK0 18.3125MHz ÷10 = 1.83125MHz、×16（4 段）。C71 68p、ワンショット 2.2k＋VR 5k（273ns）
    - 段間同調: 段 1〜3 の後に LC 並列共振（10µH/180p・4.7µH/100p・1µH/120p、Q 約 5、調整なし）
    → 74HCU04 自己バイアス → 74AC14
    - PLL（新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
2026-10-28 送信スプリアス 0〜300MHz の図（Ver 1.2、計算値）と計算スクリプトを追加
    - docs/images/spurious_calc_0-300MHz.png: 10W・アンテナ端。逓倍のずれによる側帯波（部品のばらつき 200 通りの最悪値、
    PLL・送信 BPF・7 次 LPF 後）は最悪 31.13MHz −59dBm（−99dBc）。高調波は PA の値を仮定し LPF を掛けたもの（2 倍 −32dBm）。
    規格 −10dBm（50mW 以下かつ −50dBc）。実測ではない
    - docs/tools/spur/: make_spurious_plot.py（作図）、spur_v12.py（Ver 1.2 の逓倍・段間同調・PLL の計算）、
    spur_v11.py（BPF・LPF のモデルと対策前の逓倍の計算）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
2026-10-28 スケッチを追加（Nextion / TJC 両対応、アナログ S メーター、周波数スキャン）
    - firmware/Serrasoid_TRX/Serrasoid_TRX.ino（XIAO ESP32C3、コンパイル確認のみ・実機未確認）
    - Si5351: CLK0 = 送信周波数 × 10 ÷ 16（送信中だけ）、CLK1 = 受信周波数 − 10.7MHz（受信中だけ）
    - PTT: 局発を止める → リレー → 15ms → 変調基準。29.000〜29.700MHz の外では送信しない
    - 操作: ダイヤル = 周波数、押す = メニュー（STEP / SQL / SCAN / EXIT）、長押し = 呼出 29.300MHz
    - スキャン: 10kHz ずつ、スケルチが開いたら止まり、信号が消えて 3 秒で再開
    - S メータ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
2026-10-28 S メーターを追加（AD8307 対数増幅 ＋ ADS1115 モジュール）、基板 170 × 150mm
    MC3361 に RSSI 出力がなく、ノイズの減り方からの S 表示は S5 前後で頭打ちだったため。
    - 受信: IF1（10.7MHz 水晶フィルタの出力）→ R1 2.2k → Q1 2SC1815 同調増幅（L3 4.7µH・C23 47p、約 26dB）
    → U9 AD8307ANZ（DIP-8、25mV/dB、+5VA）→ RSSI_V。計算で S9 ≒ 1.27V、S2〜S9＋40 程度
    - 制御: U13 ADS1115 モジュール（Adafruit 1085 と同じピン並び、I2C 0x48、A0）。XIAO の空きピンがないため I2C で読む
    - 記号 AD8307・ADS1115_Module と、モジュールの外形まで取ったフットプリント AD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
2026-10-28 README に詳細な仕様・組み立て方・調整・ライセンス・クレジットを記載、購入用部品表に在庫・品番を追記、ケースのプレビュー更新
    - README: 仕様（送信・受信・制御と表示・電源と外形、すべて設計値・計算値）、組み立て方 7 段階
    （部品・基板・はんだ付けとコイルの巻き方・スケッチ・LCD 画面・調整 12 項目・ケース）、
    ライセンス（GPL-3.0、第三者のライブラリ・フォント・商標・無保証）、クレジット（セラゾイド変調の考案者
    James R. Day / REL、Electronics 1948 年 10 月号、US 2,566,826、PSN_TRX、使ったツール）
    -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
2026-10-28 製造データ（ガーバー）を出力（基板 Ver 1.2、170 × 150mm、4 層）
    - kicad/production/Serrasoid_TRX_Gerber_JLCPCB.zip: ガーバー 11 層（銅箔 4・マスク・ペースト・シルク表裏・外形）
    ＋ドリル（PTH 916 穴・NPTH 2 穴、Excellon mm）＋ジョブファイル。内層は In1_Cu・In2_Cu に改名して出力
    - JLCPCB_提出資料.md: 発注の指定（4 層・1.6mm・最小穴 0.4mm・最小線幅 0.3mm・実装なし）・ファイル一覧・出し直し手順
    - preview/: 部品面・はんだ面の 3D 画像。gerbers/: 個別ファイルとドリル位置図
    - README: 基板を作る・状態の欄を更新
    - 元データは DRC エラー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
2026-10-28 クレジットを変更
2026-10-28 README に動作原理を記載
    セラゾイド変調（のこぎり波としきい値の交点で位相を変える）、PM と FM の関係（積分器を入れない理由）、
    XOR 逓倍で周波数と位相が 16 倍になること、段間同調でデューティをそろえること、PLL 追従フィルタ、
    電力増幅、ダブルスーパーの受信、ノイズスケルチと AD8307 の S メーター、周波数の決め方と送受切替・スキャン。
    説明図（のこぎり波・XOR 逓倍・スプリアスの計算図）へのリンク付き。
2026-10-28 入手しにくい部品を置き換え（74HCT4017・MAX913・2N3866）
    - 74HCT4017（製造中止）: 外して、Si5351 の CLK0 を 1.83125MHz（送信周波数 ÷ 16）に。リセットパルスは
    74HCT123 の 2 回路目（CLK0 の立ち上がり、22p・1.5k で約 50〜100ns）で作る。スケッチも ÷16 に変更
    - MAX913（入手難）: 2SA1015 2 個の差動対（電流 約 2.3mA、負荷 1k）に。COMP_N の立ち下がりで 74HCT123 の 1 回路目をトリガ
    - 2N3866（製造中止）: 2N2222A（TO-92）に。エミッタ帰還 4.7Ω ＋ 18Ω で約 33mA
    - 基板を配置・配線し直し（極小配線の重なりによるショートを除去して引き直し）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
2026-10-28 終段を IRF510 プッシュプルに変更（RD06HHF1・RD16HHF1 は製造終了）
    - ドライバ: RD06HHF1 → IRF510（回路はそのまま、ピンは G-D-S に。アイドル 約 150mA）
    - ファイナル: RD16HHF1 → IRF510 × 2 の AB 級プッシュプル。入力トランス BN43-202 1:1（2 次センタータップにバイアス）、
    ゲートストッパー 10Ω・スワンプ 22Ω 1/2W × 2、出力トランス BN43-202 1 次 2 回センタータップ（13.8V 給電）・2 次 3 回（1:2.25）。
    旧ドレインチョーク FT50-43 と結合コンデンサは削除。29MHz・13.8V では出力 約 5W の見込み（仕様を 10W → 約 5W に）
    - IRF510 はタブ =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
2026-10-28 ファイナルを MRF101AN に変更（10W に戻す）
    - ファイナル: IRF510 × 2 プッシュプル → MRF101AN（NXP LDMOS、TO-220）1 個。回路は RD16HHF1 のときと同じ単段 AB 級
    （ゲートストッパー 10Ω、スワンプ 100Ω 1/2W × 2、ドレインチョーク FT50-43 8 回、結合 0.1µF、BN43-202 2 回:5 回で 8Ω → 50Ω）。
    ピンは 1 = G・2 = S・3 = D、タブ = ソースで RD16HHF1 と同じなので絶縁不要。アイドル 約 200mA（VGS(th) 1.7〜2.7V）
    - ドライバ Q12 は IRF510 のまま（HS1 から絶縁）。入力トランス・ファイナル B・22Ω × 2・センタータップ付きフットプリントを削除
    - 基板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
2026-10-28 ファイナルを IRF510 プッシュプルに戻す（MRF101AN は高価なため）
    - cfc4ac1（MRF101AN）を取り消し、0b510b6 の IRF510 × 2 プッシュプル（約 5W）に戻した。
    回路・基板・部品表・README などは 0b510b6 と同じ。ERC 0・照合 882 ピン一致、DRC エラー 0・未接続 0・食い違い 0
    - 残っていた「10W」の表記を直した: 回路図の題名・docx の副題を「29MHz FM 5W トランシーバ」に、
    ケース前面の刻印を「29MHz FM 5W」に（前面パネル STL を再出力）
    - A3 配置図の注記を「DC・ファイナル IRF510・ANT」に
2026-10-28 購入用部品表のめがねコアの備考を修正
    T1・T2（BN-43-202）の備考が単段のときの「一次 2 回・二次 5 回」のままだったので、
    「巻き方は各トランスの備考と README のコイル表のとおり」に変更
2026-10-28 部品個数まとめを追加（同じ品を 1 行にまとめた合計個数・買う数）
    - tools/make_bom_summary.py: kicad/bom_purchase.csv から、同じ購入先の型番の行をまとめて
    合計個数・買う数（入数で切り上げ、ピンヘッダはピン数から）・金額を出す（PSN_TRX と同じスクリプト）
    - kicad/部品個数まとめ.md・bom_summary.csv: 出力（回路図の部品 122 種類・328 個、価格が分かっている品 17,310 円）
